glanceneuro/glance-neuro/firmware/include/main.h

#define MAIN_H
#include <stdint.h>
#include "xparameters.h"
#include "xiltimer.h"
#include "lwip/udp.h"
#include "netif/xadapter.h"
#define UDP_PORT 0x6800   // 26624 -- unified data stream (broadband + LFP)
#define TCP_PORT 0x6900   // 26880 -- control channel
#define DEFAULT_UDP_DEST_IP_A   192
#define DEFAULT_UDP_DEST_IP_B   168
#define DEFAULT_UDP_DEST_IP_C   18
#define DEFAULT_UDP_DEST_IP_D   100
#define DEFAULT_UDP_DEST_PORT   0x6800   // 26624 (== UDP_PORT)
#define BEACON_PORT     0x6880   // 26752 -- discovery beacon (subnet broadcast)
#define BEACON_MAGIC    0x4B4C4231u   // distinctive discovery magic ("KLB1")
#define BEACON_VERSION  1
typedef struct {
    uint32_t magic;       // BEACON_MAGIC
    uint32_t version;     // BEACON_VERSION
    uint32_t ip;          // board IPv4, network byte order (== datagram source)
    uint16_t tcp_port;    // control port (TCP_PORT, 0x6900)
    uint16_t udp_port;    // unified data port (UDP_PORT, 0x6800)
    uint32_t fw_version;  // FIRMWARE_VERSION_WORD (maj<<24|min<<16|patch<<8|build)
    uint8_t  mac[6];      // board MAC = unique device id
    uint16_t reserved;    // pad to 28 bytes / 4-byte multiple
} device_beacon_t;
void beacon_init(void);   // create the beacon PCB + compute the broadcast addr
void beacon_send(void);   // broadcast one beacon (call ~1 Hz while link is up)
#define ARM1_BASEADDR 0xFFFFFFF0
#define ARM1_STARTADR 0x20000000
#define sev() __asm__("sev")
#define BRAM_BASE_ADDR          0x80000000
#define BYTES_PER_WORD          4           // 32-bit words
#define BRAM_SIZE_WORDS         16384       // 16384 x 32-bit words (64KB)
#define BRAM_SIZE_BYTES         (BRAM_SIZE_WORDS * BYTES_PER_WORD)   // 64KB
#define UNIFIED_MAGIC           0xCAFEBABE
#define UNIFIED_VERSION         1
#define UNIFIED_HEADER_WORDS    8
#define STREAM_TYPE_BROADBAND   1
#define STREAM_TYPE_LFP         2
#define BB_SUBBLOCK_WORDS       6
#define PACKET_HEADER_WORDS     (UNIFIED_HEADER_WORDS + BB_SUBBLOCK_WORDS) // 14
#define MAX_PACKET_DATA_WORDS   140         // Maximum data words (all 8 streams = both ports)
#define MIN_PACKET_DATA_WORDS   18          // Minimum data words (1 stream enabled)
#define MAX_WORDS_PER_PACKET    (PACKET_HEADER_WORDS + MAX_PACKET_DATA_WORDS) // 154 words
#define MIN_WORDS_PER_PACKET    (PACKET_HEADER_WORDS + MIN_PACKET_DATA_WORDS) // 32 words
#define BRAM_READ_DMA     0
#define BRAM_READ_SINGLE  1
#define BRAM_READ_METHOD  BRAM_READ_DMA
#define PL_CTRL_BASE_ADDR 0x40000000
#define PL_N_CTRL_REGS      28
#define CTRL_REG_0_OFFSET   (0 * 4)   // Enable transmission, reset timestamp, debug mode
#define CTRL_REG_1_OFFSET   (1 * 4)   // Loop count
#define CTRL_REG_2_OFFSET   (2 * 4)   // Phase select, channel enable
#define CTRL_REG_3_OFFSET   (3 * 4)   // Analytic chirp NCO config (see data_generator_core.sv)
#define CTRL_REG_MOSI_START_OFFSET  (CTRL_REG_0_OFFSET + (4 * 4)) // Offset for MOSI control words
#define CTRL_CHIRP_MODE          (1u << 0)
#define CTRL_CHIRP_STRIDE_SHIFT  2
#define CTRL_CHIRP_STRIDE_MASK   (0x3Fu << 2)
#define CTRL_CHIRP_FSPAN_SHIFT   8
#define CTRL_CHIRP_FSPAN_MASK    (0xFFFu << 8)
#define CTRL_CHIRP_RATE_SHIFT    20
#define CTRL_CHIRP_RATE_MASK     (0xFFFu << 20)
#define CTRL_REG_AUX_CTRL_OFFSET    (22 * 4)  // prog bank select + fast settle/digout/dsp config
#define CTRL_REG_AUX_WRITE_OFFSET   (23 * 4)  // write port payload (RT reg / program)
#define CTRL_REG_AUX_STROBE_OFFSET  (24 * 4)  // write/inject toggles + inject command
#define CTRL_REG_LFP_CFG_OFFSET     (25 * 4)  // [0]en [15:8]lane_mask [23:16]decim_R [31:24]num_taps
#define CTRL_REG_LFP_COEF_OFFSET    (26 * 4)  // [17:0] signed Q1.17 coefficient data
#define CTRL_REG_LFP_STROBE_OFFSET  (27 * 4)  // [0] coef toggle, [1] ptr clear, [2] stage select
#define LFP_STROBE_COEF_TOGGLE      (1u << 0)
#define LFP_STROBE_PTR_CLR          (1u << 1)
#define LFP_STROBE_STAGE_SEL        (1u << 2)  // 0 = stage 1 halfband, 1 = stage 2 decimator
#define LFP_DECIM_STAGE1            2       // halfband:  30 kHz -> 15 kHz
#define LFP_DECIM_STAGE2            5       // decimator: 15 kHz ->  3 kHz
#define LFP_DECIM_TOTAL             (LFP_DECIM_STAGE1 * LFP_DECIM_STAGE2)  // 10
#define LFP_HB_TAPS                 11      // stage-1 length (fixed)
#define LFP_MAX_POLY_TAPS           120     // stage-2 maximum length
#define LFP_STAGE_HALFBAND          0
#define LFP_STAGE_DECIMATOR         1
#define LFP_BRAM_BASE_ADDR          0x84000000
#define LFP_BRAM_SIZE_WORDS         16384      // 64 KB ring of 32-bit words (2x16-bit samples)
#define AUX_CTRL_BANK_BIT(slot)     (1u << (slot))   // slot == 0 -> reg22 bit 0
#define AUX_CTRL_BANK_SEL_MASK      (0x1u << 0)       // [0] only
#define AUX_CTRL_FS_SW              (1u << 4)  // software amp fast settle level
#define AUX_CTRL_FS_GPIO_EN         (1u << 5)
#define AUX_CTRL_FS_GPIO_SEL_SHIFT  6          // [8:6] digital_in pin select
#define AUX_CTRL_FS_GPIO_SEL_MASK   (0x7u << 6)
#define AUX_CTRL_DSP_SW             (1u << 9)  // software DSP-reset (CONVERT bit H) level
#define AUX_CTRL_DSP_GPIO_EN        (1u << 10)
#define AUX_CTRL_DSP_GPIO_SEL_SHIFT 11         // [13:11]
#define AUX_CTRL_DSP_GPIO_SEL_MASK  (0x7u << 11)
#define AUX_CTRL_DIGOUT_SW          (1u << 14) // software digout level
#define AUX_CTRL_DIGOUT_GPIO_EN     (1u << 15)
#define AUX_CTRL_DIGOUT_GPIO_SEL_SHIFT 16      // [18:16]
#define AUX_CTRL_DIGOUT_GPIO_SEL_MASK  (0x7u << 16)
#define AUX_CTRL_REG3_STATIC_SHIFT  24         // [31:24] RHD Reg-3 bits D7..D1 (D0 = live digout)
#define AUX_CTRL_REG3_STATIC_MASK   (0xFFu << 24)
#define AUX_WRITE_PACK(target, bank, is_len, addr, data) \
    ( ((uint32_t)(data) & 0xFFFFu)            | \
      (((uint32_t)(addr) & 0x3Fu)   << 16)    | \
      (((uint32_t)(target) & 0x3u)  << 22)    | \
      (((uint32_t)(bank) & 0x1u)    << 24)    | \
      (((uint32_t)(is_len) & 0x1u)  << 25) )
#define AUX_LENGTH_DATA(loop_idx, end_idx) \
    ( ((uint32_t)(loop_idx) & 0x3Fu) | (((uint32_t)(end_idx) & 0x3Fu) << 8) )
#define AUX_STROBE_WRITE_TOGGLE     (1u << 0)
#define AUX_STROBE_INJECT_TOGGLE    (1u << 1)
#define AUX_STROBE_INJECT_CMD_SHIFT 16         // [31:16] injected command (slot-2 one-shot)
#define AUX_BANK_ENTRIES            64
#define STATUS_REG_BASE      (PL_N_CTRL_REGS * 4)
#define STATUS_REG_0_OFFSET  (STATUS_REG_BASE + 0 * 4)   // Dynamic status + counters
#define STATUS_REG_1_OFFSET  (STATUS_REG_BASE + 1 * 4)   // Reflected control parameters
#define STATUS_REG_2_OFFSET  (STATUS_REG_BASE + 2 * 4)   // Packets sent
#define STATUS_REG_3_OFFSET  (STATUS_REG_BASE + 3 * 4)   // Timestamp low [31:0]
#define STATUS_REG_4_OFFSET  (STATUS_REG_BASE + 4 * 4)   // Timestamp high [63:32]
#define STATUS_REG_5_OFFSET  (STATUS_REG_BASE + 5 * 4)   // Loop count (registered)
#define STATUS_REG_6_OFFSET  (STATUS_REG_BASE + 6 * 4)   // Mirror of CTRL_REG_0 (enable, reset, etc.)
#define STATUS_REG_7_OFFSET  (STATUS_REG_BASE + 7 * 4)   // Mirror of CTRL_REG_1 (loop count)
#define STATUS_REG_8_OFFSET  (STATUS_REG_BASE + 8 * 4)   // Mirror of CTRL_REG_2 (phase select, debug mode)
#define STATUS_REG_9_OFFSET  (STATUS_REG_BASE + 9 * 4)   // Mirror of CTRL_REG_3 (reserved)
#define STATUS_REG_10_OFFSET (STATUS_REG_BASE + 10 * 4)  // BRAM write address + FIFO count (added by wrapper)
#define STATUS_REG_11_OFFSET (STATUS_REG_BASE + 11 * 4)  // Aux sequencer status
#define STATUS_REG_12_OFFSET (STATUS_REG_BASE + 12 * 4)  // Aux injected-command read result
#define STATUS_REG_13_OFFSET (STATUS_REG_BASE + 13 * 4)  // LFP: [15:0] BRAM wr byte-addr, [16] overrun
#define AUX_STATUS_BANK_ACTIVE_MASK  0x7u      // [2:0] active bank per slot (bit0=slot0 program)
#define AUX_STATUS_ENGINE_ON         (1u << 3) // always 1 (aux engine always on)
#define AUX_STATUS_FS_ACTIVE         (1u << 4)
#define AUX_STATUS_DIGOUT            (1u << 5)
#define AUX_STATUS_DSP_ACTIVE        (1u << 6)
#define AUX_STATUS_INJECT_ACK        (1u << 7) // toggles when an injection result lands
#define AUX_STATUS_IDX0_SHIFT        8         // [13:8]  slot-0 program index
#define AUX_STATUS_IDX1_SHIFT        16        // [21:16] slot-1 index (always 0: fs register)
#define AUX_STATUS_IDX2_SHIFT        24        // [29:24] slot-2 index (always 0: inject register)
#define AUX_STATUS_IDX_MASK          0x3Fu
#define RHD_CMD_CONVERT(ch)     ((uint16_t)(((ch) & 0x3F) << 8))
#define RHD_CMD_WRITE(reg, val) ((uint16_t)(0x8000 | (((reg) & 0x3F) << 8) | ((val) & 0xFF)))
#define RHD_CMD_READ(reg)       ((uint16_t)(0xC000 | (((reg) & 0x3F) << 8)))
#define CTRL_ENABLE_TRANSMISSION (1 << 0)
#define CTRL_RESET_TIMESTAMP     (1 << 1)
#define CTRL_DEBUG_MODE          (1 << 3)   // Debug mode (send dummy data) [3]
#define CTRL_PHASE0_MASK         (0xF << 0)   // phase_a0 [3:0]   (cable A, line 0)
#define CTRL_PHASE1_MASK         (0xF << 4)   // phase_a1 [7:4]   (cable A, line 1)
#define CTRL_PHASE2_MASK         (0xF << 8)   // phase_b0 [11:8]  (cable B, line 0)
#define CTRL_PHASE3_MASK         (0xF << 12)  // phase_b1 [15:12] (cable B, line 1)
#define CTRL_CHANNEL_ENABLE_MASK (0xFF << 16) // channel_enable [23:16]
#define CTRL_CHANNEL_ENABLE_SHIFT 16
#define STATUS_TRANSMISSION_ACTIVE   (1 << 0)
#define STATUS_LOOP_LIMIT_REACHED    (1 << 1)
#define STATUS_STATE_COUNTER_MASK    (0x7F << 3)  // [9:3] - 7 bits
#define STATUS_STATE_COUNTER_SHIFT   3
#define STATUS_CYCLE_COUNTER_MASK    (0x3F << 11) // [16:11] - 6 bits
#define STATUS_CYCLE_COUNTER_SHIFT   11
#define STATUS_ENABLE_TRANSMISSION_REG  (1 << 0)
#define STATUS_RESET_TIMESTAMP_REG      (1 << 1)
#define STATUS_DEBUG_MODE_REG           (1 << 3)
#define STATUS_PHASE0_REG_MASK          (0xF << 12) // [15:12] - 4 bits
#define STATUS_PHASE0_REG_SHIFT         12
#define STATUS_PHASE1_REG_MASK          (0xF << 16) // [19:16] - 4 bits
#define STATUS_PHASE1_REG_SHIFT         16
#define STATUS_CHANNEL_ENABLE_REG_MASK  (0xF << 20) // [23:20] - port-0 channel enable
#define STATUS_CHANNEL_ENABLE_REG_SHIFT 20
#define STATUS_CHANNEL_ENABLE_HI_REG_MASK  (0xF << 24) // [27:24] - port-1 channel enable
#define STATUS_CHANNEL_ENABLE_HI_REG_SHIFT 24
#define DEVICE_TYPE_INTAN_INTERFACE    0x1000
#define UDP_PACKET_FORMAT_V1           0x0001
#define PROTOCOL_VERSION               1
#define FIRMWARE_VERSION_MAJOR         3
#define FIRMWARE_VERSION_MINOR         0   // 3.0.0.0: the board is no longer one fixed fabric. It carries
#define FIRMWARE_VERSION_PATCH         0   // reset by the 3.0.0.0 MAJOR bump. (2.2.0.1 was
#define FIRMWARE_VERSION_BUILD         0
#define FIRMWARE_VERSION_WORD          ((FIRMWARE_VERSION_MAJOR << 24) | \
                                       (FIRMWARE_VERSION_MINOR << 16) | \
                                       (FIRMWARE_VERSION_PATCH << 8) | \
                                       FIRMWARE_VERSION_BUILD)
#define ACK_SUCCESS         0x06
#define ACK_ERROR           0x15
typedef struct __attribute__((packed)) {
    uint16_t version;
    uint16_t device_type;
    uint32_t firmware_version;
    uint64_t timestamp;
    uint32_t packets_sent;
    uint32_t bram_write_addr;
    uint16_t fifo_count;
    uint8_t  state_counter;
    uint8_t  cycle_counter;
    uint8_t  flags_pl;
    uint8_t  reserved1;
    uint32_t packets_received;
    uint32_t error_count;
    uint32_t udp_packets_sent;
    uint32_t udp_send_errors;
    uint32_t ps_read_addr;
    uint32_t packet_size;
    uint8_t  flags_ps;
    uint8_t  reserved2[3];
    uint32_t loop_count;
    uint8_t  phase0;
    uint8_t  phase1;
    uint8_t  channel_enable;
    uint8_t  debug_mode;
    uint32_t reserved3[2];
    uint32_t udp_dest_ip;
    uint16_t udp_dest_port;
    uint16_t udp_packet_format;
    uint32_t udp_bytes_sent;
    uint32_t aux_read_result;   // last injected command's response {cipo1, cipo0}
    uint8_t  aux_bank_active;   // [2:0] active bank per slot
    uint8_t  aux_flags;         // bit0 seq_en, bit1 fs_active, bit2 digout, bit3 dsp, bit4 inject_ack
    uint8_t  aux_idx[3];        // per-slot sequence index
    uint8_t  reserved5[3];
    uint32_t dma_errors;        // CDMA read failures since boot
    uint32_t dma_ticks_last;    // last CDMA transfer (ticks)
    uint32_t dma_ticks_max;     // worst CDMA transfer (ticks)
    uint32_t loop_ticks_last;   // last receive->transmit (ticks)
    uint32_t loop_ticks_max;    // worst receive->transmit (ticks; vs 33us budget)
    uint32_t timer_hz;          // tick frequency, for host ticks->us conversion
    uint32_t aux_ctrl;
    uint8_t  rhd_reg[22];
    uint8_t  lfp_enable;        // engine enabled
    uint8_t  lfp_lane_mask;     // which of 8 streams are LFP-filtered
    uint8_t  lfp_decim_R;       // decimation factor (packets per output)
    uint8_t  lfp_num_taps;      // active FIR length
    uint32_t lfp_packets_sent;  // LFP UDP packets emitted
    uint8_t  lfp_overrun;       // sticky compute-overrun flag
    uint8_t  lfp_reserved[3];
    uint8_t  chirp_mode;        // 1 = chirp debug signal enabled
    uint8_t  chirp_stride;      // per-channel phase stride (6-bit)
    uint16_t chirp_fspan;       // f_max field (12-bit)
    uint16_t chirp_rate;        // sweep_rate field (12-bit)
    uint8_t  chirp_reserved[2];
    uint32_t send_ticks_last;   // last udp_sendto() call (ticks)
    uint32_t send_ticks_max;    // worst udp_sendto() call (ticks)
    uint32_t over_budget_count; // packets whose loop_ticks exceeded the 33.3 us budget
    uint32_t worst_pkt_index;   // packets_received_count at the worst-loop packet
    uint32_t worst_cdma_ticks;  // that packet's CDMA time (ticks)
    uint32_t worst_send_ticks;  // that packet's udp_sendto time (ticks)
    uint32_t worst_other_ticks; // that packet's loop - cdma - send (ticks)
    uint32_t loop_hist[6];      // counts per bucket
    uint32_t bb_pbuf_alloc_fail;  // broadband: pbuf_alloc returned NULL
    uint32_t bb_send_err;         // broadband: udp_sendto() != ERR_OK
    int32_t  bb_last_send_err;    // broadband: last err_t (ERR_MEM = -1, ...)
    uint32_t lfp_pbuf_alloc_fail; // LFP: pbuf_alloc returned NULL
    uint32_t lfp_send_err;        // LFP: udp_sendto() != ERR_OK
    int32_t  lfp_last_send_err;   // LFP: last err_t
    uint32_t first_drop_pkt;      // packets_received_count at the first broadband drop
    uint32_t last_drop_pkt;       // ... at the most recent broadband drop
    uint32_t memp_num_pbuf;       // = MEMP_NUM_PBUF (shared zero-copy pool size)
    uint32_t drop_ring[8];        // last 8 broadband drop packet indices (clustering)
} status_response_t;
#define PERF_HIST_BUCKETS   6
#define STATUS_PL_TRANSMISSION_ACTIVE  (1 << 0)
#define STATUS_PL_LOOP_LIMIT_REACHED   (1 << 1)
#define STATUS_PS_STREAM_ENABLED       (1 << 0)
extern XTimer timer;
extern struct netif server_netif;
extern struct udp_pcb *udp;
extern volatile int stream_enabled;
extern uint32_t packets_received_count;
extern volatile int pl_is_acq;
extern volatile int pl_has_iic_a;
extern volatile int pl_has_iic_b;
extern volatile int pl_has_iic;
int pl_config_apply(uint32_t sel, uint32_t *out_bytes, uint8_t *out_is_acq);
int pl_current_config(void);   // -1 blank, else pl_configs index (for CMD_PL_STATUS)
extern volatile int enable_streaming_flag;
extern volatile int disable_streaming_flag;
extern volatile int reset_timestamp_flag;
extern volatile int cable_test_flag;
extern uint32_t ps_read_address;              // Current PS read position (word address)
extern uint32_t current_packet_size;          // Current expected packet size in 32-bit words
extern uint32_t current_channel_enable;       // Current channel enable setting
extern uint64_t expected_timestamp;
extern uint32_t error_count;
extern uint32_t timestamp_gaps;
extern uint32_t dma_errors;
extern uint32_t dma_ticks_last, dma_ticks_max;
extern uint32_t loop_ticks_last, loop_ticks_max;
extern uint32_t perf_timer_hz;
extern uint32_t send_ticks_last, send_ticks_max;
extern uint32_t over_budget_count;
extern uint32_t worst_pkt_index, worst_cdma_ticks, worst_send_ticks, worst_other_ticks;
extern uint32_t loop_hist[PERF_HIST_BUCKETS];
extern uint32_t bb_pbuf_alloc_fail, bb_send_err;
extern uint32_t bb_send_retries, bb_pbuf_retries, bb_send_recovered;
extern uint32_t staging_slot;   // rotating zero-copy staging-ring slot
extern int32_t  bb_last_send_err;
extern uint32_t lfp_pbuf_alloc_fail, lfp_send_err;
extern int32_t  lfp_last_send_err;
extern uint32_t first_drop_pkt, last_drop_pkt;
extern uint32_t drop_ring[8];
extern uint32_t drop_ring_idx;
void perf_reset(void);   // clear sticky maxes + histogram + counts (CMD_PERF_RESET)
extern uint32_t udp_packets_sent;
extern uint32_t udp_send_errors;
extern uint32_t udp_dest_ip;      // Network byte order
extern uint16_t udp_dest_port;
void handle_enable_streaming(void);
void handle_disable_streaming(void);
void handle_reset_timestamp(void);
void process_command_flags(void);
uint32_t calculate_packet_size(int channel_enable);
uint32_t calculate_data_words(int channel_enable);
void update_current_packet_size(void);
void network_maintenance_loop(void);
void pl_set_transmission(int enable);
void pl_reset_timestamp(void);
void pl_set_loop_count(uint32_t loop_count);
void pl_set_phase_select(int phase0, int phase1);
void pl_set_phase_select_b(int phase2, int phase3);  // port B (second cable)
void pl_set_debug_mode(int enable);
void pl_set_channel_enable(int channel_enable);
void pl_set_chirp(uint8_t mode, uint8_t stride, uint16_t fspan, uint16_t rate);  // CTRL_REG_3
uint32_t pl_get_chirp_cfg(void);  // raw CTRL_REG_3 read-back
extern uint8_t  chirp_cfg_mode, chirp_cfg_stride;
extern uint16_t chirp_cfg_fspan, chirp_cfg_rate;
uint64_t pl_get_timestamp(void);
int pl_is_transmission_active(void);
uint32_t pl_get_packets_sent(void);
int pl_is_loop_limit_reached(void);
uint32_t pl_get_bram_write_address(void);
uint32_t pl_get_state_counter(void);
uint32_t pl_get_cycle_counter(void);
uint32_t pl_get_current_loop_count(void);
int pl_get_current_phase_select(int *phase0, int *phase1);
int pl_get_current_debug_mode(void);
int pl_get_current_channel_enable(void);
uint32_t pl_get_current_control_flags(void);
void pl_print_status(void);
void pl_dump_bram_data(uint32_t start_addr, uint32_t word_count);
void pl_set_copi_commands(const uint16_t copi_array[32]);
int pl_set_copi_commands_safe(const uint16_t copi_array[32], const char* sequence_name);
void pl_set_convert_sequence(void);
void pl_set_initialization_sequence(void);
void pl_rhd_shadow_init(void);          // seed the RHD register shadow from the init sequence
extern uint8_t rhd_reg_shadow[22];      // mirror of RHD regs 0..21 (commanded state)
void pl_set_cable_length_sequence(void);
void pl_aux_write_word(int slot, int bank, int addr, uint16_t data);
void pl_aux_write_length(int slot, int bank, int loop_idx, int end_idx);
int  pl_aux_upload_bank(int slot, int bank, const uint16_t *cmds, int n, int loop_idx);
void pl_aux_select_bank(int slot, int bank);
int  pl_aux_confirm_bank(int slot, int bank, int timeout_ms);
void pl_aux_set_fast_settle(uint32_t cfg);   // AUX_CTRL fs/dsp bit fields [13:4]
void pl_aux_set_digout(uint32_t cfg);        // AUX_CTRL digout fields [18:14] + reg3_static [31:24]
int  pl_aux_inject(uint16_t cmd, uint32_t *result, int timeout_ms);
int  pl_read_rhd_register(int reg, uint32_t *result);
int  pl_write_rhd_register(int reg, uint8_t value, uint32_t *result);
void pl_run_full_cable_test(void);
extern const uint16_t convert_cmd_sequence[32];
extern const uint16_t initialization_cmd_sequence[32];
extern const uint16_t cable_length_cmd_sequence[32];
uint32_t sys_now(void);
void start_tcp_server(void);
void broadband_stream_init(void);   // creates the broadband UDP pcb (stream_type=1)
int udp_reconfigure_destination(uint32_t new_ip, uint16_t new_port);
int is_valid_udp_dest(uint32_t ip, uint16_t port);
void collect_status_data(status_response_t* status);
void abort_tcp_connections(void);
void stop_tcp_server(void);
void stop_udp_stream(void);
void pl_lfp_set_config(uint8_t enable, uint8_t num_taps);  // decimation is structural (/10)
void pl_lfp_coef_begin(int stage);                        // select a filter, clear its write pointer
void pl_lfp_coef_push(int32_t coef);                      // write one 18-bit Q1.17 tap
void pl_lfp_upload_coeffs(int stage, const int32_t *coeffs, int n);  // begin + push array
uint32_t pl_lfp_read_status(void);                        // STATUS_REG_13
void broadband_stream_service(void);   // broadband: drain every ready packet
void lfp_stream_init(void);
void lfp_stream_service(void);   // call from the core-0 main loop, after broadband
void lfp_stream_resync(void);    // re-align the PS read pointer after a lane-mask change
extern uint8_t  lfp_cfg_enable, lfp_cfg_decim_R, lfp_cfg_num_taps;
extern uint32_t lfp_udp_packets_sent;
