glanceneuro/glance-neuro/firmware/src-core0/main.c

// SPDX-License-Identifier: MIT
// SPDX-FileCopyrightText: 2025-2026 Caleb Kemere, Reet Sinha, Allen Mikhailov, Rice University

#include "main.h"
#include "platform.h"
#include "pl_stim.h"
#include "sleep.h"
#include <string.h>
#include <stdio.h>
#include "xil_io.h"
#include "xil_cache.h"
#include "lwip/init.h"
#include "lwip/timeouts.h"
#include "lwip/etharp.h"   // etharp_gratuitous() -- proactively refresh host ARP
//#include "xuartps.h"
#include "shared_print.h"
#include "pl_dma.h"
#include "pl_loader.h"  // deferred fabric load from SD via PCAP (docs/boot.md)
#include "pl_imu_stream.h"  // continuous BNO055 readout (stream_type=3)
#include "xiltimer.h"  // XTime_GetTime / COUNTS_PER_SECOND for perf instrumentation

// How long to wait for PHY link before continuing boot. Bounded so a board with
// no cable still reaches the point where core 1 wakes and the serial console
// starts -- see the wait loop for why that matters.
#define LINK_WAIT_TIMEOUT_S 20

// Forward declare eth_link_detect from xemacpsif adapter
// This function is provided by the LWIP library's Xilinx EMAC adapter
extern void eth_link_detect(struct netif *netif);


// Global variables
XTimer timer;
struct netif server_netif;
struct udp_pcb *udp;
volatile int stream_enabled = 0;
uint32_t packets_received_count = 0;


// Link state tracking for hotplug support
volatile int link_is_up = 0;

// Command flags for main loop processing
volatile int enable_streaming_flag = 0;
volatile int disable_streaming_flag = 0;
volatile int reset_timestamp_flag = 0;
volatile int cable_test_flag = 0;

// BRAM state tracking
uint32_t ps_read_address = 0;              // Current PS read position (word address)
uint32_t staging_slot = 0;                 // rotating DDR staging-ring slot (zero-copy TX aliasing fix)
uint32_t current_packet_size = 84;         // 14-word header + 70 data words (0x0F default); recomputed on start
uint32_t current_channel_enable = 0x0F;    // Current channel enable setting (default all channels)

// Packet validation tracking
uint32_t error_count = 0;
uint32_t dma_errors = 0;   // CDMA read failures (BRAM_READ_DMA path)

// Performance instrumentation, observable via get_status. We store raw global-
// timer TICKS at full resolution and let the host convert to microseconds using
// perf_timer_hz (sent in the status) -- store the measurement, derive the
// display. The 30 kHz sample rate gives a 33.3 us budget per packet; loop_ticks
// is the receive->transmit time and dma_ticks is the CDMA transfer within it.
uint32_t dma_ticks_last = 0, dma_ticks_max = 0;     // CDMA transfer (ticks)
uint32_t loop_ticks_last = 0, loop_ticks_max = 0;   // receive->transmit (ticks)
uint32_t perf_timer_hz = 0;                         // tick freq (set in main())
// recv->transmit spike instrumentation. Split the recv->transmit window into the
// CDMA, udp_sendto, and "other" components so the host can attribute the
// occasional ~40 us spike; capture the worst packet's breakdown and a histogram
// + over-budget count for the tail's shape/frequency. Cleared by perf_reset().
uint32_t send_ticks_last = 0, send_ticks_max = 0;   // udp_sendto() call (ticks)
uint32_t over_budget_count = 0;                     // packets over the 33.3 us budget
uint32_t worst_pkt_index = 0;                       // packet idx of the worst loop
uint32_t worst_cdma_ticks = 0, worst_send_ticks = 0, worst_other_ticks = 0;
uint32_t loop_hist[PERF_HIST_BUCKETS] = {0};        // recv->transmit time distribution

// TX drop diagnostics: split udp_send_errors by stream + failure mode and
// record WHEN drops happen. Each zero-copy PBUF_REF send holds one MEMP_PBUF
// entry (MEMP_NUM_PBUF, shared by broadband + LFP) until the GEM TX-done reaps
// it; pbuf_alloc()==NULL => that pool is momentarily empty. Declared before
// perf_reset() so it can clear them. Cleared by CMD_PERF_RESET.
uint32_t bb_pbuf_alloc_fail = 0, bb_send_err = 0;
int32_t  bb_last_send_err = 0;
// NO-LOSS retry stats: bb_send_err counts only drops that survived every retry.
uint32_t bb_send_retries = 0, bb_pbuf_retries = 0, bb_send_recovered = 0;
uint32_t lfp_pbuf_alloc_fail = 0, lfp_send_err = 0;
int32_t  lfp_last_send_err = 0;
uint32_t first_drop_pkt = 0, last_drop_pkt = 0;
uint32_t drop_ring[8] = {0};
uint32_t drop_ring_idx = 0;
// If this fails, the wire layout changed -- update net.py get_status (the length
// check and the struct.unpack offsets) to match.
_Static_assert(sizeof(status_response_t) == 288, "status_response_t size must match net.py get_status");

// Clear the sticky maxes + worst-case snapshot + histogram + counts so the user
// controls the measurement window (CMD_PERF_RESET). Leaves the last-sample fields
// and dma_errors alone -- those self-refresh / are lifetime counters.
void perf_reset(void) {
  dma_ticks_max = 0;
  loop_ticks_max = 0;
  send_ticks_max = 0;
  over_budget_count = 0;
  worst_pkt_index = 0;
  worst_cdma_ticks = worst_send_ticks = worst_other_ticks = 0;
  for (int i = 0; i < PERF_HIST_BUCKETS; i++) loop_hist[i] = 0;
  // TX drop diagnostics
  bb_pbuf_alloc_fail = bb_send_err = 0; bb_last_send_err = 0;
  lfp_pbuf_alloc_fail = lfp_send_err = 0; lfp_last_send_err = 0;
  first_drop_pkt = last_drop_pkt = 0; drop_ring_idx = 0;
  for (int i = 0; i < 8; i++) drop_ring[i] = 0;
}


// UDP transmission
uint32_t udp_packets_sent = 0;
uint32_t udp_send_errors = 0;
// UDP configuration (can be changed via TCP command)
uint32_t udp_dest_ip = 0;      // Will be initialized in main()
uint16_t udp_dest_port = DEFAULT_UDP_DEST_PORT;


// The two stream services live in stream.c; the capture-BRAM read method they
// use is selected in main.h.

// ============================================================================
// PACKET SIZE CALCULATION FUNCTIONS
// ============================================================================

uint32_t calculate_data_words(int channel_enable) {
    int num_channels = 0;
    
    // Count enabled 16-bit streams across both ports (8-bit mask)
    for (int b = 0; b < 8; b++)
        if (channel_enable & (1 << b)) num_channels++;

    if (num_channels == 0) {
        send_message("WARNING: No channels enabled, defaulting to port-0 all channels\r\n");
        return 70; // Default to 4 streams (port 0) x 35 cycles / 2
    }
    
    // Calculate 32-bit words needed for the data
    // Each cycle produces num_channels × 16-bit words
    // Total 16-bit words = 35 × num_channels
    // Convert to 32-bit words with proper rounding up
    uint32_t total_16bit_words = 35 * num_channels;
    uint32_t data_32bit_words = (total_16bit_words + 1) / 2;  // Round up division
    
    return data_32bit_words;
}

uint32_t calculate_packet_size(int channel_enable) {
    return PACKET_HEADER_WORDS + calculate_data_words(channel_enable);
}

void update_current_packet_size(void) {
    uint32_t new_channel_enable = pl_get_current_channel_enable();
    
    if (new_channel_enable != current_channel_enable) {
        current_channel_enable = new_channel_enable;
        current_packet_size = calculate_packet_size(current_channel_enable);
        
        send_message("Updated packet size: channel_enable=0x%X, packet_size=%u words (%u bytes)\r\n",
                     current_channel_enable, current_packet_size, current_packet_size * 4);
    }
}

// ============================================================================
// BRAM ACCESS FUNCTIONS
// ============================================================================


// Check how many complete packets are available to read


// ============================================================================
// STREAMING CONTROL
// ============================================================================

// ============================================================================
// PL CONFIGURATION SWAP (docs/boot.md)
// ============================================================================
// The shared 2nd-CIPO lane is LVDS (128-ch) or single-ended (I2C IMU / 64-ch)
// per port; IOSTANDARD is fixed per bitstream, so changing a port's mode means
// PCAP-loading a different full bitstream. We only swap when NOT streaming (so
// nothing is in flight on the PL AXI) and reset the master timestamp on each
// swap so the host sees a fresh epoch.

// 1 while an acquisition fabric is live -- gates every PL-touching service so a
// scan (non-acq) fabric, or a mid-swap teardown, can't hang the core on AXI to
// registers that aren't there.
volatile int pl_is_acq = 0;

// Per-port: 1 while the loaded fabric exposes that cable's AXI IIC (port A at
// 0x43D0, port B at 0x43D1) for a BNO055. CMD_DETECT_IMU probes a port ONLY if
// its flag is set: a mixed fabric (acq_imu_port_a/_b) carries one IIC and leaves
// the other port 128-ch LVDS with NO I2C, and touching that absent AXI slave
// hangs the core forever. pl_has_iic is the OR (any IIC present) that gates the
// command itself so plain acq -- which has neither -- refuses it outright.
volatile int pl_has_iic_a = 0;
volatile int pl_has_iic_b = 0;
volatile int pl_has_iic   = 0;

// selector -> SD file (no .bin), is it an acquisition fabric, does it carry the
// AXI IICs? Selectors are append-only so the host mapping (net.py CONFIGS) stays
// stable. Later variants add acq_imu_port_a / _b (one IIC + one 128-ch LVDS port).
// The `file` field MUST be an 8.3 short name (<=8-char base): the loader's xilffs
// is built with FF_USE_LFN=0, so f_open on a longer name fails PL_ERR_OPEN even
// when the file is present. Hence acq_imu_both's blob is "aimuboth.bin", not
// "acq_imu_both.bin" (12-char base). The host-facing `name` is unconstrained.
typedef struct { const char *name; const char *file; int is_acq; int iic_a; int iic_b; } pl_config_t;
static const pl_config_t pl_configs[] = {
  { "acquisition",    "acq",      1, 0, 0 },   // 128-ch LVDS acquisition, no IMU
  { "acq_imu_both",   "aimuboth", 1, 1, 1 },   // both cables 64-ch + a BNO055 each
  { "acq_imu_port_a", "aimu_a",   1, 1, 0 },   // port A 64-ch + IMU (iic_a), port B 128-ch LVDS
  { "acq_imu_port_b", "aimu_b",   1, 0, 1 },   // port A 128-ch LVDS, port B 64-ch + IMU (iic_b)
};
#define PL_NUM_CONFIGS ((uint32_t)(sizeof(pl_configs) / sizeof(pl_configs[0])))
// Which fabric BOOT.bin bakes in (scripts/boot_acq_loader.bif stages the matching
// .bit). Keep the two in step: this only names what the FSBL already loaded, so a
// mismatch would have the firmware describe the PL wrongly, not misconfigure it.
#define PL_CONFIG_BAKED 0   /* "acquisition" -- 128-ch, works with any headstage */
static int current_config = -1;

// Which fabric the loader last programmed (-1 = none/blank, else a pl_configs
// index). Read-only accessor for CMD_PL_STATUS: it reads this firmware state, not
// PL registers, so a reconnecting host can learn the config in ANY fabric state.
int pl_current_config(void) { return current_config; }

// Acquisition PL init, split so boot can keep the known-good 2c-i ordering:
//  - early: CDMA + LFP config. At boot this runs BEFORE the network (load-first,
//    for link stability); its few send_messages match what 2c-i buffered.
//  - late: the send_message-HEAVY register setup. At boot this must run AFTER
//    core1 is awake and draining the print ring -- running it before core1
//    flooded the ring and raced core0/core1 on the shared UART, hanging the boot.
// A runtime swap (core1 long since up) just calls the full acq_pl_bringup().
static void acq_pl_init_early(void) {
#if BRAM_READ_METHOD == BRAM_READ_DMA
  pl_dma_init();  // AXI CDMA + non-cacheable DDR staging buffer for the read path
#endif
  pl_lfp_set_config(/*enable=*/0, /*num_taps=*/LFP_MAX_POLY_TAPS);
}
static void acq_pl_init_late(void) {
  pl_set_transmission(0);
  pl_set_loop_count(0);
  update_current_packet_size();
  pl_set_copi_commands(initialization_cmd_sequence);
  pl_stim_boot_init();  // DAC to its safe state (docs/stim.md)
}
static void acq_pl_bringup(void) { acq_pl_init_early(); acq_pl_init_late(); }

// Load the config with the given selector via PCAP. Caller MUST guarantee we are
// not streaming. Resets the master timestamp on a successful acquisition load.
// Returns 0 ok, positive pl_status_t on load failure, -1 on a bad selector.
int pl_config_apply(uint32_t sel, uint32_t *out_bytes, uint8_t *out_is_acq) {
  if (sel >= PL_NUM_CONFIGS) return -1;
  const pl_config_t *c = &pl_configs[sel];
  if (out_is_acq) *out_is_acq = (uint8_t)c->is_acq;
  // Shut the serial console's INPUT for the duration. Clearing the PL floats
  // the EMIO UART RX ball, and core 1 would otherwise parse the resulting noise
  // as a debug command -- "dump" with a garbage count, or "start" -- either of
  // which leaves the board unresponsive. Output is unaffected (it is merely
  // lost on the wire while the pins are gone).
  command_flags->serial_input_ok = 0;
  pl_imu_stream_stop_all();              // the IICs it polls are about to vanish
  pl_is_acq = 0;                         // tearing the PL down -> stop touching it
  pl_has_iic_a = pl_has_iic_b = pl_has_iic = 0;  // its IICs are gone until reloaded
  uint32_t bytes = 0;
  pl_status_t st = pl_loader_load(c->file, &bytes);
  if (out_bytes) *out_bytes = bytes;
  if (st != PL_OK) {
    current_config = -1;
    command_flags->serial_input_ok = 1;   // failed load: pins are as they were
    return (int)st;
  }
  current_config = (int)sel;
  pl_has_iic_a = c->iic_a;               // per-port IIC presence (0x43D0 / 0x43D1)
  pl_has_iic_b = c->iic_b;
  pl_has_iic   = c->iic_a || c->iic_b;   // any IIC -> CMD_DETECT_IMU is allowed
  // The fabric is back, so the console pins are real again. Core 1 flushes
  // whatever noise arrived while the gate was shut before honouring input.
  command_flags->serial_input_ok = 1;
  if (c->is_acq) {
    acq_pl_bringup();
    pl_reset_timestamp();                // new fabric -> fresh timeline for the host
    pl_is_acq = 1;
  }
  send_message("Config '%s' loaded (%lu bytes)%s\r\n", c->name,
               (unsigned long)bytes,
               c->is_acq ? ", acquisition ready" : " (non-acquisition fabric)");
  return 0;
}

void handle_enable_streaming(void) {
  if (stream_enabled) {
    send_message("Streaming already enabled\r\n");
    return;
  }
  if (!pl_is_acq) {
    send_message("Cannot start: no acquisition fabric loaded (set_config first)\r\n");
    return;
  }

    // Update packet size before starting streaming
    update_current_packet_size();
  
  // Reset state
  packets_received_count = 0;
  error_count = 0;
  udp_packets_sent = 0;
  udp_send_errors = 0;
  
  // Reset PL
  pl_set_transmission(0);
  usleep(100);
  pl_reset_timestamp();
  usleep(1000);

  // Enable streaming
  stream_enabled = 1;
  pl_set_transmission(1);

  // Re-sync ps_read to a REAL packet boundary by scanning for the header.
  // A stop can interrupt the datapath mid-packet; since write_address, the
  // packet boundary, and the (intentionally unreset) FIFO are only cleared by
  // the hardware reset -- not by stop/restart -- the fresh header on restart can
  // land a few words off packet_boundary_address. Setting ps_read to the
  // pointer then mis-aligns and the header check loops forever. So: let the PL
  // write several packets, then walk back from the write pointer to the nearest
  // unified header (word0=MAGIC, word1=broadband TYPE_VER) and align to it
  // (single Xil_In32 reads are clean).
  usleep(3000);  // ~90 packets @30ksps -- guarantees fresh complete packets
  uint32_t wp = pl_get_bram_write_address();
  uint32_t expected_typever =
      (uint32_t)STREAM_TYPE_BROADBAND | ((uint32_t)UNIFIED_VERSION << 8);
  int synced = 0;
  for (uint32_t back = 0; back < 2 * current_packet_size + 16; back++) {
    uint32_t a = (wp + BRAM_SIZE_WORDS - back) % BRAM_SIZE_WORDS;
    uint32_t b = (a + 1) % BRAM_SIZE_WORDS;
    if (Xil_In32(BRAM_BASE_ADDR + a * 4) == UNIFIED_MAGIC &&                       // word0 MAGIC  // DMA-EXEMPT: 2-word resync header peek (clean 1-beat reads while re-aligning ps_read)
        (Xil_In32(BRAM_BASE_ADDR + b * 4) & 0xFFFFu) == (expected_typever & 0xFFFFu)) { // word1 TYPE_VER // DMA-EXEMPT: 2-word resync header peek (clean 1-beat reads while re-aligning ps_read)
      ps_read_address = a;
      synced = 1;
      break;
    }
  }
  if (!synced) {
    ps_read_address = wp;   // fallback; the magic-fail recovery will retry
    send_message("Restart: no magic found near wp=%u, using write ptr\r\n", wp);
  } else {
    send_message("Restart: ps_read re-synced to magic at %u (wp=%u)\r\n",
                 ps_read_address, wp);
  }

  send_message("BRAM streaming STARTED (packet size: %u words)\r\n", current_packet_size);
}

void handle_disable_streaming(void) {
  if (!stream_enabled) {
    send_message("Streaming already disabled\r\n");
    return;
  }
  
  stream_enabled = 0;
  pl_set_transmission(0);
  
  send_message("BRAM streaming STOPPED\r\n");
  send_message("Summary: %u packets processed, %u errors\r\n",
       packets_received_count, error_count);
  send_message("UDP: %u packets sent, %u errors\r\n", udp_packets_sent, udp_send_errors);
}

void handle_reset_timestamp(void) {
  packets_received_count = 0;
  error_count = 0;
  udp_packets_sent = 0;
  udp_send_errors = 0;
  pl_reset_timestamp();
  send_message("Timestamp and counters RESET\r\n");
}

void process_command_flags(void) {
  if (command_flags->enable_streaming_flag) {
    command_flags->enable_streaming_flag = 0;
    handle_enable_streaming();
    command_flags->lock = 0;
  }
  
  if (command_flags->disable_streaming_flag) {
    command_flags->disable_streaming_flag = 0;
    handle_disable_streaming();
    command_flags->lock = 0;
  }
  
  if (command_flags->reset_timestamp_flag) {
    command_flags->reset_timestamp_flag = 0;
    handle_reset_timestamp();
    command_flags->lock = 0;
  }

  if (command_flags->pl_print_flag) {
    command_flags->pl_print_flag = 0;
    pl_print_status();
    command_flags->lock = 0;
  }

  if (command_flags->dump_bram_flag) {
    command_flags->dump_bram_flag = 0;
    pl_dump_bram_data(command_flags->start_bram_addr, command_flags->word_count);
    command_flags->lock = 0;
  }

  if (command_flags->cable_test_flag) {
    command_flags->cable_test_flag = 0;
    pl_run_full_cable_test();
    handle_enable_streaming();
    command_flags->lock = 0;
  }
}

// Network maintenance loop
// Publish a binary status snapshot to shared memory for core 1 to format/print.
// Cheap, bounded, non-blocking: ~15 PL register reads + plain stores, no string
// formatting and no print ring. seqlock (odd while writing) lets core 1 read a
// consistent snapshot. Core 0 does no console I/O of its own on this path.
static void publish_status_snapshot(void) {
  uint32_t s0 = psmon->seq;
  psmon->seq = s0 | 1u;          // mark odd: update in progress
  dsb();

  uint64_t ts = pl_get_timestamp();
  psmon->timestamp_lo   = (uint32_t)ts;
  psmon->timestamp_hi   = (uint32_t)(ts >> 32);
  psmon->packets_sent   = pl_get_packets_sent();
  psmon->bram_write_addr= pl_get_bram_write_address();
  psmon->fifo_count     = (Xil_In32(PL_CTRL_BASE_ADDR + STATUS_REG_10_OFFSET) >> 14) & 0x1FF;
  psmon->state_counter  = pl_get_state_counter();
  psmon->cycle_counter  = pl_get_cycle_counter();
  psmon->channel_enable = pl_get_current_channel_enable();
  int p0, p1;
  pl_get_current_phase_select(&p0, &p1);
  // port-B phase2/phase3 read from the CTRL_REG_2 mirror (status reg 8): reg 8
  // mirrors CTRL_REG_2 verbatim, so phase_b0 is at [11:8], phase_b1 at [15:12].
  uint32_t cr2 = Xil_In32(PL_CTRL_BASE_ADDR + STATUS_REG_8_OFFSET);
  psmon->phase          = (p0 & 0xF) | ((p1 & 0xF) << 4)
                        | (((cr2 >> 8) & 0xF) << 8) | (((cr2 >> 12) & 0xF) << 12);
  psmon->flags_pl       = (pl_is_transmission_active() ? PSMON_FLAG_TX_ACTIVE : 0)
                        | (pl_is_loop_limit_reached()  ? PSMON_FLAG_LOOP_LIMIT : 0)
                        | (pl_get_current_debug_mode() ? PSMON_FLAG_DEBUG_MODE : 0);

  psmon->packets_received = packets_received_count;
  psmon->error_count      = error_count;
  psmon->udp_packets_sent = udp_packets_sent;
  psmon->udp_send_errors  = udp_send_errors;
  psmon->ps_read_addr     = ps_read_address;
  psmon->packet_size      = current_packet_size;
  psmon->stream_enabled   = stream_enabled;

  dsb();
  psmon->seq = (s0 | 1u) + 1u;   // even again: snapshot complete
}

// Pump the lwIP RX path once. Called continuously from the moment RX goes live
// (right after xemac_add) through ALL of init so an early client's SYN/ARP can't
// pile up in an un-serviced window and wedge the GEM RX. Belt-and-suspenders with
// the beacon-gated connect (the client shouldn't connect until it hears us) --
// but if a client DOES poke us during boot, draining here keeps the RX healthy.

// ---- GEM RX-hang self-heal (Zynq-7000 SI#692601) ---------------------------
// The GEM RX can latch up ("used-bit hang"): RXSR sets BUFFNA (b0) and/or RXOVR
// (b2), the RX DMA stops, and the MAC receives nothing (even though TX keeps
// working) until reset. It presents as "connect during boot -> board unreachable
// until power-cycle". Recover by toggling RXEN (vendor SI#692601 workaround) and
// clearing the sticky RX status bits, GATED on the actual hang bits: toggling
// RXEN on a merely-idle RX disturbs a healthy boot, so a healthy/idle RX must
// never be touched. Cheap: one register read per call when there's no hang.
#define GEM_BASE          XPAR_XEMACPS_0_BASEADDR
#define GEM_NWCTRL_OFF    0x000u
#define GEM_RXSR_OFF      0x020u
#define GEM_NWCTRL_RXEN   0x00000004u
#define GEM_RXSR_BUFFNA   0x00000001u
#define GEM_RXSR_RXOVR    0x00000004u
#define GEM_RXSR_HRESPNOK 0x00000008u

volatile uint32_t rx_hang_recoveries = 0;

static void rx_hang_recover(void) {
  uint32_t rxsr = Xil_In32(GEM_BASE + GEM_RXSR_OFF);
  if (rxsr & (GEM_RXSR_BUFFNA | GEM_RXSR_RXOVR | GEM_RXSR_HRESPNOK)) {
    uint32_t nwctrl = Xil_In32(GEM_BASE + GEM_NWCTRL_OFF);
    Xil_Out32(GEM_BASE + GEM_NWCTRL_OFF, nwctrl & ~GEM_NWCTRL_RXEN);  // RXEN off (TXEN preserved)
    Xil_Out32(GEM_BASE + GEM_NWCTRL_OFF, nwctrl);                     // RXEN on
    Xil_Out32(GEM_BASE + GEM_RXSR_OFF, rxsr);                         // W1C sticky bits
    rx_hang_recoveries++;
    send_message("GEM RX hang RXSR=0x%02x -> RXEN toggled to recover [#%u]\r\n",
                 (unsigned)(rxsr & 0xffu), (unsigned)rx_hang_recoveries);
  }
}

static inline void service_network(void) {
  xemacif_input(&server_netif);
  sys_check_timeouts();
  rx_hang_recover();   // self-heal a GEM RX hang during the boot/init window too
}

void network_maintenance_loop(void) {
  static uint32_t counter = 0;
  static uint32_t last_link_check_time = 0;
  static uint32_t last_psmon_time = 0;
  counter++;

  xemacif_input(&server_netif);
  sys_check_timeouts();
  rx_hang_recover();   // steady-state GEM RX-hang self-heal (gated on the hang bits)
  process_command_flags();

  // Refresh the shared status snapshot at ~200 Hz (every 5 ms). Cheap and
  // non-blocking; core 1 reads it on demand or for its ~1 Hz monitor.
  uint32_t now_ms = sys_now();
  if (pl_is_acq && now_ms - last_psmon_time >= 5) {   // snapshot reads PL regs
    last_psmon_time = now_ms;
    publish_status_snapshot();
  }

  // Discovery beacon: broadcast our identity ~1 Hz while the link is up so a
  // client can auto-discover us and gate its connect on hearing us. TX-only and
  // tiny; harmless during streaming.
  static uint32_t last_beacon_time = 0;
  if (link_is_up && (now_ms - last_beacon_time >= 1000)) {
    last_beacon_time = now_ms;
    beacon_send();
  }

  // Poll network link state every 500ms for hotplug detection
  uint32_t current_time = sys_now();
  if (current_time - last_link_check_time >= 500) {
    last_link_check_time = current_time;

    // Update PHY link status
    eth_link_detect(&server_netif);
    int current_link_state = netif_is_link_up(&server_netif) ? 1 : 0;

    // Detect link state transitions
    if (link_is_up && !current_link_state) {
      // Link went DOWN
      link_is_up = 0;
      send_message("Network link DOWN - cable disconnected\r\n");

      // Abort TCP connections immediately
      abort_tcp_connections();
      stop_tcp_server();

      // Stop UDP stream
      stop_udp_stream();

      // Disable streaming if active
      if (stream_enabled) {
        handle_disable_streaming();
        send_message("Streaming automatically stopped due to link down\r\n");
      }
    } else if (!link_is_up && current_link_state) {
      // Link came UP
      link_is_up = 1;
      send_message("Network link UP - cable reconnected\r\n");

      // Restart TCP server
      start_tcp_server();

      // Restart UDP stream
      broadband_stream_init();

      // Announce ourselves so a reconnecting host re-learns our MAC immediately
      // (same stale-ARP antidote as at boot, for the hotplug path).
      etharp_gratuitous(&server_netif);

      send_message("Network ready. Send START command to resume streaming.\r\n");
    }
  }
}

// ============================================================================
// MAIN APPLICATION
// ============================================================================

int main() {
  ip_addr_t ipaddr, netmask, gw;
  unsigned char mac_ethernet_address[] = { 0x00, 0x0a, 0x35, 0x00, 0x01, 0x02 };

  init_platform();
  XilTickTimer_Init(&timer);
  perf_timer_hz = COUNTS_PER_SECOND;   // global-timer freq; host converts ticks->us

  // ========================================================================
  // NOTE: This applies to 1M of memory (see TRM - UG585)
  Xil_SetTlbAttributes(SHARED_MEM_BASE, NORM_NONCACHE_SHARED); // Critical for coherency!
  // The capture BRAM (0x80000000) is written by the PL behind the data cache.
  // Reading it cached lets the A9 prefetcher pull lines while the PL is mid-write,
  // and there is no invalidate in the streaming read path -> stale/garbage words
  // surface in the UDP stream (seen as out-of-range values near the tail cycles
  // of each packet, worse at the higher dual-port data rate). Map it
  // non-cacheable so every read goes to the PL's committed data.
  Xil_SetTlbAttributes(BRAM_BASE_ADDR, NORM_NONCACHE_SHARED); // PL writes behind the cache
  // Xil_SetTlbAttributes(PL_CTRL_BASE_ADDR, NORM_NONCACHE_SHARED);
  // Prepare for second core by initializing shared structures
  init_print_buffer();
  memset((void *)command_flags, 0, sizeof(command_flags_t));
  psmon_init();   // zero the status snapshot before core 1 reads it
  pl_rhd_shadow_init();   // seed the RHD register mirror from the init defaults
  // pl_dma_init() and pl_lfp_set_config() touch the PL, so they run in
  // acq_pl_init_early() just before lwip_init, not here -- see the ordering note
  // there for why that placement is load-bearing.
  // ========================================================================

  // ========================================================================
  // Clean cache to make sure memory is visible to CPU1
  // Write the memory space base address in the Zynq's DDR (PS7 DDR) for ARM Core 1 to 
  //  0xFFFFFFF0 (which is 0x10080000 in this project).
  Xil_Out32(ARM1_BASEADDR, ARM1_STARTADR);
  // Flush the cache line containing the register write
  Xil_DCacheFlushRange(ARM1_BASEADDR, 4);
  // Full memory barriers to ensure ordering
  dmb();  // Data Memory Barrier
  dsb();  // Data Synchronization Barrier
  isb();  // Instruction Synchronization Barrier
  // ========================================================================

  xil_printf("GLANCE v%d.%d.%d.%d by the Kemere Lab\n\r\n\r\n\r",
            FIRMWARE_VERSION_MAJOR,
            FIRMWARE_VERSION_MINOR,
            FIRMWARE_VERSION_PATCH,
            FIRMWARE_VERSION_BUILD);

  // Initialize network
  IP4_ADDR(&ipaddr, 192, 168, 18, 10);
  IP4_ADDR(&netmask, 255, 255, 255, 0);
  IP4_ADDR(&gw, 192, 168, 18, 1);
  
  // NOTE: Something is suspect about our shared memory setup, in the sense
  //       that LWIP does something that breaks if we let the other core start
  //       before we call lwip_init. Is it LWIP's fault? Ours???

  // TODO: Figure out how to make this work with hotplug
  // TODO: Ideally, we'd allow for a DHCP option with some sort of discovery protocol

  // ---- The PL is already configured by the time we get here -----------------
  // BOOT.bin bakes the default acquisition bitstream, so the FSBL configured the
  // PL before this code ran (docs/boot.md). That buys the serial console
  // and the DONE LED, because the debug UART leaves the chip through PL balls --
  // a blank PL is silent.
  //
  // pl_loader_init() is XDcfg + SD mount ONLY: no PROG_B, no reconfiguration.
  // The only reconfiguration path is pl_apply_config(), which is reachable just
  // from a TCP command and therefore always runs over an established link.
  int loader_ok = (pl_loader_init() == 0);
  if (!loader_ok)
    xil_printf("WARNING: pl_loader_init failed -- set_config loads unavailable\r\n");

  // BOOT.bin bakes the default acquisition bitstream, so the FSBL has already
  // configured the PL. Do the EARLY half of the acquisition bring-up here --
  // before the network, which is the ordering this file has always required.
  //
  // The requirement is EMPIRICAL: moving this after lwip_init cost the link on
  // hardware. The mechanism is NOT established, and one plausible-sounding
  // explanation is already ruled out -- that pl_dma_init()'s
  // Xil_SetTlbAttributes, being 1 MB granular, reaches into lwIP's descriptor
  // ring. It does not: pl_dma_lfp_staging is at 0x00400000 and pl_dma_staging at
  // 0x00500000, while emac_bd_space is at 0x00800000, so they are in different
  // 1 MB sections and no TLB entry is shared. Don't re-derive that story; if you
  // need the real cause, it is still unfound.
  //
  // The send_message-HEAVY half runs later, once core 1 is draining the print
  // ring. Splitting them is why acq_pl_init_early and acq_pl_init_late exist --
  // calling the combined acq_pl_bringup() here would break one ordering or the
  // other.
  // Gate on the init result: a failed XDcfg_CfgInitialize leaves DcfgInst's
  // base address at 0, so pl_loader_pl_configured() would read offset 0x0C of
  // DDR rather than devcfg and could report a configured PL that is not there --
  // sending acq_pl_init_early() at an unconfigured fabric, which is the
  // never-returning AXI read this firmware keeps paying for.
  int pl_live_at_boot = loader_ok && pl_loader_pl_configured();
  if (pl_live_at_boot)
    acq_pl_init_early();

  // ---- Why there are two ways to print, and which one applies here ----------
  // xil_printf drives the UART directly and BLOCKS until every character has
  // been shifted out. A line of text is milliseconds at any console baud, and
  // core 0 runs the 30 kHz sample pump whose entire budget is 33 us per sample.
  // Core 0 therefore cannot afford to touch the UART once acquisition is live.
  //
  // That is what the debug server on core 1 is for. send_message() formats into
  // a 64-entry shared-memory ring in constant time and returns; core 1 does the
  // blocking UART work. Core 0 queues, core 1 prints. That is the steady-state
  // rule for the whole rest of this firmware.
  //
  // None of it works yet. Core 1 stays parked until the SEV further down, so
  // nothing drains the ring: a send_message() in this window would sit unseen
  // for as long as the link wait takes, and once 64 entries pile up the ring
  // DROPS rather than blocks, silently losing boot diagnostics. So from here to
  // the SEV, core 0 prints with xil_printf. It is safe -- nothing here is
  // time-critical and core 0 is the only writer -- and it is also the only way
  // to keep the log in causal order, because lwip_init() and the xemacpsif/PHY
  // code below xil_printf from core 0 themselves ("Start PHY autonegotiation",
  // "link speed for phy address 0: 1000"). Queued lines would surface after
  // driver output that actually happened later.
  lwip_init();

  netif_add(&server_netif, &ipaddr, &netmask, &gw, NULL, NULL, NULL);
  netif_set_default(&server_netif);
  xemac_add(&server_netif, &ipaddr, &netmask, &gw,
       mac_ethernet_address, XPAR_XEMACPS_0_BASEADDR);
  netif_set_up(&server_netif);
  service_network();   // RX is live now -- start draining it through the rest of init

  eth_link_detect(&server_netif);
  if (netif_is_link_up(&server_netif)) {
    link_is_up = 1;
    xil_printf("Network link UP at boot\r\n");
  } else {
    link_is_up = 0;
    xil_printf("Network link DOWN at boot - waiting for cable connection...\r\n");
  }

  // Bounded, because core 1 is still parked and the console does not exist
  // until it wakes (below). An unbounded wait here means a board with no
  // Ethernet -- the exact case the baked bitstream exists to keep diagnosable --
  // sits mute forever with no serial console and no network. Give the PHY a
  // generous window, then carry on: link_is_up is re-evaluated by the
  // maintenance loop, so a cable plugged in later still comes up.
  {
    XTime wait_start; XTime_GetTime(&wait_start);
    const XTime wait_limit = (XTime)COUNTS_PER_SECOND * LINK_WAIT_TIMEOUT_S;
    uint32_t last_probe = sys_now();   // the detect just above counts as probe 0
    while (!link_is_up) {
      service_network();   // keep draining RX while waiting for PHY link-up

      // Probe the PHY on the SAME 500 ms cadence the maintenance loop uses.
      // eth_link_detect() drives MDIO and re-enters the driver's link/autoneg
      // path, which prints as it goes. Calling it as fast as this loop spins
      // floods the console and keeps restarting negotiation on a link that only
      // needed a moment to settle -- so an unpaced wait can be the reason the
      // link never comes up. service_network() still runs every pass; it is the
      // PHY poll that has to be rate-limited, not the RX drain.
      uint32_t now_ms_probe = sys_now();
      if ((uint32_t)(now_ms_probe - last_probe) >= 500) {
        last_probe = now_ms_probe;
        eth_link_detect(&server_netif);
      }

      if (netif_is_link_up(&server_netif)) {
        link_is_up = 1;
        xil_printf("Network link UP\r\n");
        break;
      }
      XTime now_wait; XTime_GetTime(&now_wait);
      if ((now_wait - wait_start) > wait_limit) {
        xil_printf("Network link DOWN after %ds -- continuing so the serial "
                   "console comes up; plug the cable in and it will link\r\n",
                   LINK_WAIT_TIMEOUT_S);
        break;
      }
    }
  }

  // Start second core -- AFTER the PHY/link work above, deliberately.
  //
  // There is exactly one UART and two potential writers. Core 1 owns it once it
  // starts (it drains the print ring with xil_printf). Core 0 does not print
  // directly after this point... but lwIP's xemacpsif/PHY code does: "Start PHY
  // autonegotiation", "link speed for phy address 0: 1000" and friends are
  // xil_printf straight from the driver, on core 0, and eth_link_detect() calls
  // into it. Waking core 1 before that finished put both cores on the UART at
  // once and shredded the output into interleaved characters. It also has to
  // stay after lwip_init (see the note above about lwIP breaking if core 1
  // starts first), so this window -- after link-up, before the servers -- is the
  // one spot that satisfies both.

  // Queued deliberately, and deliberately LAST: this is the only send_message()
  // in the boot path, and core 1 is still parked, so it can only reach the
  // console by way of the ring being drained after the SEV on the next line.
  // That makes it a self-test of the debug server rather than a status line --
  // "Debug server up and running." landing right behind core 1's own "Core 1
  // awake!!" is end-to-end proof that the ring works. If it never appears, the
  // ring is broken, not the network. Keep it immediately above the SEV: move it
  // earlier and it stops proving anything, because the wait it survives is what
  // gives it meaning.
  send_message("Debug server up and running.\r\n");

  xil_printf("ARM0: sending the SEV to wake up ARM1\n\r");
  sev(); // Send event to wake up ARM1
  // From here on the ring has a reader, so boot_print() switches to queueing
  // and core 0 must stop touching the UART directly.
  core1_print_active = 1;
  usleep(5000);

  start_tcp_server();
  service_network();   // answer anything already waiting on the listener

  // Initialize UDP (always enabled)
  broadband_stream_init();
  lfp_stream_init();   // LFP band shares the unified UDP port (UDP_PORT), stream_type=2
  pl_imu_stream_init();  // IMU side channel, same port, stream_type=3

  send_message("Network initialized. IP: %s\r\n", ip4addr_ntoa(&ipaddr));

  // Adopt whatever the PL actually is, rather than assuming. BOOT.bin bakes the
  // default acquisition bitstream, so the FSBL has already configured the PL by
  // the time we get here -- and that is what makes the serial console exist at
  // all, since the debug UART leaves the chip through PL balls (M14/M15 via
  // JX2). PCFG_DONE is a PS register read, so asking is free and cannot hang
  // the way touching an unconfigured PL slave would.
  //
  // Deliberately AFTER the network is up: the PL-init path is send_message
  // heavy, and core 1 must already be draining the print ring (running it
  // earlier once flooded the ring and raced the two cores on the shared UART).
  // No PCAP runs here either way -- the FSBL did the configuring -- so none of
  // this goes near the GEM/PHY bring-up window that runtime loads must avoid.
  pl_has_iic = pl_has_iic_a = pl_has_iic_b = 0;   // the baked fabric is 128-ch, no I2C
  if (pl_live_at_boot) {
    current_config = PL_CONFIG_BAKED;
    acq_pl_init_late();     // early half already ran, before the network
    pl_reset_timestamp();
    pl_is_acq = 1;
    // The PL is up, so the console's RX ball is real: honour typed commands.
    command_flags->serial_input_ok = 1;
    send_message("System ready: PL configured at boot (%s). "
                 "set_config / rescan to swap fabrics.\r\n",
                 pl_configs[PL_CONFIG_BAKED].name);
  } else {
    // No bitstream in the boot image (or configuration failed). Everything
    // still works -- the host loads a fabric with set_config -- but the console
    // this message is printed to does not exist yet, so say it for the log
    // that replays once a fabric is up.
    pl_is_acq = 0;
    current_config = -1;   // blank -- CMD_PL_STATUS reports "blank"
    send_message("System ready (PL BLANK -- no baked bitstream). "
                 "Load a fabric: set_config <acquisition|acq_imu_both|acq_imu_port_a|acq_imu_port_b>\r\n");
  }
  send_message("debug> ");

  // Board is fully up now. Proactively announce our IP->MAC with a gratuitous
  // ARP so the host's ARP cache and the switch CAM learn us immediately -- the
  // direct antidote to the stale/failed-ARP "[Errno 64] Host is down" the host
  // reports when it connects before it has heard from us. Then emit ONE
  // unambiguous readiness line, distinct from the earlier "link UP"/"server up"
  // notices that fire >20 s before the board can actually service a connection.
  etharp_gratuitous(&server_netif);
  send_message("READY: safe to connect now (TCP command port %d up)\r\n", TCP_PORT);

  // Start the discovery beacon: from here we broadcast our identity ~1 Hz (in
  // network_maintenance_loop) so a client can auto-discover our IP and know we're
  // up, without sending us anything during boot. See beacon_send().
  beacon_init();

  // Main event loop
  while (1) {
    network_maintenance_loop();

    // The stream services touch the PL, so run them only on an acquisition
    // fabric. (stream_enabled/lfp are already 0 without an acq fabric and START is
    // gated on pl_is_acq, but this makes a mid-swap teardown provably safe.)
    if (!pl_is_acq)
      continue;

    // Broadband first, and unconditionally: it is the 30 kHz path with the
    // 33 us budget, and nothing may come between it and the PL.
    broadband_stream_service();

    // LFP after it, deliberately. The decimated stream is 3 kHz and its 16K-word
    // ring tolerates bursty servicing, so it yields to broadband every time.
    // Kept on its own line rather than inside the network loop so that ordering
    // is a visible scheduling decision instead of an implementation detail.
    lfp_stream_service();

    // IMU last: 100 Hz, and a pass costs at most a couple of IIC status reads
    // while a transfer is in flight (the I2C itself runs in the core's FIFOs).
    //
    // MEASURED, not assumed: servicing this I2C peripheral from the same loop
    // as the 30 kHz pump does NOT increase latency. Comparing a streaming run
    // with the IMU off against one with it on, the recv->transmit histogram
    // (loop_hist) and over_budget_count are unchanged -- so the cost stays
    // inside the noise of the 33.3 us budget. Keeping it here therefore needs
    // no further optimization; if that ever stops being true, perf_reset then
    // get_status with the stream off vs on is the measurement that shows it.
    pl_imu_stream_service();
  }
  
  cleanup_platform();
  return 0;
}
