glanceneuro/glance-neuro/remote/net.py

# SPDX-License-Identifier: MIT
# SPDX-FileCopyrightText: 2025-2026 Caleb Kemere, Reet Sinha, Allen Mikhailov, Rice University

import socket
import errno
import sys
import threading
import struct
import time
import random
import queue
import math
import zlib
import ipaddress
from typing import Dict, List, Tuple, Optional
from dataclasses import dataclass

ZYNQ_IP = "192.168.18.10"  # IP of the Zynq board
TCP_PORT = 0x6900  # 26880 -- must match your board's TCP_PORT
UDP_PORT = 0x6800  # 26624 -- must match your board's UDP_PORT (ALL streams; demux by stream_type)

# ---------------------------------------------------------------------------
# Device discovery beacon (layout: firmware main.h device_beacon_t, built in
# network.c). The board broadcasts a 28-byte beacon to <subnet>.255:BEACON_PORT
# ~1 Hz once it's up. We listen for it to (a) auto-discover the board's IP (no
# hardcoding), (b) confirm it's ready before we send it anything, and (c) stay
# fully passive during its fragile boot window. Falls back to the configured
# ZYNQ_IP if no beacon is heard (older firmware without the beacon). The beacon
# is a subnet BROADCAST, so an unbound host port does NOT provoke an ICMP
# port-unreachable (hosts don't ICMP-error broadcasts) -- safe to close after.
# ---------------------------------------------------------------------------
BEACON_PORT = 0x6880  # 26752 -- must match your board's BEACON_PORT
BEACON_MAGIC = 0x4B4C4231
_BEACON_FMT = '<II4sHHI6sH'   # magic,version,ip,tcp,udp,fw,mac,reserved = 28 bytes
BEACON_DISCOVERY_TIMEOUT = 45.0   # must exceed board boot (>20 s) PLUS any
                                  # interface bring-up (a USB-C Ethernet adapter
                                  # re-enumerating on a power-cycle adds seconds).
                                  # Set to 0 to skip discovery (old fw / blocked port).


def _parse_beacon(data):
    if len(data) < 28:
        return None
    magic, version, ip_bytes, tcp_port, udp_port, fw, mac, _ = \
        struct.unpack(_BEACON_FMT, data[:28])
    if magic != BEACON_MAGIC:
        return None
    return {
        'payload_ip': socket.inet_ntoa(ip_bytes),
        'tcp_port': tcp_port,
        'udp_port': udp_port,
        'fw': f"{(fw >> 24) & 0xff}.{(fw >> 16) & 0xff}.{(fw >> 8) & 0xff}.{fw & 0xff}",
        'mac': ':'.join(f'{b:02x}' for b in mac),
        'version': version,
    }


def _open_beacon_socket(quiet=False):
    """Create + bind a fresh UDP listener on BEACON_PORT (INADDR_ANY). Returns the
    socket or None."""
    sock = socket.socket(socket.AF_INET, socket.SOCK_DGRAM)
    sock.setsockopt(socket.SOL_SOCKET, socket.SO_REUSEADDR, 1)
    for opt in ('SO_REUSEPORT', 'SO_BROADCAST'):
        try:
            sock.setsockopt(socket.SOL_SOCKET, getattr(socket, opt), 1)
        except (AttributeError, OSError):
            pass
    try:
        sock.bind(('', BEACON_PORT))
    except OSError as e:
        if not quiet:
            print(f"[DISCOVERY] Could not bind UDP {BEACON_PORT}: {e}")
        sock.close()
        return None
    return sock


# macOS gates LOCAL NETWORK traffic (broadcast/multicast discovery, and inbound
# UDP from the subnet) per application, separately from the firewall. There is
# no API to request or grant it: the prompt is raised implicitly by the OS the
# first time a process touches the local network, and once it has been answered
# -- or silently denied -- only the user can change it in System Settings.
#
# What we CAN do is stop it being a mystery. Binding the beacon port is itself
# the access attempt that triggers the prompt, so if it has never been asked it
# gets asked. If it was denied, the beacon simply never arrives, and the symptom
# (a 45 s wait, then nothing) looks like a dead board. So say so, and hand over
# the one command that opens the exact settings pane.
_LOCAL_NETWORK_PANE = ("x-apple.systempreferences:"
                       "com.apple.preference.security?Privacy_LocalNetwork")

def local_network_permission_hint(what="the discovery beacon"):
    """Explain a macOS local-network block, if that is plausibly what happened."""
    if sys.platform != "darwin":
        return
    print(f"[DISCOVERY] On macOS, {what} is subject to the Local Network privacy")
    print(f"            setting, which is SEPARATE from the firewall -- a unicast")
    print(f"            data stream can work while broadcast discovery is blocked.")
    print(f"            Check that this interpreter is enabled:")
    print(f"              {sys.executable}")
    print(f"            Open the pane directly with:")
    print(f"              open \"{_LOCAL_NETWORK_PANE}\"")


def discover_board(timeout=BEACON_DISCOVERY_TIMEOUT, quiet=False, rebind_interval=5.0,
                   data_port=None):
    """Listen for the device discovery beacon on UDP BEACON_PORT and return the first
    valid board (dict incl. 'ip' from the datagram source), or None if none arrives
    within `timeout`. Fully passive -- sends nothing to the board.

    If `data_port` is given, ALSO listen there for a live broadband DATA packet: when
    the board is already up and streaming (e.g. to OpenEphys) we adopt its source IP
    the instant a packet arrives, instead of waiting out the full beacon timeout for a
    ~1 Hz broadcast that directed-broadcast filtering or the host stack may be dropping.

    Re-creates the listening socket every `rebind_interval` s. This matters when the
    board-facing interface appears or flaps DURING discovery -- e.g. a USB-C Ethernet
    adapter re-enumerating on a board power-cycle takes the interface down then up. A
    socket bound while that interface was down won't reliably receive its broadcasts
    once it returns; a fresh bind after it's up does."""
    import select
    deadline = time.time() + timeout
    while time.time() < deadline:
        # Diagnostic: which local IP would reach the board right now? If it's not
        # on the board's subnet, the board-facing interface isn't up yet (this is
        # a pure route lookup -- no packet is sent to the board).
        if not quiet:
            print(f"[DISCOVERY] listening on UDP {BEACON_PORT}"
                  + (f" + data {data_port}" if data_port else "")
                  + f" (local route toward {ZYNQ_IP}: {get_local_ip()})")
        bsock = _open_beacon_socket(quiet)
        if bsock is None:
            time.sleep(1.0)
            continue
        # Optional passive listener on the data port -- if the board is already
        # streaming, its source address reveals it without any beacon.
        dsock = None
        if data_port is not None:
            try:
                dsock = socket.socket(socket.AF_INET, socket.SOCK_DGRAM)
                dsock.setsockopt(socket.SOL_SOCKET, socket.SO_REUSEADDR, 1)
                if hasattr(socket, 'SO_REUSEPORT'):
                    try:
                        dsock.setsockopt(socket.SOL_SOCKET, socket.SO_REUSEPORT, 1)
                    except OSError:
                        pass
                dsock.bind(('', data_port))
            except OSError:
                if dsock is not None:
                    dsock.close()
                dsock = None
        socks = [s for s in (bsock, dsock) if s is not None]
        try:
            sub_deadline = min(deadline, time.time() + rebind_interval)
            while time.time() < sub_deadline:
                remaining = max(0.0, sub_deadline - time.time())
                ready, _, _ = select.select(socks, [], [], min(remaining, 3.0))
                for s in ready:
                    try:
                        data, addr = s.recvfrom(2048)
                    except socket.timeout:
                        continue
                    if s is bsock:
                        dev = _parse_beacon(data)
                        if dev is None:
                            # Something IS arriving on the beacon port but does
                            # not look like our beacon. Say so: silently ignoring
                            # it makes a wrong-magic or truncated beacon
                            # indistinguishable from a board that never sent one.
                            if not quiet:
                                print(f"[DISCOVERY] ignored {len(data)}B from {addr[0]}"
                                      f" on UDP {BEACON_PORT} (not a valid beacon)")
                            continue
                        dev['src_ip'] = addr[0]
                        dev['ip'] = addr[0]  # datagram source is authoritative
                        dev['via'] = 'beacon'
                        return dev
                    else:
                        # data port: a live broadband stream (UNIFIED_MAGIC) reveals
                        # the board's IP as its source address.
                        if len(data) >= 4 and struct.unpack('<I', data[:4])[0] == UNIFIED_MAGIC:
                            if not quiet:
                                print(f"[DISCOVERY] board already streaming from {addr[0]} "
                                      f"-- adopting (no beacon needed)")
                            return {'ip': addr[0], 'src_ip': addr[0], 'via': 'data',
                                    'tcp_port': 0, 'udp_port': 0, 'fw': 0, 'mac': ''}
        finally:
            for s in socks:
                s.close()
        left = deadline - time.time()
        if not quiet and left > 0:
            print(f"[DISCOVERY]   ...still listening ({left:.0f}s left, re-binding)")
    return None

# Updated data generator constants
MAGIC_NUMBER_LOW = 0xDEADBEEF
MAGIC_NUMBER_HIGH = 0xCAFEBABE

# ---------------------------------------------------------------------------
# Unified packet format (docs/unified-packet-format.md). Every PL stream emits
# the SAME 8 x 32-bit little-endian common header on UDP_PORT; the host demuxes
# by stream_type and verifies the per-stream SEQ continuity (the loss check).
#   w0 MAGIC=0xCAFEBABE | w1 TYPE_VER=type[7:0]|version[15:8]|flags[31:16]
#   w2/w3 64-bit timestamp | w4 SEQ | w5 AUX0 | w6 AUX1 | w7 RSVD
# ---------------------------------------------------------------------------
UNIFIED_MAGIC = 0xCAFEBABE
UNIFIED_VERSION = 1
UNIFIED_HEADER_WORDS = 8
STREAM_TYPE_BROADBAND = 1
STREAM_TYPE_LFP = 2
STREAM_TYPE_IMU = 3           # BNO055 side channel, one 52-byte datagram per fused sample
# Types are handed out in the order streams ship, with no gaps. The next one is 4.

# Binary command protocol constants
CMD_MAGIC = 0xDEADBEEF
CMD_PACKET_SIZE = 20
ACK_PACKET_SIZE = 3

# Command IDs
CMD_START = 0x01
CMD_STOP = 0x02
CMD_RESET_TIMESTAMP = 0x03
CMD_SET_LOOP_COUNT = 0x10
CMD_SET_PHASE = 0x11
CMD_SET_DEBUG_MODE = 0x12
CMD_SET_CHANNEL_ENABLE = 0x13
CMD_SET_PHASE_B = 0x14   # port B (second cable) CIPO phase
CMD_LOAD_CONVERT = 0x20
CMD_LOAD_INIT = 0x21
CMD_LOAD_CABLE_TEST = 0x22
CMD_FULL_CABLE_TEST = 0x30
CMD_GET_STATUS = 0x40
CMD_DUMP_BRAM = 0x41
CMD_SET_UDP_DEST = 0x50
CMD_PING = 0x60
# Aux command sequencer / override layer (mirror firmware/src-core0/network.c)
CMD_AUX_WRITE_WORD = 0x70   # param1 = slot | bank<<8 | is_len<<16; param2 = addr<<16 | data
CMD_AUX_BANK_SELECT = 0x71  # param1 = slot; param2 = bank
# 0x72 is unassigned: the aux command engine is always on, so there is no enable command
CMD_READ_REGISTER = 0x73    # param1 = reg -> 4-byte {cipo1, cipo0} response
CMD_WRITE_REGISTER = 0x74   # param1 = reg; param2 = value -> 4-byte echo response
CMD_SET_FAST_SETTLE = 0x75  # param1 = amp: sw|gpio_en<<1|pin<<4; param2 = dsp: same layout
CMD_SET_DIGOUT = 0x76       # param1 = sw|gpio_en<<1|pin<<4; param2 = reg3_static byte
CMD_SET_CHIRP = 0x77        # param1 = mode | stride<<8; param2 = fspan | rate<<16 (CTRL_REG_3)

# Analytic chirp NCO scaling (must match data_generator_core.sv CTRL_REG_3)
CHIRP_PHW          = 32
CHIRP_FSPAN_SHIFT  = 16     # f_max = fspan << 16 (phase-accumulator units)
CHIRP_RATE_SHIFT   = 9      # freq_acc step/packet = rate << 9
PACKET_RATE_HZ     = 30000  # one phase update per broadband packet
# LFP/DSP engine (Tier-1) -- configure while disabled, then enable
CMD_LFP_ENABLE = 0x80       # param1 = 0/1
CMD_LFP_SET_PARAMS = 0x81   # param1 ignored (decimation is structural /10), param2 = num_taps
CMD_LFP_SET_CHANNELS = 0x82 # sets nothing: the LFP lane mask mirrors broadband channel_enable (firmware accepts-and-ignores)
CMD_LFP_WRITE_COEF = 0x83   # param1 = [0] clear-ptr-first | [1] stage; param2 = 18-bit signed coef
LFP_STAGE_HALFBAND = 0      # stage 1: 11-tap halfband, 30 -> 15 kHz
LFP_STAGE_DECIMATOR = 1     # stage 2: <=120-tap decimator, 15 -> 3 kHz
CMD_PERF_RESET = 0x91       # clear recv->transmit sticky maxes + histogram + counts

# DAC70502 stimulus playback (docs/stim.md; PL stim_top)
CMD_STIM_SET_WINDOW   = 0xA0  # param1 = start_index; param2 = end_index
CMD_STIM_SET_LOOP     = 0xA1  # param1 = loop_index;  param2 = frame_count (finite total; 0 with continuous)
CMD_STIM_SET_RATE     = 0xA2  # param1 = divider k (frame rate = 240 kf/s / k)
CMD_STIM_SET_TRIGGER  = 0xA3  # param1 = line|pol<<3|mode<<4|retrig<<6|arm<<7; param2 = min_pulse_us
CMD_STIM_START        = 0xA4  # param1 = 0 finite / 1 continuous
CMD_STIM_STOP         = 0xA5
CMD_STIM_TRIGGER      = 0xA6  # software single-shot (finite start)
CMD_STIM_ZERO         = 0xA7  # force configured idle state now (disarms hw trigger)
CMD_STIM_UPLOAD_BEGIN = 0xA8  # param1 = start_index; param2 = total word count
CMD_STIM_WRITE        = 0xA9  # param1/param2 = two frame words (auto-increment)
CMD_STIM_VERIFY       = 0xAA  # param1 = offset; param2 = count -> 4-byte CRC32 reply
CMD_STIM_GET_STATUS   = 0xAB  # -> stim_status struct
CMD_STIM_SET_IDLE     = 0xAC  # param1 = 1 drive codes / 0 power-down; param2 = codeB<<16|codeA
CMD_STIM_POWERDOWN    = 0xAD  # outputs -> 1k to AGND (disarms hw trigger)

STIM_RAM_DEPTH = 16384
STIM_MASTER_RATE_HZ = 240000.0   # 84 MHz / 350, fixed in the PL

# BNO055 IMU presence detection (the separate "detect" bitstream; imu_detect_top).
# Reply is 12 bytes: result_a(u32), result_b(u32), version(u32) -- keep in sync
# with firmware imu_detect_response_t and imu_detect_top.sv bitfields.
CMD_DETECT_IMU = 0xB0
IMUDET_VERSION = 0x494D5532   # "IMU2" (axi_iic revision)

def _decode_imu_result(word):
    return {
        'present': bool(word & 0x1),   # ACKed AND chip_id == 0xA0
        'ack':     bool(word & 0x2),   # a device ACKed its address at 0x28
        'absent':  bool(word & 0x4),   # this port has no AXI IIC on the loaded fabric (not probed)
        'chip_id': (word >> 8) & 0xFF,
        'iic_sr':  (word >> 24) & 0xFF,  # AXI IIC status reg post-init (diag)
    }

def detect_imu(sock):
    """Probe both headstage ports for a BNO055 over the shared-lane I2C (via the
    detect bitstream's two AXI IIC controllers) and print a per-port verdict."""
    ok, data = send_binary_command(sock, CMD_DETECT_IMU, timeout=2.0)
    if not ok or data is None or len(data) < 12:
        print("[DETECT] refused -- the loaded fabric has no IMU I2C. Load one that does "
              "with set_config: acq_imu_both / acq_imu_port_a / acq_imu_port_b / scan. "
              "(Plain 'acquisition' and a blank PL carry no I2C; check with pl_status.)")
        return None
    ra, rb, ver = struct.unpack('<III', data[:12])
    if ver != IMUDET_VERSION:
        print(f"[DETECT] unexpected peripheral version 0x{ver:08X} "
              f"(expected 0x{IMUDET_VERSION:08X}); wrong bitstream?")
    res = {'A': _decode_imu_result(ra), 'B': _decode_imu_result(rb)}
    for port in ('A', 'B'):
        r = res[port]
        if r['absent']:
            print(f"Port {port}: no I2C on this fabric (this cable is 128-ch LVDS) -- not probed")
            continue
        # AXI IIC status register post-init: a live core reads ~0xC0 (both FIFOs
        # empty). 0x00/0xFF means the controller isn't answering at its base.
        sr = r['iic_sr']
        ctrl = "controller alive" if sr not in (0x00, 0xFF) else "CONTROLLER NOT RESPONDING"
        diag = f"[iic_sr=0x{sr:02X}, {ctrl}]"
        if r['present']:
            print(f"Port {port}: IMU present (BNO055, chip_id=0x{r['chip_id']:02X}) {diag}")
        elif r['ack']:
            print(f"Port {port}: device answered at 0x28 but chip_id=0x{r['chip_id']:02X} "
                  f"!= 0xA0 (not a BNO055) {diag}")
        else:
            print(f"Port {port}: no IMU (nothing answered at 0x28) {diag}")
    return res

# One-shot BNO055 fused sample (CMD_IMU_READ). Reply is 32 bytes -- keep in sync
# with firmware imu_sample_response_t. Validated on hardware 2026-07-30 (chip_id
# 0xA0, port A); the continuous-ingestion design is docs/imu-ingestion.md.
CMD_IMU_READ = 0xB6
IMUREAD_VERSION = 0x494D5552  # "IMUR"

def imu_read(sock, port='a'):
    """Read one NDOF sample (quaternion/accel/gyro + calibration status) from
    the BNO055 on port 'a' or 'b'. Needs a fabric with that port's I2C and
    streaming stopped; the first read after power-up takes ~50 ms extra while
    the chip enters NDOF."""
    p = 0 if str(port).lower() in ('0', 'a') else 1
    ok, data = send_binary_command(sock, CMD_IMU_READ, param1=p, timeout=2.0)
    if not ok or data is None or len(data) < 32:
        print(f"[IMU] read refused/failed on port {'B' if p else 'A'} -- "
              f"fabric without that port's I2C, or streaming active?")
        return None
    (status, qw, qx, qy, qz, ax, ay, az, gx, gy, gz,
     calib, temp, _pad, ver) = struct.unpack('<I10hBbHI', data[:32])
    if ver != IMUREAD_VERSION:
        print(f"[IMU] unexpected version 0x{ver:08X} (expected 0x{IMUREAD_VERSION:08X})")
    if not (status & 0x1):
        why = ("chip present but would not enter NDOF" if status & 0x8
               else "nothing answered at 0x28")
        print(f"[IMU] port {'B' if p else 'A'}: no sample -- {why} "
              f"[mode=0x{(status >> 8) & 0xFF:02X}, iic_sr=0x{(status >> 24) & 0xFF:02X}]")
        return None
    quat = tuple(v / 16384.0 for v in (qw, qx, qy, qz))
    accel = tuple(v / 100.0 for v in (ax, ay, az))     # m/s^2
    gyro = tuple(v / 16.0 for v in (gx, gy, gz))       # deg/s
    cal = {'sys': (calib >> 6) & 3, 'gyr': (calib >> 4) & 3,
           'acc': (calib >> 2) & 3, 'mag': calib & 3}
    print(f"[IMU] port {'B' if p else 'A'}: "
          f"quat w={quat[0]:+.4f} x={quat[1]:+.4f} y={quat[2]:+.4f} z={quat[3]:+.4f}")
    print(f"      accel ({accel[0]:+7.2f},{accel[1]:+7.2f},{accel[2]:+7.2f}) m/s^2  "
          f"gyro ({gyro[0]:+8.2f},{gyro[1]:+8.2f},{gyro[2]:+8.2f}) deg/s")
    print(f"      calib sys={cal['sys']}/3 gyr={cal['gyr']}/3 acc={cal['acc']}/3 "
          f"mag={cal['mag']}/3, die {temp} C")
    return {'quat': quat, 'accel': accel, 'gyro': gyro, 'calib': cal,
            'temp_c': temp, 'status': status}

# --- Continuous IMU stream (CMD_IMU_STREAM, stream_type=3) --------------------
# One 52-byte datagram per fused sample on the unified UDP port: the 8-word
# common header + 10 LE int16s (quat wxyz / acc xyz / gyr xyz). Keep in sync
# with firmware pl_imu_stream.h.
#   w1 TYPE_VER: stream_type=3 | version<<8 | port<<16
#   w5 AUX0:     period_ms[15:0] | iic_errors[23:16] | send_drops[31:24]
#   w6 AUX1:     calib_stat[7:0] | opr_mode[15:8] | temp_c[23:16]
CMD_IMU_STREAM = 0xB8
IMUSTREAM_VERSION = 0x494D5553  # "IMUS"
IMU_PKT_BYTES = 52

def parse_imu_packet(data):
    """Decode one stream_type=3 datagram into engineering units, or None."""
    if len(data) < IMU_PKT_BYTES:
        return None
    magic, type_ver, ts_lo, ts_hi, seq, aux0, aux1, _ = \
        struct.unpack_from('<IIIIIIII', data, 0)
    if magic != UNIFIED_MAGIC or (type_ver & 0xFF) != STREAM_TYPE_IMU:
        return None
    v = struct.unpack_from('<10h', data, 32)
    temp = (aux1 >> 16) & 0xFF
    return {
        'port': 'B' if (type_ver >> 16) & 1 else 'A',
        'seq': seq,
        'timestamp': ts_lo | (ts_hi << 32),     # PL master clock: aligns with neural data
        'period_ms': aux0 & 0xFFFF,
        'iic_errors': (aux0 >> 16) & 0xFF,
        'send_drops': (aux0 >> 24) & 0xFF,
        'calib': aux1 & 0xFF,                   # [7:6]sys [5:4]gyr [3:2]acc [1:0]mag
        'opr_mode': (aux1 >> 8) & 0xFF,
        'temp_c': temp - 256 if temp > 127 else temp,
        'quat': tuple(x / 16384.0 for x in v[0:4]),
        'accel': tuple(x / 100.0 for x in v[4:7]),      # m/s^2
        'gyro': tuple(x / 16.0 for x in v[7:10]),       # deg/s
    }

def imu_stream(sock, spec='both', period_ms=0):
    """Start/stop continuous IMU streaming. spec: a | b | both | off. The port
    set is absolute. Start the IMU BEFORE 'start' (arming a port does a ~50 ms
    blocking NDOF entry, refused mid-stream); stopping is always allowed."""
    masks = {'a': 1, 'b': 2, 'both': 3, 'off': 0, '0': 0}
    m = masks.get(str(spec).lower())
    if m is None:
        print(f"[IMU] unknown port spec '{spec}' (a | b | both | off)")
        return None
    ok, data = send_binary_command(sock, CMD_IMU_STREAM, param1=m,
                                   param2=int(period_ms), timeout=3.0)
    if not ok or data is None or len(data) < 12:
        print("[IMU] imu_stream refused -- needs an acq_imu_* fabric, and "
              "starting a port is refused while neural streaming is active")
        return None
    active, period, ver = struct.unpack('<III', data[:12])
    if ver != IMUSTREAM_VERSION:
        print(f"[IMU] unexpected version 0x{ver:08X} (expected 0x{IMUSTREAM_VERSION:08X})")
    # The firmware sets p->seq = 0 every time a port is ARMED, so a restart is
    # a backward jump the sink would otherwise score as a gap -- and under hard
    # rule 3 a nonzero gap count reads as data loss on a clean run. Re-baseline
    # the ports this command (re)started.
    if UNIFIED_SINK is not None:
        for _p in (0, 1):
            if active & (1 << _p):
                UNIFIED_SINK._imu_last_seq[_p] = None
    names = {0: 'none', 1: 'A', 2: 'B', 3: 'A+B'}
    if m and active != m:
        print(f"[IMU] note: asked for {names[m]} but got {names[active]} -- "
              f"ports without an IIC on this fabric (or with no responding "
              f"BNO055) are dropped; see the board console")
    print(f"[IMU] streaming: {names[active]} at {1000 // max(period, 1)} Hz "
          f"(period {period} ms, stream_type=3 on UDP {UDP_PORT})")
    return {'active': active, 'period_ms': period}

IMU_STREAM_QUERY = 0x80000000   # param1 bit 31: report state, change nothing

def imu_stream_query(sock):
    """Read the board's IMU streaming state without disturbing it. Returns
    {'active','period_ms'} or None (older firmware, or a fabric that refuses
    the command)."""
    ok, data = send_binary_command(sock, CMD_IMU_STREAM,
                                   param1=IMU_STREAM_QUERY, timeout=2.0)
    if not ok or data is None or len(data) < 12:
        return None
    active, period, ver = struct.unpack('<III', data[:12])
    if ver != IMUSTREAM_VERSION:
        return None
    return {'active': active, 'period_ms': period}

def imu_recv(n=20, timeout=5.0):
    """Print n live IMU samples from the unified sink (imu_stream first)."""
    if UNIFIED_SINK is None:
        print("[IMU] unified sink not running")
        return 0
    q = UNIFIED_SINK.subscribe_imu()
    got = 0
    try:
        while got < n:
            try:
                pkt = parse_imu_packet(q.get(timeout=timeout))
            except queue.Empty:
                print("[IMU] timeout -- is imu_stream on and an acq fabric loaded?")
                break
            if pkt is None:
                continue
            got += 1
            qt, ac, gy = pkt['quat'], pkt['accel'], pkt['gyro']
            c = pkt['calib']
            print(f"[IMU {pkt['port']}] seq={pkt['seq']} ts={pkt['timestamp']} "
                  f"quat=({qt[0]:+.3f},{qt[1]:+.3f},{qt[2]:+.3f},{qt[3]:+.3f}) "
                  f"acc=({ac[0]:+6.2f},{ac[1]:+6.2f},{ac[2]:+6.2f}) "
                  f"gyr=({gy[0]:+7.1f},{gy[1]:+7.1f},{gy[2]:+7.1f}) "
                  f"cal={c >> 6 & 3}{c >> 4 & 3}{c >> 2 & 3}{c & 3}")
    finally:
        UNIFIED_SINK.unsubscribe_imu(q)
    return got

_IMU_CSV = {'thread': None, 'stop': None, 'path': None, 'rows': 0}

def imu_csv_start(path):
    """Record every IMU sample to a CSV until imu_csv_stop(). Background thread
    off the sink's subscriber queue -- the recv hot path is untouched."""
    if _IMU_CSV['thread'] is not None:
        print(f"[IMU] already recording to {_IMU_CSV['path']} (imu_csv stop first)")
        return
    if UNIFIED_SINK is None:
        print("[IMU] unified sink not running")
        return
    # Open here, not in the worker: a bad path must fail in front of the user
    # rather than killing a background thread that leaves the recorder looking
    # busy forever.
    try:
        # buffering=1 (line buffered). The worker is a DAEMON thread, so the
        # interpreter exits without unwinding it: anything sitting in a 8 KB
        # block buffer is simply lost, which silently truncated -- or entirely
        # emptied -- short recordings.
        f = open(path, 'w', buffering=1)
    except OSError as e:
        print(f"[IMU] cannot record to {path}: {e}")
        return
    stop = threading.Event()
    q = UNIFIED_SINK.subscribe_imu()

    def worker():
        n = 0
        try:
            f.write("host_time,port,seq,timestamp,qw,qx,qy,qz,"
                    "ax,ay,az,gx,gy,gz,calib,temp_c,iic_errors,send_drops\n")
            while not stop.is_set():
                try:
                    pkt = parse_imu_packet(q.get(timeout=0.5))
                except queue.Empty:
                    continue
                if pkt is None:
                    continue
                f.write(f"{time.time():.6f},{pkt['port']},{pkt['seq']},"
                        f"{pkt['timestamp']},"
                        + ",".join(f"{x:.6f}" for x in pkt['quat'])
                        + "," + ",".join(f"{x:.4f}" for x in pkt['accel'])
                        + "," + ",".join(f"{x:.4f}" for x in pkt['gyro'])
                        + f",{pkt['calib']},{pkt['temp_c']},"
                        f"{pkt['iic_errors']},{pkt['send_drops']}\n")
                n += 1
                _IMU_CSV['rows'] = n
        except Exception as e:                      # disk full, etc.
            print(f"\n[IMU] recording stopped after {n} rows: {e}")
        finally:
            # Always drop the subscription and close, or the sink keeps feeding
            # a queue nobody drains and the file is left open.
            UNIFIED_SINK.unsubscribe_imu(q)
            f.close()
            # Only disown the slot if it is still OURS. A worker that outlived
            # its stop timeout would otherwise deregister the NEXT recording,
            # leaving that one unstoppable and its subscriber queue attached to
            # the recv path for the life of the process.
            if _IMU_CSV['thread'] is threading.current_thread():
                _IMU_CSV['thread'] = None

    t = threading.Thread(target=worker, name="imu-csv", daemon=True)
    _IMU_CSV.update(thread=t, stop=stop, path=path, rows=0)
    t.start()
    print(f"[IMU] recording to {path} (imu_csv stop to finish)")

def imu_csv_stop():
    t = _IMU_CSV['thread']
    if t is None:
        print("[IMU] not recording")
        return
    _IMU_CSV['stop'].set()
    t.join(timeout=2.0)
    print(f"[IMU] recorded {_IMU_CSV['rows']} samples to {_IMU_CSV['path']}")
    _IMU_CSV.update(thread=None, stop=None, path=None)

# --- I2C bus scan + EEPROM read (CMD_I2C_SCAN / CMD_EEPROM_READ) --------------
# Generic probes of a headstage port's freed-CIPO I2C bus. Keep the reply
# layouts in sync with firmware pl_i2c_probe.h.
I2C_ADDR_FIRST, I2C_ADDR_LAST = 0x08, 0x77   # firmware refuses outside this (network.c)
CMD_I2C_SCAN = 0xB7
CMD_EEPROM_READ = 0xB9
I2CSCAN_VERSION = 0x49324353    # "I2CS"
EEPROMRD_VERSION = 0x45455244   # "EERD"

def i2c_scan(sock, port='a'):
    """Scan one port's I2C bus (0x08-0x77) and print an i2cdetect-style map.
    Needs a fabric with that port's IIC; refused while streaming/imu_stream."""
    p = 0 if str(port).lower() in ('0', 'a') else 1
    ok, data = send_binary_command(sock, CMD_I2C_SCAN, param1=p, timeout=3.0)
    if not ok or data is None or len(data) < 24:
        print(f"[I2C] scan refused/failed on port {'B' if p else 'A'} -- fabric "
              f"without that port's I2C, or streaming/imu_stream active?")
        return None
    status = struct.unpack_from('<I', data, 0)[0]
    bitmap = data[4:20]
    ver = struct.unpack_from('<I', data, 20)[0]
    if ver != I2CSCAN_VERSION:
        print(f"[I2C] unexpected version 0x{ver:08X}")
    if status & 1:
        print(f"[I2C] port {'B' if p else 'A'}: BUS WEDGED at address "
              f"0x{(status >> 8) & 0xFF:02X} -- scan aborted (is this cable "
              f"actually a 128-ch LVDS headstage?)")
        return None
    found = [a for a in range(0x08, 0x78) if bitmap[a >> 3] & (1 << (a & 7))]
    print(f"[I2C] port {'B' if p else 'A'} bus map (0x08-0x77):")
    print("      " + " ".join(f"{c:2x}" for c in range(16)))
    for row in range(0, 0x80, 16):
        cells = []
        for a in range(row, row + 16):
            if a < 0x08 or a > 0x77:
                cells.append("  ")
            elif bitmap[a >> 3] & (1 << (a & 7)):
                cells.append(f"{a:02x}")
            else:
                cells.append("--")
        print(f"  {row:02x}: " + " ".join(cells))
    notes = []
    if 0x28 in found:
        notes.append("0x28 = BNO055")
    eep = [a for a in found if 0x50 <= a <= 0x57]
    if len(eep) == 8:
        notes.append("0x50-0x57 all ACK: likely ONE <=16Kbit 24xx EEPROM "
                     "(block addressing), not 8 devices")
    elif eep:
        notes.append(f"24xx EEPROM candidate at {', '.join(hex(a) for a in eep)}")
    if notes:
        print("      " + "; ".join(notes))
    return found

def eeprom_read(sock, port='a', i2c_addr=0x50, offset=0, length=32, width=1):
    """Read bytes from a device on the port's I2C bus (24xx EEPROM, or any
    register file). width: 1 = one offset byte (<=16Kbit 24xx), 2 = two
    (>=32Kbit). Non-destructive."""
    p = 0 if str(port).lower() in ('0', 'a') else 1
    # Do NOT mask. 0xA0 is the 8-bit write address printed on essentially every
    # 24xx datasheet, so it is what a user reaches for -- and masking it to 7
    # bits yields 0x20, a perfectly plausible OTHER device, whose bytes would
    # then be hex-dumped under the 0xA0 heading. Refuse instead.
    addr = int(i2c_addr, 0) if isinstance(i2c_addr, str) else int(i2c_addr)
    if not (I2C_ADDR_FIRST <= addr <= I2C_ADDR_LAST):
        print(f"[EEPROM] device address 0x{addr:02X} is outside the "
              f"7-bit range 0x{I2C_ADDR_FIRST:02X}-0x{I2C_ADDR_LAST:02X}. "
              f"Datasheets often quote the 8-bit form (0xA0); use the 7-bit "
              f"address (0x50).")
        return None
    if int(length) > 32:
        # One command is one bounded I2C transaction; say so rather than
        # silently returning a third of what was asked for.
        print(f"[EEPROM] {length} bytes requested; reading 32 (the per-command "
              f"maximum). Repeat with offset {offset + 32} for the next chunk.")
    length = min(int(length), 32)
    p1 = (p << 16) | ((int(width) & 0xFF) << 8) | (int(i2c_addr) & 0x7F)   # in range, checked above
    p2 = ((int(offset) & 0xFFFF) << 8) | length
    ok, data = send_binary_command(sock, CMD_EEPROM_READ, param1=p1, param2=p2,
                                   timeout=3.0)
    if not ok or data is None or len(data) < 44:
        print("[EEPROM] read refused/failed -- fabric without that port's I2C, "
              "or streaming/imu_stream active?")
        return None
    status, nbytes = struct.unpack_from('<II', data, 0)
    payload = data[8:8 + min(nbytes, 32)]
    ver = struct.unpack_from('<I', data, 40)[0]
    if ver != EEPROMRD_VERSION:
        print(f"[EEPROM] unexpected version 0x{ver:08X}")
    if status == 1 and nbytes == 0:
        print(f"[EEPROM] no ACK from 0x{i2c_addr:02X} on port {'B' if p else 'A'}")
        return None
    if status == 1:
        # The firmware also reports 1 for a NACK/arbitration loss part-way
        # through the read, after some bytes have landed. Those bytes are real
        # -- discarding them would read as "the device is absent" when it is
        # actually present and the transfer was cut short.
        print(f"[EEPROM] transfer cut short after {nbytes} of {length} bytes "
              f"(NACK or lost arbitration mid-read); showing what arrived")
    if (status & 0xFF) in (2, 3):
        print(f"[EEPROM] timed out (got {nbytes}/{length} bytes) -- wedged bus "
              f"or wrong addr width?")
        if not nbytes:
            return None
    print(f"[EEPROM] port {'B' if p else 'A'} dev 0x{i2c_addr:02X} "
          f"offset {offset} ({width}-byte addressing): {nbytes} bytes")
    for i in range(0, len(payload), 16):
        chunk = payload[i:i + 16]
        hexs = " ".join(f"{b:02x}" for b in chunk)
        text = "".join(chr(b) if 32 <= b < 127 else "." for b in chunk)
        print(f"    {offset + i:04x}: {hexs:<47} {text}")
    return bytes(payload)

# --- Config swap on the acquisition firmware (CMD_SET_CONFIG) -----------------
# PCAP-swap the whole PL fabric to a named config. Only accepted when NOT
# streaming (stop first); the board resets the master timestamp on a successful
# acquisition load, so treat everything after as a fresh epoch. Phase 1a exposes
# Append-only selectors (firmware pl_configs order): acquisition=128-ch/no-IMU,
# scan=I2C-probe fabric, acq_imu_both=64-ch/port + BNO055 on both cables,
# acq_imu_port_a/_b = one cable 64-ch+IMU and the other 128-ch LVDS.
# PCAP loader status codes, shared by every command that programs the PL.
_PL_STATUS = {
    0: "ok", 1: "SD mount failed", 2: "bitstream not found on SD",
    3: "SD read failed", 4: "empty bitstream file", 5: "bitstream too large",
    6: "devcfg init failed", 7: "fabric init timeout", 8: "PCAP transfer rejected",
    9: "PCAP DMA never done", 10: "FPGA done never asserted", 11: "PCAP error flags set",
    0xFFFFFFFF: "unknown image selector",
}

CMD_SET_CONFIG = 0xB4
# Selector order mirrors the firmware's pl_configs[] exactly -- it is an index
# into that table, so the two move together.
CONFIGS = {"acquisition": 0, "acq_imu_both": 1,
           "acq_imu_port_a": 2, "acq_imu_port_b": 3}
CENSUS_FABRIC = "acq_imu_both"   # the only fabric with I2C on BOTH ports

def set_config(sock, name):
    if name not in CONFIGS:
        print(f"[CONFIG] unknown '{name}'; known: {', '.join(CONFIGS)}")
        return None
    ok, data = send_binary_command(sock, CMD_SET_CONFIG, param1=CONFIGS[name], timeout=15.0)
    if not ok:
        print("[CONFIG] refused/failed -- streaming active? (stop first), or wrong firmware")
        return None
    if data is None or len(data) < 12:
        print("[CONFIG] short/no response")
        return None
    rc, nbytes, flags = struct.unpack('<iII', data[:12])
    is_acq, link_up = bool(flags & 1), bool(flags & 2)
    if rc == 0:
        kind = "acquisition ready" if is_acq else "non-acquisition fabric (no streaming)"
        print(f"Config '{name}': {nbytes} bytes loaded, {kind}, "
              f"link {'UP' if link_up else 'DOWN(!)'}, master timestamp reset.")
    elif rc < 0:
        print(f"Config '{name}' FAILED: unknown selector (rc={rc})")
    else:
        print(f"Config '{name}' FAILED: {_PL_STATUS.get(rc, f'error {rc}')} (rc={rc})")
    return {"rc": rc, "bytes": nbytes, "is_acq": is_acq, "link_up": link_up}

CMD_PL_STATUS = 0xB5
_CONFIG_NAMES = {v: k for k, v in CONFIGS.items()}   # 0->acquisition ... 4->acq_imu_port_b
_CONFIG_NAMES[-1] = "blank (no fabric)"

def pl_status(sock, verbose=True):
    """Query which PL fabric is loaded. Works in ANY fabric state (blank / scan /
    acquisition) because the firmware answers from its loader record, not from a PL
    register -- so a host reconnecting after a drop can learn the board's config and
    recover (e.g. it was left in the detect fabric mid-rescan). Returns a dict or
    None. docs/boot.md."""
    ok, data = send_binary_command(sock, CMD_PL_STATUS, timeout=2.0)
    if not ok or data is None or len(data) < 8:
        if verbose:
            print("[PL] no PL_STATUS response -- firmware without the config-swap loader?")
        return None
    config, flags = struct.unpack('<iI', data[:8])
    is_acq, link_up = bool(flags & 1), bool(flags & 2)
    name = _CONFIG_NAMES.get(config, f"config {config}")
    if verbose:
        print(f"PL fabric: {name} (config={config}), "
              f"{'acquisition' if is_acq else 'non-acq'}, link {'UP' if link_up else 'DOWN'}")
    return {"config": config, "name": name, "is_acq": is_acq, "link_up": link_up}

# --- rescan: one-shot inventory + fabric selection ----------------------------
# Composes existing pieces; no new firmware.
#
# Why it is shaped this way -- survey of the detection machinery it builds on:
#   * auto_cable_detect (CableDetection.detect) is the ONLY per-cable "is an RHD
#     headstage present?" probe: ce=0xFF packs all four CIPO lanes (A0/A1/B0/B1)
#     into every packet and a 16-phase sweep scores each lane independently.
#   * CMD_READ_REGISTER 0x73 / aux_selftest ('INTAN' ROM regs 40-44) CANNOT
#     serve: the slot-2 inject result register is PORT A ONLY (register-map.md,
#     status reg 12) and the inject path requires active streaming.
#   * detect_imu (CMD_DETECT_IMU) probes a port's BNO055 only on a fabric whose
#     port has an AXI IIC; acq_imu_both (CENSUS_FABRIC) has one on each.
# No single fabric can run both probes on one port (the IMU I2C occupies the
# freed CIPO1 balls), so rescan is a two-fabric dance:
#     acq_imu_both -> IMU census -> pick fabric -> load it -> phase-sweep detect.
#
# ASSUMPTIONS:
#   1. IMU presence alone selects the fabric (both->acq_imu_both, A->_port_a,
#      B->_port_b, neither->acquisition). Chip detection runs AFTER, only to set
#      phases + channel mask on the chosen fabric -- it cannot influence the
#      choice because it needs an acquisition fabric to run at all.
#   2. Probing I2C on a cable that carries a plain 128-ch headstage (the census
#      fabric drives SCL/SDA into what that headstage drives as LVDS CIPO1) is
#      believed electrically harmless for the ~ms probe and reads as "no IMU".
#      SO FAR WE HAVE NOT SEEN ISSUES on the cables in the lab. That is bench
#      experience, not a datasheet argument about contention between an
#      open-drain driver and an LVDS output, so treat it as "no evidence of
#      harm" rather than "proven safe" -- if a cable ever misbehaves after a
#      rescan, this is the first thing to suspect.
#   3. On acq_imu_* fabrics the freed CIPO1 lane(s) are expected to score below
#      DETECTION_THRESHOLD in the sweep (tied-off input, no test sine) -- and
#      rescan ENFORCES it: any freed-lane bit that sneaks into the detected
#      mask is corrected out (_RESCAN_FREED_MASK) and re-applied before use.
#   4. The ce=0xFF detection packet keeps its 154-word four-lane layout on the
#      64-ch variants (the packetizer RTL is unchanged; only the LVDS buffer
#      drops a lane), so the validator/scorer need no resize.
#   5. set_config resets the master timestamp -- a rescan starts a fresh epoch,
#      so never run it mid-recording.
#
# DECIDED (2026-07-31, Caleb):
#   * Empty cable counts as "plain LVDS", so two empty ports load 'acquisition'.
#     That is the wanted behavior: the board lands on a usable acquisition
#     fabric whether or not anything is plugged in, rather than parking on a
#     census fabric that cannot stream.
#   * rescan leaves streaming STOPPED, deliberately. Detection's apply stops the
#     stream to latch the channel mask, and restarting it here would hide that a
#     rescan resets the master timestamp (assumption 5) -- the host should
#     re-'start' knowingly, on a fresh epoch.
#   * "IMU present but no chip on that cable's CIPO0" is a probable seating
#     fault, but net.py deliberately does NOT special-case it: the per-port
#     census and per-lane scores are already printed, and a human reading them
#     can see it. It is surfaced as a notification in the Open Ephys plugin
#     instead (IntanSocket::rescanDevice), which is where an operator is
#     actually looking during a recording setup.

# (imu_a_present, imu_b_present) -> fabric name in CONFIGS
_RESCAN_FABRIC = {
    (True, True): "acq_imu_both",
    (True, False): "acq_imu_port_a",
    (False, True): "acq_imu_port_b",
    (False, False): "acquisition",
}
# Channel-enable bits with no LVDS pair behind them on each IMU fabric (the
# freed CIPO1 lanes: A.CIPO1 = bits 2|3, B.CIPO1 = bits 6|7). Detection scoring
# should never pass threshold on a tied-off input, but if it ever does, rescan
# CORRECTS the applied mask (a phantom lane would stream garbage words forever)
# and says so.
_RESCAN_FREED_MASK = {
    "acq_imu_both": 0xCC, "acq_imu_port_a": 0x0C, "acq_imu_port_b": 0xC0,
    "acquisition": 0x00,
}

def rescan(sock, with_chip_detect=True):
    """Work out what is plugged into each headstage port and load the matching
    fabric: scan-fabric IMU census -> set_config the right acq variant -> full
    phase-sweep chip detection (phases + channel mask) on the result. Returns
    {'imu_a','imu_b','fabric','detection'} or None on abort; the board is left
    on whatever fabric was loaded last (check pl_status)."""
    pl = pl_status(sock, verbose=False)
    if pl is None:
        print("[RESCAN] aborted -- no PL_STATUS reply (firmware without the "
              "config-swap loader?)")
        return None
    print(f"[RESCAN] starting from fabric '{pl['name']}'")

    # set_config refuses while streaming, so stop first -- but ONLY on an
    # acquisition fabric. A blank or scan PL refuses every command outside the
    # fabric-swap allow-list, so an unconditional stop prints a bare "Command
    # failed (status: 0x15)" before rescan has done anything, which reads like
    # a fault when it is just a command that does not apply yet.
    if pl['is_acq']:
        send_binary_command(sock, CMD_STOP)
        time.sleep(0.05)

    # Census on acq_imu_both: it is the only fabric with I2C on BOTH ports, so
    # it is the only one that can see a headstage on either. It is also an
    # ACQUISITION fabric with the UART routed, so unlike the retired scan fabric
    # the console stays alive here -- and when the answer turns out to be "both
    # ports", we are already on the right fabric and skip a second PCAP load.
    print(f"[RESCAN] 1/3 IMU census on '{CENSUS_FABRIC}' ...")
    r = set_config(sock, CENSUS_FABRIC)
    if not r or r["rc"] != 0:
        print(f"[RESCAN] aborted -- could not load '{CENSUS_FABRIC}'")
        return None
    imu = detect_imu(sock)
    if imu is None:
        print(f"[RESCAN] aborted -- detect_imu refused on '{CENSUS_FABRIC}' (bug?)")
        return None
    imu_a, imu_b = imu['A']['present'], imu['B']['present']

    target = _RESCAN_FABRIC[(imu_a, imu_b)]
    census = f"A={'yes' if imu_a else 'no'} B={'yes' if imu_b else 'no'}"
    if target == CENSUS_FABRIC:
        # Already here -- the census fabric IS the answer, so skip a PCAP load.
        print(f"[RESCAN] 2/3 IMU: {census} -> '{target}' already loaded")
        r = {"rc": 0}
    else:
        print(f"[RESCAN] 2/3 IMU: {census} -> loading '{target}' ...")
        r = set_config(sock, target)
    if not r or r["rc"] != 0:
        print(f"[RESCAN] aborted -- could not load '{target}'; the board is "
              f"still on '{CENSUS_FABRIC}' (pl_status to confirm)")
        return None

    detection = None
    if with_chip_detect:
        print("[RESCAN] 3/3 chip detection (phase sweep) ...")
        detection = run_detection(sock, verbose=False)
        freed = _RESCAN_FREED_MASK[target]
        # What the BOARD is actually left holding, which is not the same as what
        # detection returned. The sweep unconditionally programs
        # DETECTION_CHANNEL_ENABLE (0xFF) to score all four lanes, and only
        # applies a narrowed mask when it SUCCEEDS. So a failed sweep -- chips
        # unseated, say -- leaves 0xFF on an IMU fabric, i.e. every freed CIPO1
        # lane enabled with no LVDS pair behind it. That is exactly the phantom
        # lane this correction exists to prevent, so it must run whether or not
        # detection succeeded.
        on_board = (detection.optimal_channel_mask if detection.success
                    else DETECTION_CHANNEL_ENABLE)
        if on_board & freed:
            fixed = on_board & ~freed
            why = "detected" if detection.success else "left by the sweep"
            print(f"[RESCAN] correcting mask 0x{on_board:02X} -> 0x{fixed:02X} "
                  f"({why}): bits 0x{on_board & freed:02X} have no LVDS pair on "
                  f"'{target}' (freed for the IMU I2C)")
            # Latches only while stopped; apply_config already stopped us, and on
            # the failure path the sweep never started streaming.
            send_binary_command(sock, CMD_SET_CHANNEL_ENABLE, fixed)
            validator.set_channel_enable(fixed)
            if fixed == 0:
                print("[RESCAN] no real lanes remain -- reseat the headstage, "
                      "then rescan (phases left as-is)")
            detection.optimal_channel_mask = fixed
    else:
        print("[RESCAN] 3/3 chip detection skipped (with_chip_detect=False)")

    print(f"[RESCAN] done: fabric '{target}', IMU A={'Y' if imu_a else 'n'} "
          f"B={'Y' if imu_b else 'n'}"
          + (f", {detection.get_channel_summary()}" if detection else ""))
    if imu_a or imu_b:
        spec = 'both' if (imu_a and imu_b) else ('a' if imu_a else 'b')
        print(f"[RESCAN] IMU ready: `imu_stream {spec}` (before `start`), "
              f"then `imu_recv` / `imu_csv`")
    return {"imu_a": imu_a, "imu_b": imu_b, "fabric": target,
            "detection": detection}

def print_command_help():
    """The single command menu -- printed at connect AND by the `help` command,
    so the two can't drift. (The `help` command used to be a separate stale copy
    missing stim / IMU / PL / set_config.)"""
    print("\n[TCP] Available commands:")
    print("  Basic: start, stop, reset_timestamp, loop <count>")
    print("  COPI: convert, init, cable_test, full_cable_test, manual_cable_test")
    print("  Config: set_phase <p0> <p1> [p2 p3], set_debug <0|1>, set_channels <0x00-0xFF>")
    print("  Network: set_udp <ip> <port>, get_status, perf_reset, ping")
    print("  Debug: dump_bram [start] [count], stats, hex")
    print("  LFP: lfp_config [linear|minimum] [taps], lfp_on, lfp_off, lfp_recv [n], lfp_sink  (UDP_PORT, stream_type=2)")
    print("         verify_sine [ce=FF] [n=300] - check debug sinewaves vs RTL ref")
    print("  Chirp: chirp [f_max=1400] [period=2.0] [stride=4], chirp_off  (analytic swept sine)")
    print("  IMU: detect_imu  (probe both ports for a BNO055 -- on the scan or acq_imu_both fabric)")
    print("       imu_read [a|b]  (one NDOF sample: quat/accel/gyro/calib -- not while streaming)")
    print("       imu_stream [a|b|both|off] [period_ms]  (continuous 100 Hz stream_type=3; start BEFORE 'start')")
    print("       imu_recv [n]  (print live samples)   imu_csv [file|stop]  (record to CSV)")
    print("  I2C: i2c_scan [a|b]  (bus ACK map 0x08-0x77)   eeprom_read [a|b] [dev=0x50] [off=0] [len=32] [width=1]")
    print(f"  Rescan: rescan  (IMU census on '{CENSUS_FABRIC}' -> load the matching fabric -> chip detect; rescan noapply skips chip detect)")
    print(f"       set_config <{'|'.join(CONFIGS)}>  (PCAP-swap the whole fabric; only when NOT streaming; the board boots on 'acquisition')")
    print("       pl_status  (which fabric is loaded -- works in any state; auto-shown on connect)")
    print("  Stim: stim_status, stim_gaussian [amp_v] [sigma_ms] [k] [A|B|both], stim_sine [hz] [amp_v] [k] [A|B|both]")
    print("        stim_dc <volts_a> [volts_b] (hold constant level), stim_dc_off")
    print("        stim_start [cont], stim_stop, stim_trigger, stim_zero, stim_powerdown")
    print("        stim_rate <k>, stim_arm <line> <edge|gate> [pol] [minpulse_us] [retrig], stim_disarm")
    print("          (stim_arm = fire playback from a digital-in line: edge=once per trigger edge, gate=play while asserted; pol 0=rising/high, 1=falling/low)")
    print("  LFP sweep: lfp_sweep [f_max=1490] [period=2.0] [n_periods=2]  (measure anti-alias |H(f)|)")
    print("  auto_cable_detect - Automated cable detection!")
    print("  Aux: aux_demo, aux_bank <slot> <bank>, aux")
    print("       read_reg <r>, write_reg <r> <v>, aux_selftest")
    print("       fast_settle <0|1> [dsp] | gpio <pin> | off")
    print("       digout <0|1> | gpio <pin> | hiz")
    print("  Utility: help, quit")

# Unified port: the LFP band now arrives on UDP_PORT mixed with broadband,
# demuxed by stream_type=2. The persistent UnifiedSink (created in __main__)
# drains 5000 promiscuously and fans the LFP frames out to subscribers, so the
# host never replies ICMP port-unreachable to the board while LFP streams.
UNIFIED_SINK = None
LFP_COEF_FRAC = 17          # Q1.17 coefficient fixed-point

AUX_BANK_ENTRIES = 64       # entries per bank (PL aux_command_sequencer ADDR_W=6)

# RHD2000 SPI command encodings (datasheet-confirmed; see docs/)
def rhd_convert(ch, h=0):
    """CONVERT(ch); h=1 sets bit H (DSP high-pass reset when DSP enabled)"""
    return ((ch & 0x3F) << 8) | (h & 1)

def rhd_write(reg, val):
    """WRITE(reg, val)"""
    return 0x8000 | ((reg & 0x3F) << 8) | (val & 0xFF)

def rhd_read(reg):
    """READ(reg)"""
    return 0xC000 | ((reg & 0x3F) << 8)

def rhd_decode(cmd):
    """Human-readable form of an echoed RHD command word"""
    top = (cmd >> 14) & 0x3
    arg = (cmd >> 8) & 0x3F
    if top == 0:
        names = {32: 'aux1/accelX', 33: 'aux2/accelY', 34: 'aux3/accelZ',
                 48: 'supply', 49: 'temp'}
        tag = f" ({names[arg]})" if arg in names else ""
        h = " +H" if (cmd & 1) else ""
        return f"CONVERT({arg}){tag}{h}"
    if top == 2:
        return f"WRITE({arg}, 0x{cmd & 0xFF:02X})"
    if top == 3:
        return f"READ({arg})"
    if cmd == 0x5500:
        return "CALIBRATE"
    return f"0x{cmd:04X}"

# Default aux commands. Only slot 0 cycles (the accelerometer sweep); slots 1 and
# 2 are single command registers.
AUX_SLOT0_DEFAULT = [rhd_convert(32), rhd_convert(33), rhd_convert(34)]  # slot 0 accel sweep @10 kHz
AUX_SLOT1_DEFAULT = [rhd_read(40)]     # slot 1 fs register: INTAN ROM 'I' (register 40)
AUX_SLOT2_DEFAULT = [rhd_convert(49)]  # slot 2 inject register: temperature aux-ADC channel
# Deeper housekeeping (supply, chip-ID, #amps, full 'INTAN' ROM) is read on demand
# via read_register (chip ID reg 63, #amps 62, 'INTAN' ROM 40-44) or an injected
# CONVERT(48) for supply voltage.
HOUSEKEEPING_REGS = {"chip_id": 63, "num_amps": 62, "intan_rom": [40, 41, 42, 43, 44]}

# ACK status codes
ACK_SUCCESS = 0x06
ACK_ERROR = 0x15

# Cable test constants - ALWAYS use all channels for cable test
CABLE_TEST_CHANNEL_ENABLE = 0x0F  # All channels always
CABLE_TEST_PACKET_SIZE_WORDS = 84  # 14-word unified header + 70 data words
CABLE_TEST_PACKET_SIZE_BYTES = CABLE_TEST_PACKET_SIZE_WORDS * 4

# Cable test globals
cable_test_mode = False
cable_test_packets_captured = 0
manual_cable_test_mode = False

# ============================================================================
# AUTOMATED CABLE DETECTION CLASSES
# ============================================================================

# Automated cable detection mirrors the OpenEphys plugin's runAutoDetection /
# testPhaseParallel / scoreChannel (Source/IntanInterface.cpp). Both SPI ports
# are detected in PARALLEL: channel_enable = 0xFF puts port A's CIPO0/CIPO1 AND
# port B's CIPO0/CIPO1 into every packet as four tightly-packed lanes, so one
# 16-value phase sweep scores all four lanes and picks a best phase PER PORT.

# --- Detection tuning (mirror IntanInterface.cpp anonymous-namespace constants)
DETECTION_THRESHOLD = 60.0        # a lane counts as detected only above this
NUM_PHASES_TO_TEST = 16
DETECTION_LOOP_COUNT = 0          # 0 = infinite; finite counts emit zero UDP
                                  # (firmware holds a one-packet guard band)
DETECTION_CHANNEL_ENABLE = 0xFF   # both ports, all 8 streams -> A and B parallel

# The unified broadband header is 14 words; scoreChannel slices the data block
# from here. Slicing at 8 (the length of the COMMON header alone) would read the
# 6 broadband-specific header words as data and mis-locate every lane.
CABLE_TEST_DATA_OFFSET_WORDS = 14  # == BB_HEADER_WORDS (defined later in module)

# Detection packet with ce=0xFF: 14-word unified header + 140 data = 154 words.
# (== calculate_packet_size(0xFF); hardcoded here because that helper is defined
# later in the module.) The validator gates detection packets on this size.
DETECTION_PACKET_SIZE_WORDS = 154
DETECTION_PACKET_SIZE_BYTES = DETECTION_PACKET_SIZE_WORDS * 4

# Expected patterns and chip IDs (mirror IntanInterface.cpp)
INTAN_PATTERN = [0x0049, 0x004E, 0x0054, 0x0041, 0x004E]  # 'I', 'N', 'T', 'A', 'N'
CHIP_ID_RHD2164 = 4    # 64-channel, with DDR
CHIP_ID_RHD2132 = 1    # 32-channel, no DDR
CHIP_ID_RHD2216 = 2    # 16-channel, no DDR (scored as RHD2132)
MISO_REG_DDR = 0x35    # MISO register regular word when DDR available
MISO_DDR_DDR = 0x3A    # MISO register DDR word when DDR available
MISO_NO_DDR = 0x00     # MISO register when no DDR

# Chip type labels (mirror ChipType / chipTypeToString)
CHIP_TYPE_NONE = "None"
CHIP_TYPE_RHD2132 = "RHD2132"
CHIP_TYPE_RHD2164 = "RHD2164"


@dataclass
class _LaneBest:
    """Per-CIPO-lane best across the sweep (mirror IntanInterface::LaneBest).
    stride/offset pick this lane out of the tightly-packed data block: with
    ce=0xFF every SPI cycle emits 4 words (A.CIPO0, A.CIPO1, B.CIPO0, B.CIPO1),
    so stride=4 and offset 0..3."""
    label: str
    stride: int
    offset: int
    best_score: float = 0.0
    best_type: str = CHIP_TYPE_NONE
    best_has_ddr: bool = False
    best_phase: int = 0
    detected: bool = False


@dataclass
class PhaseResult:
    """Raw per-phase scores for all four lanes (order: A.CIPO0, A.CIPO1,
    B.CIPO0, B.CIPO1)."""
    phase: int
    scores: List[float]
    chip_types: List[str]
    has_ddr: List[bool]


@dataclass
class DetectionResult:
    """Dual-port detection result (mirror AutoDetectionResult)."""
    success: bool
    chips_detected: bool
    best_phase0: int              # port A phase (CMD_SET_PHASE)
    best_phase1: int              # port B phase (CMD_SET_PHASE_B)
    optimal_channel_mask: int
    # Port A
    cipo0_detected: bool
    cipo0_chip_type: str
    cipo0_has_ddr: bool
    cipo0_score: float
    cipo1_detected: bool
    cipo1_chip_type: str
    cipo1_has_ddr: bool
    cipo1_score: float
    # Port B
    portb_cipo0_detected: bool
    portb_cipo0_chip_type: str
    portb_cipo0_has_ddr: bool
    portb_cipo1_detected: bool
    portb_cipo1_chip_type: str
    portb_cipo1_has_ddr: bool
    all_phases: List[PhaseResult]

    def summary(self) -> str:
        if not self.success:
            return "Detection failed. Check connections and try manual configuration."
        if not self.chips_detected:
            return ("No Intan chips detected. Verify:\n"
                    "  - SPI cable connections\n"
                    "  - Chip power supply\n"
                    "  - Cable integrity")
        lines = ["Chips detected!",
                 f"  Port A phase: {self.best_phase0}",
                 f"  Port B phase: {self.best_phase1}",
                 f"  Channel Mask: 0x{self.optimal_channel_mask:X}"]
        if self.cipo0_detected:
            lines.append(f"  A.CIPO0: {self.cipo0_chip_type}")
        if self.cipo1_detected:
            lines.append(f"  A.CIPO1: {self.cipo1_chip_type}")
        if self.portb_cipo0_detected:
            lines.append(f"  B.CIPO0: {self.portb_cipo0_chip_type}")
        if self.portb_cipo1_detected:
            lines.append(f"  B.CIPO1: {self.portb_cipo1_chip_type}")
        best_score = self.cipo0_score + self.cipo1_score
        lines.append(f"  Detection Confidence: {'High' if best_score > 100 else 'Medium'}")
        return "\n".join(lines)

    def get_channel_summary(self) -> str:
        if not self.chips_detected:
            return "No chips detected"
        channels = []
        if self.cipo0_detected:
            channels.append(f"A.CIPO0 ({self.cipo0_chip_type})")
        if self.cipo1_detected:
            channels.append(f"A.CIPO1 ({self.cipo1_chip_type})")
        if self.portb_cipo0_detected:
            channels.append(f"B.CIPO0 ({self.portb_cipo0_chip_type})")
        if self.portb_cipo1_detected:
            channels.append(f"B.CIPO1 ({self.portb_cipo1_chip_type})")
        if not channels:
            return "No active channels"
        return "Active channels: " + ", ".join(channels)


def _empty_detection_result() -> DetectionResult:
    return DetectionResult(
        success=False, chips_detected=False,
        best_phase0=0, best_phase1=0, optimal_channel_mask=0,
        cipo0_detected=False, cipo0_chip_type=CHIP_TYPE_NONE,
        cipo0_has_ddr=False, cipo0_score=0.0,
        cipo1_detected=False, cipo1_chip_type=CHIP_TYPE_NONE,
        cipo1_has_ddr=False, cipo1_score=0.0,
        portb_cipo0_detected=False, portb_cipo0_chip_type=CHIP_TYPE_NONE,
        portb_cipo0_has_ddr=False,
        portb_cipo1_detected=False, portb_cipo1_chip_type=CHIP_TYPE_NONE,
        portb_cipo1_has_ddr=False,
        all_phases=[])


class CableDetection:
    def __init__(self, send_tcp_command_func, validator=None):
        """
        send_tcp_command_func(cmd_id, param1, param2) -> (success: bool, data)
        validator (optional): the DataValidator, so detection can resize the
        expected packet to the dual-port (0xFF) format, mirroring the plugin's
        updateChannelEnable(). Without it, the validator would reject the
        616-byte detection packets as wrong-size and never feed the detector.
        """
        self.send_cmd = send_tcp_command_func
        self.validator = validator
        self.packet_queue = queue.Queue()
        self.capturing = False

    def capture_packet(self, words: List[int]):
        """Callback for the UDP validator to provide packets during detection."""
        if self.capturing:
            try:
                self.packet_queue.put_nowait(list(words))
            except queue.Full:
                pass

    def _drain_queue(self):
        while not self.packet_queue.empty():
            try:
                self.packet_queue.get_nowait()
            except queue.Empty:
                break

    def detect(self, verbose=False) -> DetectionResult:
        """Run dual-port detection: sweep 16 phases, score all four CIPO lanes
        per phase, and pick the best phase per port (mirror runAutoDetection)."""
        result = _empty_detection_result()

        try:
            if verbose:
                print("[Detection] Starting automated chip detection "
                      "(port A + port B, parallel)...")

            if not self._initialize_chips(verbose):
                return result

            # Per-lane bookkeeping (order matches the packed data-word order).
            lanes = [
                _LaneBest("A.CIPO0", 4, 0),
                _LaneBest("A.CIPO1", 4, 1),
                _LaneBest("B.CIPO0", 4, 2),
                _LaneBest("B.CIPO1", 4, 3),
            ]

            for phase in range(NUM_PHASES_TO_TEST):
                scores, types = self._test_phase(phase, lanes, verbose)
                if scores is None:
                    continue  # no packet received this phase

                # Track the best phase per lane independently (different cable
                # lengths can prefer different phases).
                for i in range(4):
                    if scores[i] > DETECTION_THRESHOLD and scores[i] > lanes[i].best_score:
                        lanes[i].best_score = scores[i]
                        lanes[i].best_type = types[i]
                        lanes[i].best_has_ddr = (types[i] == CHIP_TYPE_RHD2164)
                        lanes[i].best_phase = phase
                        lanes[i].detected = True

                if verbose and sum(scores) > 0:
                    print(f"  Phase {phase}: A.CIPO0={scores[0]:.0f} "
                          f"A.CIPO1={scores[1]:.0f} B.CIPO0={scores[2]:.0f} "
                          f"B.CIPO1={scores[3]:.0f}")

                result.all_phases.append(PhaseResult(
                    phase=phase,
                    scores=list(scores),
                    chip_types=list(types),
                    has_ddr=[t == CHIP_TYPE_RHD2164 for t in types]))

            # Port A: lanes[0]/lanes[1]; Port B: lanes[2]/lanes[3].
            result.cipo0_detected = lanes[0].detected
            result.cipo0_chip_type = lanes[0].best_type
            result.cipo0_has_ddr = lanes[0].best_has_ddr
            result.cipo0_score = lanes[0].best_score
            result.cipo1_detected = lanes[1].detected
            result.cipo1_chip_type = lanes[1].best_type
            result.cipo1_has_ddr = lanes[1].best_has_ddr
            result.cipo1_score = lanes[1].best_score

            result.portb_cipo0_detected = lanes[2].detected
            result.portb_cipo0_chip_type = lanes[2].best_type
            result.portb_cipo0_has_ddr = lanes[2].best_has_ddr
            result.portb_cipo1_detected = lanes[3].detected
            result.portb_cipo1_chip_type = lanes[3].best_type
            result.portb_cipo1_has_ddr = lanes[3].best_has_ddr

            result.best_phase0 = self._pick_phase(lanes[0], lanes[1])
            result.best_phase1 = self._pick_phase(lanes[2], lanes[3])

            result.chips_detected = any(lane.detected for lane in lanes)
            result.success = result.chips_detected

            # Combined 8-bit mask: port A in [3:0], port B in [7:4]; the odd bit
            # in each pair adds the lane's DDR stream.
            mask = 0
            if lanes[0].detected:
                mask |= 0x01
                if lanes[0].best_has_ddr:
                    mask |= 0x02
            if lanes[1].detected:
                mask |= 0x04
                if lanes[1].best_has_ddr:
                    mask |= 0x08
            if lanes[2].detected:
                mask |= 0x10
                if lanes[2].best_has_ddr:
                    mask |= 0x20
            if lanes[3].detected:
                mask |= 0x40
                if lanes[3].best_has_ddr:
                    mask |= 0x80
            result.optimal_channel_mask = mask

            if verbose:
                if result.success:
                    print(f"[Detection] Complete. Port A phase={result.best_phase0} "
                          f"port B phase={result.best_phase1} "
                          f"mask=0x{result.optimal_channel_mask:X}")
                    print(f"[Detection] {result.get_channel_summary()}")
                else:
                    print("[Detection] No chips detected on either port")

        except Exception as e:
            if verbose:
                print(f"[Detection] Error: {e}")

        return result

    @staticmethod
    def _pick_phase(a: _LaneBest, b: _LaneBest) -> int:
        """Pick one phase for a port: the better-scoring of its two CIPO lanes
        (mirror the pickPhase lambda in runAutoDetection)."""
        if a.detected and b.detected:
            return a.best_phase if a.best_score >= b.best_score else b.best_phase
        if a.detected:
            return a.best_phase
        if b.detected:
            return b.best_phase
        return 0

    def apply_config(self, result: DetectionResult) -> bool:
        """Apply detected port-A and port-B phases + channel mask, then load the
        normal convert sequence (mirror applyDetectionConfig)."""
        if not result.success:
            return False

        # Stop before applying the mask: control registers latch only while
        # transmission is inactive, so setting channel_enable mid-stream keeps the
        # old (0xFF, 616-byte) detection size flowing until a stop/start. Stopping
        # here lets the applied mask take effect and the pipe drain to the new size.
        self.send_cmd(CMD_STOP)
        time.sleep(0.02)

        ok = (self.send_cmd(CMD_SET_PHASE, result.best_phase0, result.best_phase0)[0] and
              self.send_cmd(CMD_SET_PHASE_B, result.best_phase1, result.best_phase1)[0] and
              self.send_cmd(CMD_SET_CHANNEL_ENABLE, result.optimal_channel_mask)[0] and
              self.send_cmd(CMD_LOAD_CONVERT)[0])

        if ok and self.validator is not None:
            # Match the plugin's setChannelEnable -> updateChannelEnable so the
            # validator sizes subsequent streaming packets to the applied mask.
            self.validator.set_channel_enable(result.optimal_channel_mask)
        return ok

    def _initialize_chips(self, verbose) -> bool:
        """Prepare for detection: real (non-debug) data, infinite loop count,
        ce=0xFF (both ports), run the init sequence once, then load the cable
        test sequence (mirror initializeForDetection)."""
        if verbose:
            print("[Detection] Initializing chips (dual-port, channel_enable=0xFF)...")

        # Disable debug mode so we read real chip data.
        if not self.send_cmd(CMD_STOP)[0]:
            return False
        time.sleep(0.01)
        if not self.send_cmd(CMD_SET_DEBUG_MODE, 0)[0]:
            return False
        time.sleep(0.01)

        # loop_count = 0 (infinite): a finite count stops before the firmware's
        # read-pointer resync and emits zero UDP.
        if not self.send_cmd(CMD_SET_LOOP_COUNT, DETECTION_LOOP_COUNT)[0]:
            return False
        time.sleep(0.01)

        # channel_enable = 0xFF: both ports' CIPO0/CIPO1 land in one packet.
        if not self.send_cmd(CMD_SET_CHANNEL_ENABLE, DETECTION_CHANNEL_ENABLE)[0]:
            return False
        if self.validator is not None:
            # Size the validator to the dual-port packet or it rejects every
            # detection packet as wrong-size before feeding the detector.
            self.validator.set_channel_enable(DETECTION_CHANNEL_ENABLE)
        time.sleep(0.01)

        # Run the initialization sequence (acquire briefly, then stop).
        if not self.send_cmd(CMD_LOAD_INIT)[0]:
            return False
        time.sleep(0.01)
        if not self.send_cmd(CMD_START)[0]:
            return False
        time.sleep(0.1)
        if not self.send_cmd(CMD_STOP)[0]:
            return False
        time.sleep(0.01)

        # Load the cable test sequence used by the phase sweep.
        if not self.send_cmd(CMD_LOAD_CABLE_TEST)[0]:
            return False
        time.sleep(0.01)
        return True

    def _test_phase(self, phase: int, lanes, verbose: bool):
        """Set both port phases to `phase`, capture one packet, and score all
        four CIPO lanes (mirror testPhaseParallel). Returns (scores, types) as
        4-element lists, or (None, None) if no packet arrived."""
        # Stop, set both ports' phases, then capture one packet.
        self.send_cmd(CMD_STOP)
        time.sleep(0.002)

        if not (self.send_cmd(CMD_SET_PHASE, phase, phase)[0] and
                self.send_cmd(CMD_SET_PHASE_B, phase, phase)[0]):
            return None, None
        time.sleep(0.005)

        # Arm capture (clear stale packets first, like startDetectionCapture).
        self._drain_queue()
        self.capturing = True

        if not self.send_cmd(CMD_START)[0]:
            self.capturing = False
            return None, None

        try:
            packet = self.packet_queue.get(timeout=1.0)
        except queue.Empty:
            packet = None
        finally:
            self.send_cmd(CMD_STOP)
            self.capturing = False

        if packet is None:
            if verbose:
                print(f"  Phase {phase}: No packet received")
            return None, None

        scores = [0.0, 0.0, 0.0, 0.0]
        types = [CHIP_TYPE_NONE, CHIP_TYPE_NONE, CHIP_TYPE_NONE, CHIP_TYPE_NONE]
        for i in range(4):
            scores[i], types[i] = self._score_channel(
                packet, lanes[i].stride, lanes[i].offset, lanes[i].label, verbose)
        return scores, types

    def _score_channel(self, packet: List[int], stride: int, offset: int,
                       label: str, verbose: bool) -> Tuple[float, str]:
        """Score one CIPO lane out of a cable-test packet (mirror scoreChannel).

        Data words start at CABLE_TEST_DATA_OFFSET_WORDS (14). With ce=0xFF each
        SPI cycle packs 4 words (one per lane); stride=4, offset 0..3 select the
        lane. Each 32-bit word holds the regular stream in bits [15:0] and the
        DDR stream in [31:16]. Cable test reads (with a 2-cycle pipeline delay):
          data idx 2-6: INTAN pattern   idx 7: chip ID   idx 8: MISO register
        """
        if len(packet) < CABLE_TEST_DATA_OFFSET_WORDS + 9 * stride:
            return 0.0, CHIP_TYPE_NONE

        data_words = packet[CABLE_TEST_DATA_OFFSET_WORDS:]
        if len(data_words) < 35:
            return 0.0, CHIP_TYPE_NONE

        channel_words = [data_words[i] for i in range(offset, len(data_words), stride)]
        if len(channel_words) < 9:
            return 0.0, CHIP_TYPE_NONE

        regular = [w & 0xFFFF for w in channel_words]
        ddr = [(w >> 16) & 0xFFFF for w in channel_words]

        score = 0.0
        chip_type = CHIP_TYPE_NONE

        # INTAN pattern (regular indices 2-6 due to the 2-cycle pipeline delay).
        intan_found = []
        for i, expected in enumerate(INTAN_PATTERN):
            idx = i + 2
            if idx < len(regular):
                intan_found.append(regular[idx])
                if regular[idx] == expected:
                    score += 10.0

        # Chip ID at index 7 (regular and DDR should agree for an RHD2164).
        if len(regular) > 7 and len(ddr) > 7:
            chip_id_reg = regular[7]
            chip_id_ddr = ddr[7]
            if chip_id_reg == CHIP_ID_RHD2164 and chip_id_ddr == CHIP_ID_RHD2164:
                chip_type = CHIP_TYPE_RHD2164
                score += 10.0
            elif chip_id_reg == CHIP_ID_RHD2132:
                chip_type = CHIP_TYPE_RHD2132
                score += 10.0
            elif chip_id_reg == CHIP_ID_RHD2216:
                chip_type = CHIP_TYPE_RHD2132  # treat as RHD2132 (no DDR)
                score += 10.0

        # MISO register at index 8.
        if len(regular) > 8 and len(ddr) > 8:
            miso_reg = regular[8]
            miso_ddr = ddr[8]
            if chip_type == CHIP_TYPE_RHD2164:
                if miso_reg == MISO_REG_DDR and miso_ddr == MISO_DDR_DDR:
                    score += 10.0
            elif chip_type == CHIP_TYPE_RHD2132:
                if miso_reg == MISO_NO_DDR:
                    score += 10.0

        if verbose and score > DETECTION_THRESHOLD:
            pattern_str = ''.join(chr(v) if 0x20 <= v <= 0x7E else '?' for v in intan_found)
            print(f"    {label}: '{pattern_str}' ({chip_type})")

        return score, chip_type

def calculate_data_words(channel_enable):
    """Number of 32-bit data words for the 8-bit channel_enable mask.
    [3:0] = port 0 streams, [7:4] = port 1 (dual cable)."""
    num_channels = bin(channel_enable & 0xFF).count('1')
    if num_channels == 0:
        return 70
    total_16bit_words = 35 * num_channels
    return (total_16bit_words + 1) // 2

# Broadband framing (unified format): 8-word common header + 6-word broadband
# sub-block = 14 header words ahead of the data (docs/unified-packet-format.md).
BB_HEADER_WORDS = 14

def calculate_packet_size(channel_enable):
    """Total broadband packet size in words (header + data). Up to 14 + 140 = 154."""
    return BB_HEADER_WORDS + calculate_data_words(channel_enable)

# ---------------------------------------------------------------------------
# Debug-mode sine reference model.
#
# In debug mode the PL fills every CIPO line with a synthetic sine, so we can
# verify the data path end-to-end with NO chip attached. This mirrors
# data_generator_core.sv exactly (proven bit-identical by
# programmable_logic/sim/dualport_dropout_tb.sv):
#
#   sine_lut[i] = rtoi(32767.0/16 * sin(2*pi*i/512) + 32767.0)     i in 0..511
#   per acquisition cycle c (0..34):  coff = max(c-2, 0)
#       base_phase   bp  = (dummy_data_index + coff) & 0x1FF
#       base_phase_p1 b1 = (bp + 128) & 0x1FF
#   8 segments, in channel_enable bit order:
#       bit0 A_CIPO0_REG=lut[bp]      bit1 A_CIPO0_DDR=lut[bp<<1]
#       bit2 A_CIPO1_REG=lut[bp<<2]   bit3 A_CIPO1_DDR=lut[bp<<3]
#       bit4 B_CIPO0_REG=lut[b1]      bit5 B_CIPO0_DDR=lut[b1<<1]
#       bit6 B_CIPO1_REG=lut[b1<<2]   bit7 B_CIPO1_DDR=lut[b1<<3]
# dummy_data_index increments by 1 per packet, in lockstep with the timestamp,
# so after locking it on one packet we predict it for any other from the
# timestamp delta -- which lets us tell genuine corruption (wrong values) apart
# from packet loss (correct values, missing timestamps).
# ---------------------------------------------------------------------------

# Human-readable name for each enable bit (== segment-within-cycle order).
SEG_NAMES = ["A_CIPO0_REG", "A_CIPO0_DDR", "A_CIPO1_REG", "A_CIPO1_DDR",
             "B_CIPO0_REG", "B_CIPO0_DDR", "B_CIPO1_REG", "B_CIPO1_DDR"]

def build_sine_lut():
    """512-entry unsigned-16-bit sine LUT, identical to the RTL initial block.
    SV $rtoi truncates toward zero; the argument is always positive here, so
    Python int() matches it exactly."""
    return [int(32767.0 / 16.0 * math.sin(2.0 * math.pi * i / 512.0) + 32767.0) & 0xFFFF
            for i in range(512)]

def _debug_seg_values(bp, lut):
    """The 8 segment values (bit0..bit7) for a given base phase bp."""
    b1 = (bp + 128) & 0x1FF
    return [lut[bp],                  lut[(bp << 1) & 0x1FF],
            lut[(bp << 2) & 0x1FF],   lut[(bp << 3) & 0x1FF],
            lut[b1],                  lut[(b1 << 1) & 0x1FF],
            lut[(b1 << 2) & 0x1FF],   lut[(b1 << 3) & 0x1FF]]

def expected_debug_segments(channel_enable, ddi, lut):
    """Flat list of expected 16-bit segments for one debug packet at index ddi,
    plus matching (cycle, bit) metadata. Order == the PL's tight packing."""
    enabled_bits = [b for b in range(8) if channel_enable & (1 << b)]
    segs, meta = [], []
    for cycle in range(35):
        coff = (cycle - 2) if cycle >= 2 else 0
        vals = _debug_seg_values((ddi + coff) & 0x1FF, lut)
        for b in enabled_bits:
            segs.append(vals[b])
            meta.append((cycle, b))
    return segs, meta

def unpack_data_segments(data_words, n_seg):
    """Unpack n_seg tightly-packed 16-bit segments (low half first) from the
    32-bit data words of a packet."""
    segs = []
    for w in data_words:
        segs.append(w & 0xFFFF)
        segs.append((w >> 16) & 0xFFFF)
    return segs[:n_seg]

def channel_enable_to_string(channel_enable):
    """Convert channel enable bits to human readable string (both ports)"""
    names = ["A_CIPO0_REG", "A_CIPO0_DDR", "A_CIPO1_REG", "A_CIPO1_DDR",
             "B_CIPO0_REG", "B_CIPO0_DDR", "B_CIPO1_REG", "B_CIPO1_DDR"]
    channels = [names[b] for b in range(8) if channel_enable & (1 << b)]
    return ", ".join(channels) if channels else "NONE"

def get_local_ip():
    """Get the local IP address that can reach the Zynq"""
    try:
        # Create a socket to determine which interface would be used
        s = socket.socket(socket.AF_INET, socket.SOCK_DGRAM)
        s.connect((ZYNQ_IP, TCP_PORT))
        local_ip = s.getsockname()[0]
        s.close()
        return local_ip
    except:
        return "127.0.0.1"

class DataValidator:
    def __init__(self):
        self.last_timestamp = None
        self.packet_count = 0
        self.error_count = 0
        self.start_time = None
        self.timestamp_errors = 0
        self.magic_errors = 0
        self.size_errors = 0
        # Per-stream SEQ continuity = the broadband loss check (unified format,
        # header word 4). MUST stay 0 for the archival broadband stream.
        self.last_seq = None
        self.seq_gaps = 0          # broadband gap count (the no-loss assertion)
        self.seq_lost_packets = 0  # total packets implied missing by the gaps
        self.last_stats_time = None
        self.last_packet_count = 0
        self.last_packet_raw = None
        self.last_packet_words = None
        self.current_channel_enable = 0x0F
        self.expected_packet_size_bytes = calculate_packet_size(0x0F) * 4
        self.expected_packet_size_words = calculate_packet_size(0x0F)
        self._manual_queue = queue.Queue()
        self._manual_lock = threading.Lock()

        # Cable detection integration
        self.cable_detector = None

        # Debug-sine verification capture
        self.sine_capture_active = False
        self.sine_capture_target = 0
        self.sine_capture_ce = 0xFF
        self.sine_capture = []   # list of (timestamp, tuple-of-data-words)

    def set_cable_detector(self, detector):
        """Set cable detector for packet capture integration"""
        self.cable_detector = detector

    def set_channel_enable(self, channel_enable):
        """Update channel enable setting and recalculate packet sizes"""
        self.current_channel_enable = channel_enable
        self.expected_packet_size_words = calculate_packet_size(channel_enable)
        self.expected_packet_size_bytes = self.expected_packet_size_words * 4
        print(f"[INFO] Channel enable updated to 0x{channel_enable:X}")
        print(f"[INFO] Enabled channels: {channel_enable_to_string(channel_enable)}")
        print(f"[INFO] Expected packet size: {self.expected_packet_size_words} words ({self.expected_packet_size_bytes} bytes)")

    def start_cable_test_capture(self):
        global cable_test_mode, cable_test_packets_captured
        cable_test_mode = True
        cable_test_packets_captured = 0
        print("Starting cable test packet capture...")

    def start_manual_cable_test(self):
        global manual_cable_test_mode
        manual_cable_test_mode = True
        with self._manual_lock:
            while not self._manual_queue.empty():
                try:
                    self._manual_queue.get_nowait()
                except queue.Empty:
                    break
        print("Manual cable test mode started")

    def wait_for_manual_packet(self, timeout=5.0):
        try:
            return self._manual_queue.get(timeout=timeout)
        except queue.Empty:
            return None

    def get_manual_test_packets(self):
        global manual_cable_test_mode
        packets = []
        with self._manual_lock:
            while not self._manual_queue.empty():
                try:
                    packets.append(self._manual_queue.get_nowait())
                except queue.Empty:
                    break
        manual_cable_test_mode = False
        return packets
        
    def start_sine_capture(self, channel_enable, n_packets):
        """Begin stashing data words for debug-sine verification."""
        self.sine_capture_ce = channel_enable
        self.sine_capture_target = n_packets
        self.sine_capture = []
        self.sine_capture_active = True

    def analyze_sine_capture(self, write_ptr=None):
        """Verify the captured debug packets against the RTL sine reference.
        Reports value correctness (per CIPO line / REG-DDR) and packet loss
        (from timestamp gaps), and tells the two apart. write_ptr (optional) is
        the BRAM word write pointer read at stop, used to print absolute BRAM
        addresses for the most-recent corrupted samples."""
        cap = self.sine_capture
        ce = self.sine_capture_ce
        if len(cap) < 2:
            print("[SINE] Not enough packets captured to verify "
                  f"({len(cap)}). Is the board streaming in debug mode?")
            return

        lut = build_sine_lut()
        ndw = calculate_data_words(ce)
        n_seg = 35 * bin(ce & 0xFF).count('1')
        enabled_bits = [b for b in range(8) if ce & (1 << b)]

        ts0 = cap[0][0]
        # Lock the debug index jointly over the first packets (robust to a
        # corrupted lead packet): pick ddi0 minimizing total mismatch when each
        # packet's index is predicted from its timestamp delta.
        lock_n = min(len(cap), 20)
        exp_cache = {}
        def exp_segs(ddi):
            if ddi not in exp_cache:
                exp_cache[ddi] = expected_debug_segments(ce, ddi, lut)[0]
            return exp_cache[ddi]
        best_ddi0, best_total = 0, None
        for ddi0 in range(512):
            tot = 0
            for ts, dw in cap[:lock_n]:
                ddi = (ddi0 + (ts - ts0)) & 0x1FF
                got = unpack_data_segments(dw, n_seg)
                exp = exp_segs(ddi)
                tot += sum(1 for a, b in zip(got, exp) if a != b)
                if best_total is not None and tot >= best_total:
                    break
            if best_total is None or tot < best_total:
                best_total, best_ddi0 = tot, ddi0

        # Single-segment reference value (for alias checks below).
        def seg_val(ddi, cyc, bit):
            return _debug_seg_values((ddi + (cyc - 2 if cyc >= 2 else 0)) & 0x1FF, lut)[bit]
        lut_lo, lut_hi = min(lut), max(lut)

        # Verify every captured packet at its predicted index.
        _, meta = expected_debug_segments(ce, 0, lut)   # (cycle,bit) layout is index-independent
        seg_bad = {b: 0 for b in enabled_bits}
        cycle_bad = [0] * 35
        total_seg = 0
        total_bad = 0
        exact_pkts = 0
        mism_list = []        # (pkt_idx, word_in_pkt, ddi, cyc, bit, exp, got)
        for pkt_idx, (ts, dw) in enumerate(cap):
            ddi = (best_ddi0 + (ts - ts0)) & 0x1FF
            got = unpack_data_segments(dw, n_seg)
            exp = exp_segs(ddi)
            bad = 0
            for i in range(n_seg):
                total_seg += 1
                if got[i] != exp[i]:
                    bad += 1
                    cyc, bit = meta[i]
                    seg_bad[bit] += 1
                    cycle_bad[cyc] += 1
                    word_in_pkt = 10 + (i // 2)   # 10 header words, then 2 segs/word
                    if len(mism_list) < 20000:
                        mism_list.append((pkt_idx, word_in_pkt, ddi, cyc, bit, exp[i], got[i]))
            total_bad += bad
            if bad == 0:
                exact_pkts += 1

        # Packet loss from timestamp span vs packets received.
        ts_span = cap[-1][0] - ts0 + 1
        received = len(cap)
        dropped = max(0, ts_span - received)
        loss_pct = 100.0 * dropped / ts_span if ts_span > 0 else 0.0

        print("\n" + "=" * 64)
        print("  DEBUG SINE VERIFICATION")
        print("=" * 64)
        print(f"  channel_enable : 0x{ce:02X}  ({channel_enable_to_string(ce)})")
        print(f"  packets verified: {received}   data words/packet: {ndw}")
        print(f"  debug index lock: ddi0={best_ddi0}  (advances 1/packet w/ timestamp)")
        print("-" * 64)
        # Value correctness
        if total_bad == 0:
            print(f"  VALUE CHECK : PASS - all {total_seg} samples bit-exact vs RTL reference")
        else:
            # Classify each mismatch by magnitude and by "alias" (does the wrong
            # value equal a neighbouring cycle/packet's correct value -> stale data).
            d1 = d_small = d_big = oor = 0          # |delta|==1, 2..16, >16, out-of-LUT-range
            a_prevpkt = a_nextpkt = a_prevcyc = a_nextcyc = a_otherbit = 0
            for (pkt_idx, wip, ddi, cyc, bit, e, g) in mism_list:
                ad = abs(g - e)
                if not (lut_lo <= g <= lut_hi):
                    oor += 1
                if ad == 1:
                    d1 += 1
                elif ad <= 16:
                    d_small += 1
                else:
                    d_big += 1
                if ad > 1:   # only chase aliases for non-rounding errors
                    if g == seg_val((ddi - 1) & 0x1FF, cyc, bit):       a_prevpkt += 1
                    elif g == seg_val((ddi + 1) & 0x1FF, cyc, bit):     a_nextpkt += 1
                    elif cyc > 0  and g == seg_val(ddi, cyc - 1, bit):  a_prevcyc += 1
                    elif cyc < 34 and g == seg_val(ddi, cyc + 1, bit):  a_nextcyc += 1
                    elif any(g == seg_val(ddi, cyc, ob) for ob in enabled_bits if ob != bit):
                        a_otherbit += 1
            sampled = len(mism_list)
            real = d_small + d_big   # |delta| > 1 == not LSB rounding

            print(f"  VALUE CHECK : FAIL - {total_bad}/{total_seg} samples wrong "
                  f"({100.0*total_bad/total_seg:.3f}%), {exact_pkts}/{received} packets perfect")
            print(f"  magnitude   : |d|=1: {d1}   |d|=2..16: {d_small}   "
                  f"|d|>16: {d_big}   outside-LUT: {oor}   (of {sampled} sampled)")
            print(f"  real errors (|d|>1): {real}  -> "
                  f"{'NONE - all diffs are 1 LSB' if real == 0 else 'see breakdown'}")
            # Breakdown of the REAL (non-rounding) errors only.
            if real > 0:
                rc = [0] * 35
                rb = {b: 0 for b in enabled_bits}
                word_hist = {}
                for (pkt_idx, wip, ddi, cyc, bit, e, g) in mism_list:
                    if abs(g - e) > 1:
                        rc[cyc] += 1
                        rb[bit] += 1
                        word_hist[wip] = word_hist.get(wip, 0) + 1
                print("  real by channel: " +
                      "  ".join(f"{SEG_NAMES[b]}={rb[b]}" for b in enabled_bits if rb[b]))
                worst = sorted(((rc[c], c) for c in range(35) if rc[c]), reverse=True)[:8]
                print("  real worst cyc : " +
                      ", ".join(f"cyc{c}({n})" for n, c in worst))
                # Packet-WORD-offset histogram: corruption that is fixed at a
                # buffer/transaction offset (not a cycle) shows up here as a tight
                # cluster of word indices, independent of channel_enable.
                wtop = sorted(word_hist.items(), key=lambda kv: -kv[1])[:10]
                print("  real worst word: " +
                      ", ".join(f"w{w}({n})" for w, n in sorted(wtop)))
                if max(a_prevpkt, a_nextpkt, a_prevcyc, a_nextcyc, a_otherbit) > 0:
                    print(f"  alias of real  : prev-pkt={a_prevpkt} next-pkt={a_nextpkt} "
                          f"prev-cyc={a_prevcyc} next-cyc={a_nextcyc} other-chan={a_otherbit}")
                # ---- BRAM navigation: where does the MOST RECENT corruption sit
                #      relative to the end of the capture (= the PL write pointer
                #      when streaming stopped)? words_back = how many BRAM words to
                #      step backward from the final write pointer to reach it. ----
                last_idx = received - 1
                recent = [m for m in mism_list if abs(m[6] - m[5]) > 1]
                recent_pkt = max(m[0] for m in recent)
                rmism = sorted([m for m in recent if m[0] == recent_pkt], key=lambda m: m[1])
                pkts_from_end = last_idx - recent_pkt
                print(f"  --- most-recent corruption: {pkts_from_end} packet(s) before the "
                      f"end of capture ---")
                print(f"      (final captured packet = index {last_idx}; PL write pointer at "
                      f"stop is just past it)")
                psize = self.expected_packet_size_words
                for (pkt_idx, wip, ddi, cyc, bit, e, g) in rmism[:8]:
                    words_back = pkts_from_end * psize + (psize - wip)
                    if write_ptr is not None:
                        abs_word = (write_ptr - words_back) % 16384   # BRAM = 16384 words
                        addr = 0x80000000 + abs_word * 4
                        win = (abs_word - 24) % 16384   # widen: sub-packet capture/stop gap
                        loc = (f"~BRAM word {abs_word} = 0x{addr:08X}  "
                               f"(dump_bram {win} 48  -- search this window)")
                    else:
                        loc = f"~{words_back} words before write ptr (wrptr-{words_back})"
                    print(f"      pkt-{pkts_from_end:>2} word {wip:>3} {SEG_NAMES[bit]:<12} "
                          f"0x{e:04X}->0x{g:04X}   {loc}")
                print("  examples (pkt#-from-end, word, chan, expected -> got, delta):")
                shown = 0
                for (pkt_idx, wip, ddi, cyc, bit, e, g) in mism_list:
                    if abs(g - e) > 1:
                        print(f"      pkt-{last_idx - pkt_idx:>3} word{wip:>3} {SEG_NAMES[bit]:<12} "
                              f"0x{e:04X} -> 0x{g:04X}  ({g - e:+d})")
                        shown += 1
                        if shown >= 12:
                            break
        print("-" * 64)
        # Packet loss
        verb = "PASS" if dropped == 0 else "LOSS"
        print(f"  PACKET LOSS : {verb} - received {received} of {ts_span} "
              f"expected over the capture ({dropped} dropped, {loss_pct:.2f}%)")
        print("-" * 64)
        # Interpretation
        real_errs = locals().get('real', 0)
        if total_bad == 0 and dropped == 0:
            print("  => Clean: the board generates and transmits debug data correctly.")
        elif total_bad == 0 and dropped > 0:
            print("  => Values are CORRECT but packets are being DROPPED. The data path")
            print("     is fine; this is transport loss (host socket buffer / rate).")
            print("     Try a bigger SO_RCVBUF, or compare board udp_packets_sent vs here.")
        elif total_bad > 0 and real_errs == 0:
            print("  => All differences are exactly 1 LSB. This is the synthesis-vs-")
            print("     simulation rounding of the sine ROM ($rtoi/$sin), NOT corruption.")
            print("     The transmitted sinewave is correct to within one count.")
            if dropped > 0:
                print(f"     (But {dropped} packets were also dropped - see PACKET LOSS.)")
        else:
            print("  => Genuine corruption: values differ by more than 1 LSB. See the")
            print("     real-error breakdown/aliases above. If they alias to a neighbour")
            print("     cycle/packet it is stale data (timing/FIFO); if random/out-of-LUT")
            print("     it is a bit error. Capture the BRAM (dump_bram) to localize.")
        print("=" * 64 + "\n")

    def validate_packet(self, data):
        global cable_test_mode, cable_test_packets_captured, manual_cable_test_mode

        self.packet_count += 1

        if cable_test_mode:
            if cable_test_packets_captured < 17:
                if len(data) == CABLE_TEST_PACKET_SIZE_BYTES:
                    words = struct.unpack(f'<{CABLE_TEST_PACKET_SIZE_WORDS}I', data)
                    self.last_packet_words = words
                    if cable_test_packets_captured == 0:
                        print(f"Packet {cable_test_packets_captured + 1} (Init): Word 12: 0x{words[12]:08X}, Word 13: 0x{words[13]:08X}")
                    else:
                        phase1 = cable_test_packets_captured - 1
                        print(f"Packet {cable_test_packets_captured + 1} (Phase1={phase1}): Word 12: 0x{words[12]:08X}, Word 13: 0x{words[13]:08X}")
                cable_test_packets_captured += 1
                if cable_test_packets_captured >= 17:
                    cable_test_mode = False
                    print("Cable test capture complete.")
                return None

        if manual_cable_test_mode:
            if len(data) == CABLE_TEST_PACKET_SIZE_BYTES:
                words = struct.unpack(f'<{CABLE_TEST_PACKET_SIZE_WORDS}I', data)
                try:
                    self._manual_queue.put_nowait(words)
                except queue.Full:
                    pass
                print("Captured manual test packet")
            return None

        if self.start_time is None:
            self.start_time = time.time()
            self.last_stats_time = self.start_time

        if len(data) != self.expected_packet_size_bytes:
            # During cable detection the expected size churns (0xFF -> the detected
            # mask) while packets are still in flight -- don't flag those as errors.
            if self.cable_detector is None:
                self.size_errors += 1
                self.error_count += 1
                print(f"[ERROR] Packet {self.packet_count}: Wrong size {len(data)}, expected {self.expected_packet_size_bytes}")
            return None

        try:
            # Full unpack: the aux command path (echoes in words 6/8, the slot-0 accel
            # reply at data word 34) IS what we're testing, so every data word must be
            # available. A full unpack sustains 30k packets/s and is not the throughput
            # bottleneck. struct.unpack accepts the memoryview from recv_into directly
            # (no copy). words is a plain int tuple, safe to keep.
            words = struct.unpack(f'<{self.expected_packet_size_words}I', data)
            self.last_packet_words = words

            # Feed packets to the cable detector during detection. Detection runs
            # with channel_enable=0xFF (both ports), so its packets are the
            # dual-port DETECTION_PACKET_SIZE_BYTES (616). The detector only queues
            # while capturing.
            if self.cable_detector and len(data) == DETECTION_PACKET_SIZE_BYTES:
                self.cable_detector.capture_packet(words)

            # Unified header: w0 = MAGIC (0xCAFEBABE), w1 = TYPE_VER (low byte =
            # stream_type, must be BROADBAND here; next byte = version).
            stream_type = words[1] & 0xFF
            version = (words[1] >> 8) & 0xFF
            if words[0] != UNIFIED_MAGIC or stream_type != STREAM_TYPE_BROADBAND:
                self.magic_errors += 1
                self.error_count += 1
                print(f"[ERROR] Packet {self.packet_count}: header mismatch "
                      f"(magic=0x{words[0]:08X} type={stream_type} ver={version})")
                return None

            timestamp = (words[3] << 32) | words[2]
            seq = words[4]   # per-stream broadband sequence (the loss check)

            # SEQ continuity check: each broadband packet's SEQ must be exactly
            # +1 (mod 2^32) from the previous. A gap = lost broadband packet(s).
            # During cable detection the stream is stopped/restarted per phase, so
            # the sequence legitimately resets -- those are not losses, so don't
            # count/print them while a detector is attached.
            if self.last_seq is not None and self.cable_detector is None:
                expected_seq = (self.last_seq + 1) & 0xFFFFFFFF
                if seq != expected_seq:
                    self.seq_gaps += 1
                    self.error_count += 1
                    missing = (seq - expected_seq) & 0xFFFFFFFF
                    self.seq_lost_packets += missing
                    print(f"[LOSS] Broadband SEQ gap: expected {expected_seq}, got "
                          f"{seq} (+{missing} missing). gap_count={self.seq_gaps}")
            self.last_seq = seq

            # Debug-sine capture: stash data words for offline verification.
            if self.sine_capture_active and len(self.sine_capture) < self.sine_capture_target:
                self.sine_capture.append((timestamp, words[BB_HEADER_WORDS:]))
                if len(self.sine_capture) >= self.sine_capture_target:
                    self.sine_capture_active = False

            now = time.time()
            if self.packet_count % 30000 == 0 or (now - self.last_stats_time) >= 5.0:
                elapsed = now - self.start_time
                total_rate = self.packet_count / elapsed if elapsed > 0 else 0
                inst_rate = (self.packet_count - self.last_packet_count) / (now - self.last_stats_time) if (now - self.last_stats_time) > 0 else 0
                if len(words) >= BB_HEADER_WORDS + 4:
                    h = BB_HEADER_WORDS
                    data_sample = (f"Data: [0x{words[h]:08X}, 0x{words[h+1]:08X}, "
                                   f"0x{words[h+2]:08X}, 0x{words[h+3]:08X}]")
                else:
                    data_sample = "Data: [packet too short]"
                print(f"[INFO] Packet {self.packet_count}: ts={timestamp} seq={seq}, "
                      f"Rate: {total_rate:.1f} pkt/s (avg), {inst_rate:.1f} pkt/s (inst), "
                      f"Errors: {self.error_count} (seq_gaps={self.seq_gaps})")
                print(f"       {data_sample}")
                self.last_stats_time = now
                self.last_packet_count = self.packet_count

            return timestamp

        except struct.error as e:
            self.error_count += 1
            print(f"[ERROR] Packet {self.packet_count}: Failed to unpack: {e}")
            return None

    def print_last_packet_hex(self, words_per_line=8):
        if self.last_packet_words is None:
            print("[INFO] No packets received yet")
            return
            
        print(f"\n=== LAST PACKET - HEX DUMP ===")
        print(f"Packet size: {len(self.last_packet_words)} words")
        words = self.last_packet_words
        
        for i in range(0, len(words), words_per_line):
            chunk = words[i:i+words_per_line]
            hex_words = ' '.join(f'{w:08X}' for w in chunk)
            print(f"{i:2d}: {hex_words}")

    def print_aux_info(self):
        """Decode the aux command-echo metadata of the last received packet.
        Unified broadband header:
          word6 (AUX1) = {echo_slot0[31:16], flags[15:8], digital_in[7:0]}
          word8 (sub-block) = {echo_slot2_prev[31:16], echo_slot1_prev[15:0]}
        Result locations (SPI 2-command pipeline): slot-0's result is THIS
        packet's data word 34; slot-1/2 echoes label data words 0 and 1."""
        if self.last_packet_words is None or len(self.last_packet_words) < 9:
            print("[AUX] No packet captured yet")
            return
        w_aux1, w_echo = self.last_packet_words[6], self.last_packet_words[8]
        digital_in = w_aux1 & 0xFF
        flags = (w_aux1 >> 8) & 0xFF
        if not (flags & 0x01):
            print(f"[AUX] Sequencer inactive in last packet (digital_in=0x{digital_in:02X})")
            return
        echo0 = (w_aux1 >> 16) & 0xFFFF
        echo1 = w_echo & 0xFFFF
        echo2 = (w_echo >> 16) & 0xFFFF
        print(f"[AUX] digital_in=0x{digital_in:02X}  "
              f"fast_settle={bool(flags & 0x02)} digout={bool(flags & 0x04)} "
              f"dsp={bool(flags & 0x08)} echo_valid={bool(flags & 0x10)} "
              f"inject_result_in_word1={bool(flags & 0x20)}")
        print(f"[AUX] slot0 (result @ data word 34): {rhd_decode(echo0)}")
        print(f"[AUX] slot1 (result @ data word 0):  {rhd_decode(echo1)}")
        print(f"[AUX] slot2 (result @ data word 1):  {rhd_decode(echo2)}")

    def print_statistics(self):
        elapsed = time.time() - self.start_time if self.start_time else 0
        rate = self.packet_count / elapsed if elapsed > 0 else 0
        
        print(f"\n=== STATISTICS ===")
        print(f"Total packets: {self.packet_count}")
        print(f"Total errors: {self.error_count}")
        print(f"Elapsed time: {elapsed:.1f}s")
        print(f"Average rate: {rate:.1f} packets/second")
        if rate > 0:
            print(f"Data rate: {(rate * self.expected_packet_size_bytes * 8 / 1000000):.1f} Mbps")

validator = DataValidator()

def verify_debug_sine(sock, channel_enable=0xFF, n_packets=300):
    """Put the board in debug mode, capture N packets via the running UDP
    listener, and verify the received synthetic sinewaves against the RTL
    reference (data_generator_core.sv). Distinguishes genuine corruption from
    packet loss. Leaves the board stopped."""
    global validator
    print(f"[SINE] Debug-sine check: channel_enable=0x{channel_enable:02X}, "
          f"target {n_packets} packets")

    send_binary_command(sock, CMD_STOP)
    time.sleep(0.05)
    if not send_binary_command(sock, CMD_SET_DEBUG_MODE, 1)[0]:
        print("[SINE] Failed to enable debug mode"); return
    if not send_binary_command(sock, CMD_SET_CHANNEL_ENABLE, channel_enable)[0]:
        print("[SINE] Failed to set channel_enable"); return
    validator.set_channel_enable(channel_enable)

    validator.start_sine_capture(channel_enable, n_packets)
    if not send_binary_command(sock, CMD_START)[0]:
        print("[SINE] Failed to start streaming"); return

    # The udp_listener daemon thread fills validator.sine_capture.
    t_end = time.time() + 10.0
    while validator.sine_capture_active and time.time() < t_end:
        time.sleep(0.05)
    send_binary_command(sock, CMD_STOP)

    if validator.sine_capture_active:
        validator.sine_capture_active = False
        print(f"[SINE] Timed out with {len(validator.sine_capture)}/{n_packets} "
              f"packets. Is UDP reaching this host (run set_udp / check the network)?")

    # Read the BRAM write pointer after stop so the analysis can give absolute
    # BRAM addresses for corrupted samples (for dump_bram correlation). NOTE: the
    # PL usually writes a few packets between the last UDP packet this host got
    # and the stop, so treat the absolute address as the center of a small window.
    wrptr = None
    st = get_status(sock)
    if st is not None:
        wrptr = st.get('bram_write_addr')
        print(f"[SINE] BRAM write pointer at stop: {wrptr} (word) = "
              f"0x{0x80000000 + (wrptr or 0)*4:08X}")
    validator.analyze_sine_capture(write_ptr=wrptr)


# ---------------------------------------------------------------------------
# Unified UDP sink: ONE socket on UDP_PORT carrying ALL streams (broadband +
# LFP), demuxed by stream_type. This is the no-loss design from CLAUDE.md /
# docs/unified-packet-format.md:
#   * a tight recv->ring thread does the MINIMUM work (recvfrom -> queue), so
#     broadband is NEVER blocked while a slow consumer processes a packet;
#   * a demux thread pops from the ring, peeks header word 1 (stream_type), and
#     routes broadband -> DataValidator (which checks per-stream SEQ continuity
#     and prints the broadband gap count, which MUST be 0) and LFP -> the LFP
#     subscriber queues (receive_lfp / lfp_sweep read those).
# Big SO_RCVBUF so nothing is dropped while waiting.
# ---------------------------------------------------------------------------
class UnifiedSink:
    def __init__(self, port=UDP_PORT, rcvbuf=16 * 1024 * 1024, ring_max=200000):
        self.port = port
        self.rcvbuf = rcvbuf
        self._sock = None
        self._recv_thread = None
        self._running = False
        self._ring_drops = 0           # kept for the 'sink' command; always 0 in the
                                       # single-thread design (no host-side ring to overflow)
        # LFP fan-out (pub/sub): LFP frames (stream_type=2) are demuxed inline on the
        # single recv thread, then handed to subscribers -- no ring, no second thread.
        self._lfp_subs = []
        self._lfp_last_seq = None
        self._lfp_gaps = 0
        self.lfp_pkts = 0
        self.lfp_bytes = 0
        # IMU fan-out (stream_type=3): same inline pub/sub shape as LFP, with
        # SEQ continuity tracked PER PORT (each port is its own stream).
        self._imu_subs = []
        self._imu_last_seq = [None, None]
        self._imu_gaps = [0, 0]
        self.imu_pkts = 0
        self.bb_pkts = 0
        self.other_pkts = 0
        self.last_addr = None
        self._lock = threading.Lock()
        # last-timestamp continuity (broadband) handled inside DataValidator now

    def start(self):
        if self._running:
            return True
        sock = socket.socket(socket.AF_INET, socket.SOCK_DGRAM)
        sock.setsockopt(socket.SOL_SOCKET, socket.SO_REUSEADDR, 1)
        try:
            sock.setsockopt(socket.SOL_SOCKET, socket.SO_RCVBUF, self.rcvbuf)
            got = sock.getsockopt(socket.SOL_SOCKET, socket.SO_RCVBUF)
            eff = got // 2 if sys.platform.startswith("linux") else got
            msg = f"[UDP] SO_RCVBUF = {eff // 1024} KB"
            if eff < self.rcvbuf:
                if sys.platform == "darwin":
                    msg += " (clamped; raise it: sudo sysctl -w kern.ipc.maxsockbuf=33554432)"
                elif sys.platform.startswith("linux"):
                    msg += " (clamped; raise it: sudo sysctl -w net.core.rmem_max=33554432)"
                else:
                    msg += " (clamped by the OS socket-buffer cap)"
            print(msg)
        except OSError as e:
            print(f"[UDP] Could not set SO_RCVBUF: {e}")
        try:
            sock.bind(("", self.port))
        except OSError as e:
            print(f"[UDP] could NOT bind UDP {self.port}: {e}")
            return False
        sock.settimeout(1.0)
        self._sock = sock
        self._running = True
        self._recv_thread = threading.Thread(target=self._recv_loop, name="udp-recv", daemon=True)
        self._recv_thread.start()
        print(f"[UDP] Unified listener on port {self.port} (single-thread recv+demux+validate; "
              f"broadband + LFP on one port by stream_type)")
        return True

    def _recv_loop(self):
        # SINGLE-THREAD, ZERO-COPY hot path. recv_into a REUSED bytearray so NO fresh
        # bytes object is allocated per datagram -- recvfrom() allocated a ~600B copy
        # per packet = ~18 MB/s of malloc/free churn at 30k/s, the memory pressure we
        # care about. The parser gets a memoryview (no data copy) and unpacks only the
        # 5-word header; validate_packet unpacks the 145 data words LAZILY, only when a
        # consumer needs them. One thread: recv_into releases the GIL while it blocks,
        # then validate runs on the same thread -- no queue, no handoff (the two-thread
        # queue.Queue design capped ~25k). Same datagram structure; only plumbing changed.
        recv_into = self._sock.recv_into
        buf = bytearray(4096)
        view = memoryview(buf)
        validate = validator.validate_packet
        while self._running:
            try:
                n = recv_into(buf)              # no allocation, no copy -- fills buf
            except socket.timeout:
                continue
            except OSError:
                break
            if not n:
                continue
            # Demux by stream_type (header word 1, low byte). Broadband stays
            # ZERO-COPY -- validate the memoryview in place, one packet per datagram
            # (single-sample latency, no re-chunking). LFP is far lower rate
            # (decimated), so it's copied out of the reused buffer and fanned out.
            mv = view[:n]
            if n < UNIFIED_HEADER_WORDS * 4:
                self.other_pkts += 1
                continue
            if struct.unpack_from('<I', mv, 0)[0] != UNIFIED_MAGIC:
                self.other_pkts += 1
                continue
            type_ver = struct.unpack_from('<I', mv, 4)[0]
            stream_type = type_ver & 0xFF
            if stream_type == STREAM_TYPE_BROADBAND:
                # validate_packet returns the timestamp for a good broadband
                # packet, None otherwise.
                if validate(mv) is not None:
                    self.bb_pkts += 1
                else:
                    self.other_pkts += 1
            elif stream_type == STREAM_TYPE_LFP:
                # This is the SAME thread that has to keep up with the broadband
                # rate, so an LFP frame must cost almost nothing unless someone
                # is actually going to read it. Count and check SEQ in place --
                # no copy, no slice, no lock, no list -- and only pay for a copy
                # once a subscriber exists to receive one.
                self.lfp_pkts += 1
                self.lfp_bytes += n
                seq = struct.unpack_from('<I', mv, 16)[0]      # header word 4
                if self._lfp_last_seq is not None and \
                        seq != (self._lfp_last_seq + 1) & 0xFFFFFFFF:
                    self._lfp_gaps += 1
                self._lfp_last_seq = seq
                if self._lfp_subs:          # empty unless lfp_recv/lfp_sink is running
                    self._fanout_lfp(bytes(mv))
            elif stream_type == STREAM_TYPE_IMU:
                # 100 Hz worst case, but it rides the broadband thread, so the
                # same discipline as LFP: count + per-port SEQ check in place,
                # copy only when a subscriber (imu_recv / imu_csv) exists.
                self.imu_pkts += 1
                p = (type_ver >> 16) & 1
                seq = struct.unpack_from('<I', mv, 16)[0]      # header word 4
                if self._imu_last_seq[p] is not None and \
                        seq != (self._imu_last_seq[p] + 1) & 0xFFFFFFFF:
                    self._imu_gaps[p] += 1
                self._imu_last_seq[p] = seq
                if self._imu_subs:
                    self._fanout_imu(bytes(mv))
            else:
                self.other_pkts += 1

    def _fanout_lfp(self, data):
        """Hand a copied LFP frame to every subscriber. Only reached when at least
        one exists, which keeps the lock and the list copy off the recv path."""
        with self._lock:
            subs = list(self._lfp_subs)
        for q in subs:
            try:
                q.put_nowait(data)
            except queue.Full:
                pass

    def subscribe_lfp(self, maxsize=20000):
        q = queue.Queue(maxsize=maxsize)
        with self._lock:
            self._lfp_subs.append(q)
        return q

    def unsubscribe_lfp(self, q):
        with self._lock:
            if q in self._lfp_subs:
                self._lfp_subs.remove(q)

    def _fanout_imu(self, data):
        with self._lock:
            subs = list(self._imu_subs)
        for q in subs:
            try:
                q.put_nowait(data)
            except queue.Full:
                pass

    def subscribe_imu(self, maxsize=20000):
        q = queue.Queue(maxsize=maxsize)
        with self._lock:
            self._imu_subs.append(q)
        return q

    def unsubscribe_imu(self, q):
        with self._lock:
            if q in self._imu_subs:
                self._imu_subs.remove(q)

    def stop(self):
        self._running = False


def udp_listener():
    """Compatibility wrapper: start the unified sink (the real work is in its
    recv/demux threads). Kept so __main__ can spawn it like before."""
    global UNIFIED_SINK
    if UNIFIED_SINK is None:
        UNIFIED_SINK = UnifiedSink()
    UNIFIED_SINK.start()
    # Block this (daemon) thread until shutdown; print stats on exit.
    try:
        while UNIFIED_SINK._running:
            time.sleep(1.0)
    except KeyboardInterrupt:
        pass
    finally:
        validator.print_statistics()

def send_binary_command(sock, cmd_id, param1=0, param2=0, timeout=0.5):
    """Send a binary command and wait for ACK or data response"""
    try:
        ack_id = random.randint(1, 65535)
        command_data = struct.pack('<IIIII', CMD_MAGIC, cmd_id, ack_id, param1, param2)
        sock.sendall(command_data)
        
        sock.settimeout(timeout)
        
        # Read initial response (at least 3 bytes for ACK)
        response = sock.recv(5)
        
        if len(response) >= 3:
            recv_ack_id = (response[0] << 8) | response[1]
            status = response[2]
            
            if recv_ack_id != ack_id:
                print(f"[TCP] ACK ID mismatch: sent {ack_id}, got {recv_ack_id}")
                return (False, None)
            
            if status != ACK_SUCCESS:
                print(f"[TCP] Command failed (status: 0x{status:02X})")
                return (False, None)
            
            # Check if there's data (5-byte header)
            if len(response) == 5:
                data_len = (response[3] << 8) | response[4]
                if data_len > 0:
                    # Read the whole payload: one recv() is not guaranteed to
                    # return data_len bytes (a 68/288-byte status can split),
                    # and a short read here desyncs every later ack.
                    data = b''
                    while len(data) < data_len:
                        part = sock.recv(data_len - len(data))
                        if not part:
                            break
                        data += part
                    return (True, data)
            
            return (True, None)
        
        return (False, None)

    except socket.timeout:
        # Let timeout propagate to reconnection handler
        raise
    except Exception as e:
        print(f"[TCP] Error: {e}")
        raise
    finally:
        sock.settimeout(None)

# ============================================================================
# LFP/DSP engine (Tier-1) host control + receive
# ============================================================================
# ============================================================================
# Analytic chirp NCO (memory-free swept sine in the PL; reuses the sine LUT)
# ============================================================================
def chirp_fmax_to_fspan(f_max_hz):
    """Map a desired sweep top frequency (Hz) to the 12-bit f_span field.
    f_max = (fspan << 16) / 2^32 * 30000  ->  fspan = f_max/30000 * 2^16."""
    f_max_acc = f_max_hz / PACKET_RATE_HZ * (1 << CHIRP_PHW)
    fspan = round(f_max_acc) >> CHIRP_FSPAN_SHIFT
    return max(0, min(0xFFF, fspan))

def chirp_sweep_to_rate(f_max_hz, period_s):
    """Pick the 12-bit sweep_rate so one ramp (0->f_max) takes ~period_s/2
    (a full triangle period is `period_s`). freq_acc step/packet = rate<<9."""
    fmax_acc = (chirp_fmax_to_fspan(f_max_hz) << CHIRP_FSPAN_SHIFT)
    half_packets = max(1, PACKET_RATE_HZ * period_s / 2.0)
    rate = round((fmax_acc / half_packets)) >> CHIRP_RATE_SHIFT
    return max(1, min(0xFFF, rate))

def configure_chirp(sock, f_max_hz=1400.0, period_s=2.0, stride=4, enable=True):
    """Enable the analytic chirp debug signal: a swept sine 0->f_max->0 with a
    full triangle period of `period_s`, per-channel phase `stride`. Requires
    debug mode (set it too). Disable with enable=False (or CMD_SET_DEBUG_MODE 0).
    Default sweep ~1 Hz -> ~1.4 kHz covers the new 3 kHz LFP passband + transition."""
    fspan = chirp_fmax_to_fspan(f_max_hz)
    rate  = chirp_sweep_to_rate(f_max_hz, period_s)
    p1 = (1 if enable else 0) | ((stride & 0x3F) << 8)
    p2 = (fspan & 0xFFF) | ((rate & 0xFFF) << 16)
    if enable:
        send_binary_command(sock, CMD_SET_DEBUG_MODE, 1)
    send_binary_command(sock, CMD_SET_CHIRP, p1, p2)
    f_lo = 0.0
    f_hi = (fspan << CHIRP_FSPAN_SHIFT) / (1 << CHIRP_PHW) * PACKET_RATE_HZ
    print(f"[CHIRP] {'ENABLED' if enable else 'disabled'}: sweep {f_lo:.0f}->{f_hi:.0f} Hz, "
          f"period~{period_s:.1f}s, stride={stride} (fspan={fspan} rate={rate})")
    return fspan, rate

def _kaiser_window(num_taps, beta):
    """Kaiser window via the I0 Bessel series (no numpy dependency)."""
    import math
    def i0(x):
        s, t, k = 1.0, 1.0, 0
        while True:
            k += 1
            t *= (x * x) / (4 * k * k)
            s += t
            if t < 1e-12 * s:
                return s
    a = (num_taps - 1) / 2.0
    return [i0(beta * math.sqrt(1 - ((n - a) / a) ** 2)) / i0(beta)
            for n in range(num_taps)]

def lfp_upload_coeffs(sock, coeffs, stage=LFP_STAGE_DECIMATOR):
    """Stream taps into one filter of the cascade through the indirect window.

    The first write clears that stage's pointer, and every write carries the
    stage select, so uploading one filter never disturbs the other. This is a
    100+ command burst the board acks one-by-one, so use a generous per-command
    timeout and stop early with a clear message if an ack stalls -- that
    distinguishes a merely-slow board from a wedged one."""
    flags = (LFP_STAGE_DECIMATOR if stage == LFP_STAGE_DECIMATOR else 0) << 1
    for i, c in enumerate(coeffs):
        ok, _ = send_binary_command(sock, CMD_LFP_WRITE_COEF,
                                    flags | (1 if i == 0 else 0),
                                    c & 0x3FFFF, timeout=2.0)
        if not ok:
            name = "decimator" if stage == LFP_STAGE_DECIMATOR else "halfband"
            print(f"[LFP] {name} coefficient upload stalled at tap {i}/{len(coeffs)} -- "
                  f"the board stopped acking. Reconnect and 'ping': if it answers it's a "
                  f"timing issue, if it's dead the coef path wedged the firmware.")
            return False
    return True

def configure_lfp(sock, phase="linear", num_taps=None, coef_dir=None):
    """Upload a stage-2 filter and leave the cascade ready to stream.

    The board boots with both filters already loaded (see lfp_coef_pkg.sv), so
    this is only needed to CHANGE the stage-2 response -- most usefully to swap
    linear phase for minimum phase.

      phase="linear"  120-tap linear phase: exactly constant group delay, so
                      waveform shape is preserved. ~4.1 ms latency. The default,
                      and what the board powers up with.
      phase="minimum" 120-tap minimum phase: same magnitude response, ~0.9 ms
                      latency, but group delay varies ~0.66 ms across the
                      passband, which disperses waveform shape. Use it when
                      closed-loop latency matters more than shape fidelity.

    Coefficients come from the files programmable_logic/sim/design_lfp_filters.py
    generates, so the host and the RTL cannot drift apart; re-run that script to
    change the filters (it also reports ripple, alias rejection and latency).

    The lane mask is NOT set here: it mirrors the broadband channel-enable mask
    in the PL, so choose the streams to filter with `set_channels`.

    Decimation is structural (/2 then /5), so the output is always 3 kHz.
    Call lfp_enable(sock, True) afterwards to start streaming (stream_type=2)."""
    import os
    fn = {"linear": "lfp_poly120_lin_coefs.hex",
          "minimum": "lfp_poly120_min_coefs.hex"}.get(phase)
    if fn is None:
        raise ValueError(f"phase must be 'linear' or 'minimum', got {phase!r}")
    if coef_dir is None:
        coef_dir = os.path.join(os.path.dirname(os.path.abspath(__file__)),
                                "..", "programmable_logic", "sim")
    path = os.path.join(coef_dir, fn)
    coeffs = load_q117_hex(path)
    if num_taps:
        coeffs = coeffs[:num_taps]

    send_binary_command(sock, CMD_LFP_ENABLE, 0)
    send_binary_command(sock, CMD_LFP_SET_PARAMS, 0, len(coeffs) & 0xFF)
    if not lfp_upload_coeffs(sock, coeffs, LFP_STAGE_DECIMATOR):
        return None
    print(f"[LFP] stage 2 = {phase} phase, {len(coeffs)} taps "
          f"(stage 1 halfband unchanged) -> 3000 sps out")
    return coeffs
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
