glanceneuro/glance-neuro/firmware/src-core0/pl_i2c_probe.c

// SPDX-License-Identifier: MIT
// SPDX-FileCopyrightText: 2025-2026 Caleb Kemere, Rice University

#include "pl_i2c_probe.h"
#include "pl_imu_detect.h"   // IMUDET_*_BASE
#include "xiic_l.h"
#include "sleep.h"

// One address probe = START + address + STOP, with NO data phase at all, so it
// is non-destructive against every device rather than only against ones whose
// first byte is a register pointer. The blocking XIic_DynSend is NOT used: on a bus that is
// actually an LVDS lane it can spin forever, and this firmware has already
// paid once for an unbounded wait (the absent-slave hang) -- everything here
// runs against a deadline.
//
// Returns 1 with *ack set on a decided probe, 0 on deadline (bus wedged).
static int probe_addr(UINTPTR base, uint8_t addr7, int *ack)
{
    XIic_DynInit(base);
    XIic_ClearIisr(base, XIIC_INTR_TX_ERROR_MASK | XIIC_INTR_ARB_LOST_MASK);
    // START+STOP+address in ONE word: an address-only probe with no data phase.
    // The earlier form queued a 0x00 data byte, which is harmless to a
    // register-pointer device (BNO055, 24xx) but is a COMMAND to any device
    // that takes bare command bytes -- and a bus scan must not be able to
    // trigger a measurement or a soft reset on something it is merely looking
    // for. Same ACK/NACK semantics either way.
    XIic_WriteReg(base, XIIC_DTR_REG_OFFSET,
                  XIIC_TX_DYN_START_MASK | XIIC_TX_DYN_STOP_MASK
                  | ((uint32_t)addr7 << 1));

    int seen_busy = 0;
    for (int us = 0; us < 5000; us += 10) {
        uint32_t iisr = XIic_ReadIisr(base);
        if (iisr & (XIIC_INTR_TX_ERROR_MASK | XIIC_INTR_ARB_LOST_MASK)) {
            *ack = 0;
            return 1;                        // NACK -- decided, bus fine
        }
        uint32_t sr = XIic_ReadReg(base, XIIC_SR_REG_OFFSET);
        if (sr & XIIC_SR_BUS_BUSY_MASK) {
            seen_busy = 1;
        } else if ((sr & XIIC_SR_TX_FIFO_EMPTY_MASK) &&
                   (seen_busy || us >= 300)) {
            // FIFO drained, bus idle again (or never went busy in 300 us --
            // at 100 kHz the START must appear within ~100 us, so an idle
            // bus with an empty FIFO and no error means the write completed
            // between polls). No TX_ERROR latched -> the address was ACKed.
            *ack = 1;
            return 1;
        }
        usleep(10);
    }
    XIic_DynInit(base);                      // abort whatever is stuck
    return 0;
}

void pl_i2c_scan(int port, i2c_scan_response_t *out)
{
    UINTPTR base = port ? IMUDET_B_BASE : IMUDET_A_BASE;
    out->status = 0;
    out->version = I2C_SCAN_VERSION;
    for (int i = 0; i < 16; i++) out->bitmap[i] = 0;

    for (uint8_t a = I2C_SCAN_FIRST; a <= I2C_SCAN_LAST; a++) {
        int ack = 0;
        if (!probe_addr(base, a, &ack)) {
            // Wedged: report where and stop -- 100+ more deadlines on a dead
            // bus would stall the command loop for half a second to no end.
            out->status = 1u | ((uint32_t)a << 8);
            return;
        }
        if (ack)
            out->bitmap[a >> 3] |= (uint8_t)(1u << (a & 7));
    }
}

void pl_i2c_read(int port, uint8_t i2c_addr, int addr_width, uint16_t offset,
                 uint8_t nbytes, eeprom_read_response_t *out)
{
    UINTPTR base = port ? IMUDET_B_BASE : IMUDET_A_BASE;
    out->status = 0;
    out->nbytes = 0;
    out->version = EEPROM_READ_VERSION;
    for (int i = 0; i < EEPROM_READ_MAX; i++) out->data[i] = 0;
    if (nbytes > EEPROM_READ_MAX) nbytes = EEPROM_READ_MAX;
    if (nbytes == 0) return;

    // Combined write-then-read: offset write (1 or 2 big-endian bytes),
    // repeated START, n-byte read. The byte count goes in only once the core
    // has actually taken the bus -- the ordering the vendor's XIic_DynRecv
    // uses, and the one the IMU stream reproduces (docs/imu-ingestion.md).
    // BUS_BUSY does not assert on the register write, so this waits for it --
    // bounded, because this is a cold path and a bus that never goes busy must
    // not become a hang.
    XIic_DynInit(base);
    XIic_ClearIisr(base, XIIC_INTR_TX_ERROR_MASK | XIIC_INTR_ARB_LOST_MASK);
    XIic_WriteReg(base, XIIC_DTR_REG_OFFSET,
                  XIIC_TX_DYN_START_MASK | ((uint32_t)i2c_addr << 1));
    if (addr_width == 2)
        XIic_WriteReg(base, XIIC_DTR_REG_OFFSET, (offset >> 8) & 0xFF);
    XIic_WriteReg(base, XIIC_DTR_REG_OFFSET, offset & 0xFF);
    XIic_WriteReg(base, XIIC_DTR_REG_OFFSET,
                  XIIC_TX_DYN_START_MASK | ((uint32_t)i2c_addr << 1) | 1);

    int busy = 0;
    for (int us = 0; us < 5000; us += 10) {
        uint32_t iisr = XIic_ReadIisr(base);
        if (iisr & (XIIC_INTR_TX_ERROR_MASK | XIIC_INTR_ARB_LOST_MASK)) {
            XIic_DynInit(base);
            out->status = 1;                 // NACK on the address phase
            return;
        }
        if (XIic_ReadReg(base, XIIC_SR_REG_OFFSET) & XIIC_SR_BUS_BUSY_MASK) {
            busy = 1;
            break;
        }
        usleep(10);
    }
    if (!busy) {
        XIic_DynInit(base);
        out->status = 2;                     // bus never went busy
        return;
    }
    XIic_WriteReg(base, XIIC_DTR_REG_OFFSET, XIIC_TX_DYN_STOP_MASK | nbytes);

    // 32 bytes at 100 kHz is ~3.2 ms on the wire; 20 ms of deadline covers
    // clock stretching with room to spare.
    //
    // TAKE THE DATA FIRST, then judge errors. Ending a master receive means
    // NACKing the final byte, which latches TX_ERROR on a read that SUCCEEDED
    // -- the vendor's DynRecvData checks RX-not-empty before the error mask
    // and drops TX_ERROR from it once one byte remains. Checking errors first
    // loses the race against the last byte on a long read, and fails a 1-byte
    // read every time (the core arms NO_ACK before the address goes out).
    for (int us = 0; us < 20000; us += 10) {
        while (out->nbytes < nbytes &&
               !(XIic_ReadReg(base, XIIC_SR_REG_OFFSET) & XIIC_SR_RX_FIFO_EMPTY_MASK)) {
            out->data[out->nbytes++] =
                (uint8_t)XIic_ReadReg(base, XIIC_DRR_REG_OFFSET);
        }
        if (out->nbytes == nbytes) return;   // status 0: complete

        uint32_t iisr = XIic_ReadIisr(base);
        if ((iisr & XIIC_INTR_ARB_LOST_MASK) ||
            ((iisr & XIIC_INTR_TX_ERROR_MASK) && (nbytes - out->nbytes) > 1)) {
            XIic_DynInit(base);
            out->status = 1;                 // NACK (no device / bad offset width)
            return;
        }
        usleep(10);
    }
    XIic_DynInit(base);
    out->status = out->nbytes ? (3u | ((uint32_t)out->nbytes << 8)
                                     | ((uint32_t)nbytes << 16))
                              : 2u;
}
