glanceneuro/glance-neuro/firmware/src-core0/pl_dma.c

// SPDX-License-Identifier: MIT
// SPDX-FileCopyrightText: 2025-2026 Caleb Kemere, Reet Sinha, Allen Mikhailov, Rice University

// AXI CDMA capture-BRAM read path. See pl_dma.h for the rationale.
//
// Topology (design_1_bd.tcl): axi_cdma_0/M_AXI -> smartconnect_1 -> {
//   axi_bram_ctrl_0 (BRAM @0x80000000, read source),
//   processing_system7/S_AXI_HP0 (DDR, write dest) }.
// Control regs (S_AXI_LITE) at CDMA_BASEADDR via M_AXI_GP0/smartconnect_0.

#include "pl_dma.h"
#include "xaxicdma.h"
#include "xil_mmu.h"
#include "xil_cache.h"
#include "xil_types.h"
#include "main.h"          // BRAM_BASE_ADDR
#include "shared_print.h"

// Must match the S_AXI_LITE address assigned in design_1_bd.tcl.
#define CDMA_BASEADDR  0x44A00000U

// Linker-reserved 1 MB DDR staging buffer (see pl_dma.h). 1 MB-aligned so it
// owns exactly one 1 MB TLB section, which pl_dma_init() marks non-cacheable.
uint8_t pl_dma_staging[0x100000] __attribute__((aligned(0x100000)));

// Separate 1 MB-aligned non-cacheable staging buffer for the LFP stream, so the
// LFP path's CDMA + zero-copy pbuf never share/clobber the broadband staging
// buffer (the two run sequentially in the same loop, but each holds a pbuf
// reference into its own buffer until the EMAC transmits it).
uint8_t pl_dma_lfp_staging[0x100000] __attribute__((aligned(0x100000)));

static XAxiCdma cdma;
static int      cdma_ready = 0;

int pl_dma_init(void) {
    // The staging buffer lives in .bss (zeroed at startup as cached writes).
    // Clean those dirty lines to DDR, THEN mark its 1 MB section non-cacheable,
    // so no stale cache line can later evict over DMA'd data. After this the DMA
    // path needs no per-packet cache ops.
    Xil_DCacheFlushRange((UINTPTR)pl_dma_staging, sizeof(pl_dma_staging));
    Xil_SetTlbAttributes((UINTPTR)pl_dma_staging, NORM_NONCACHE_SHARED);
    // Same treatment for the LFP staging buffer.
    Xil_DCacheFlushRange((UINTPTR)pl_dma_lfp_staging, sizeof(pl_dma_lfp_staging));
    Xil_SetTlbAttributes((UINTPTR)pl_dma_lfp_staging, NORM_NONCACHE_SHARED);

    XAxiCdma_Config *cfg = XAxiCdma_LookupConfig(CDMA_BASEADDR);
    if (cfg == NULL) {
        boot_print("CDMA: LookupConfig(0x%08lX) failed\r\n",
                     (unsigned long)CDMA_BASEADDR);
        return -1;
    }
    if (XAxiCdma_CfgInitialize(&cdma, cfg, cfg->BaseAddress) != XST_SUCCESS) {
        boot_print("CDMA: CfgInitialize failed\r\n");
        return -2;
    }
    // Polled mode (avoids the dual-core GIC distributor init gotcha).
    XAxiCdma_IntrDisable(&cdma, XAXICDMA_XR_IRQ_ALL_MASK);
    cdma_ready = 1;
    boot_print("CDMA: ready (ctrl 0x%08lX, staging 0x%08lX)\r\n",
                 (unsigned long)CDMA_BASEADDR, (unsigned long)DMA_BUF_ADDR);

    // Smoke test: one CDMA transfer BRAM[0]->staging exercises the control path
    // (GP0 -> CDMA regs) and the data path (CDMA -> BRAM read, CDMA -> HP0/DDR
    // write). We only check it completes without error -- it confirms at boot
    // whether the CDMA datapath is wired/addressable before the stream relies on
    // it (the BRAM contents at boot are don't-care).
    {
        int rc = pl_dma_read_bram((uint32_t *)DMA_BUF_ADDR, 0, 8);
        if (rc == 0) boot_print("CDMA: self-test OK\r\n");
        else         boot_print("CDMA: self-test FAILED (rc=%d)\r\n", rc);
    }
    return 0;
}

// Generic CDMA read: copy n_words from an ARBITRARY PL/BRAM source byte address
// (e.g. the capture BRAM at 0x80000000 or the LFP output BRAM at 0x84000000) to
// dst (must be inside the non-cacheable DMA_BUF_ADDR section). Both source BRAMs
// are in the axi_cdma_0/Data address space (see design_1_bd.tcl).
int pl_dma_read_addr(uint32_t *dst, uintptr_t src_addr, uint32_t n_words) {
    if (!cdma_ready) return -1;

    int     nbytes = (int)(n_words * 4U);
    UINTPTR src    = (UINTPTR)src_addr;

    // BRAM is a PL slave (uncached) and dst is non-cacheable -> no cache ops.
    if (XAxiCdma_SimpleTransfer(&cdma, src, (UINTPTR)dst, nbytes, NULL, NULL)
            != XST_SUCCESS) {
        return -2;
    }

    // Poll for completion (sub-kB transfer is microseconds; guard bounds it).
    uint32_t guard = 0;
    while (XAxiCdma_IsBusy(&cdma)) {
        if (++guard > 100000000U) return -3;   // timeout
    }

    if (XAxiCdma_GetError(&cdma) != 0x0) {
        XAxiCdma_Reset(&cdma);
        while (!XAxiCdma_ResetIsDone(&cdma)) { }
        return -4;
    }
    return 0;
}

int pl_dma_read_bram(uint32_t *dst, uint32_t bram_word_addr, uint32_t n_words) {
    return pl_dma_read_addr(dst, (uintptr_t)(BRAM_BASE_ADDR + bram_word_addr * 4U),
                            n_words);
}
