glanceneuro/glance-neuro/(commit log)

2026-07-14 GLANCE: broadband neural acquisition (PL + firmware + host client)
    FPGA data-acquisition system for Intan RHD2000-style neural recording
    chips on a MicroZed (Zynq-7020) carrier board. The PL acquires up to
    256 channels @ 30 ksps over a DDR SPI protocol and streams them over
    UDP; TCP control and a host reference client live in remote/net.py.
    - programmable_logic/ : dual-cable Intan SPI acquisition, CIPO phase
    compensation, aux command sequencing + real-time fast settle, and
    AXI-CDMA exfiltration into the capture BRAM.
    - firmware/ : bare-metal dual-core PS -- fast UDP/TCP data loop on
    core 0, serial debug console on core 1.
    - remote/net.py : TCP control, UDP capture/validation, cable/ph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
2026-07-14 intan_spi IP: replace Vivado's AMD template header with the project license
    The custom Intan SPI interface definitions (VLNV kemerelab.org:intan:*) are
    first-party, but Vivado's interface packager had stamped its generic AMD
    "confidential/proprietary" template header on the generated .sv files. Reclaim
    them under the project's MIT license (SPDX), matching the rest of the tree.
2026-07-16 resources: downscale + re-encode PCB photos (~6x smaller)
    The board/PCB photos were up to 6300x8400 and multiple MB each -- far larger
    than needed for the README/docs (they render at 45-70% width). Downscale to
    <=2000 px (1500 px for the detailed board shots) and re-encode as optimized
    progressive JPEG; convert EpoxyOmnetics from a 1.9 MB RGBA PNG to JPEG and
    update its reference in docs/getting-started.md. resources/ drops from 15.3 MB
    to 2.4 MB (~6x) with no visible quality loss at display size.
2026-07-17 tests: add the two durable RTL sims + check-dma skill
    Verification for the broadband datapath, kept lean to the tests that guard
    shipped behavior on the active development path. Both sims assert intended
    behavior directly (spec-derived reference / AXI protocol), not a diff against
    prior code, and each header states what it guards and when it should
    legitimately fail:
    - dualport_dropout_tb : the no-data-loss regression guard -- full datapath at
    0xFF, no stuck channels, unified header well-formed, samples byte-exact vs
    the sine reference, SEQ/timestamp/index +1 per packet.
    - axi_lite_write_tb : the AXI-Lite write-handshake guard -- a write must
    complete for every legal AW/W ordering o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
2026-07-23 Aux command sequencing on by default (firmware/PL v2.0.0.0)
    The auxiliary command engine now runs continuously in every 30 kHz acquisition
    frame -- there is no separate enable step. Each frame carries three aux command
    slots alongside the amplifier channels:
    slot 0 accelerometer sweep (reply returns in-frame, no round trip)
    slot 1 fast-settle / status register
    slot 2 one-shot register inject (default: on-chip temperature)
    The host can now read or write any RHD register, and identify the headstage,
    inline with the data stream at single-sample latency.
    MAJOR version bump: the aux wire contract changed (the enable path is retired
    and the reg22 control semantics moved), so PL, firmwa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
2026-07-24 net.py: single-thread zero-copy receiver + aux register self-test
    The reference host reads each datagram into one reused buffer (no per-packet
    allocation or copy) and validates magic / per-stream SEQ inline on a single
    thread, sustaining the 30 kHz single-sample stream.
    Adds `aux_selftest`: reads the RHD 'INTAN' ROM and chip ID back through the aux
    inject slot and checks them per CIPO lane -- a deterministic pass/fail on the
    aux register path plus a "headstage connected and talking" check.
    The receiver's docstring also notes a macOS gotcha we hit: the OS silently
    filters incoming UDP to an ungranted Python binary (Local Network / firewall),
    which looks like packet loss but is a one-time pe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
    [net.py]
2026-07-24 Fix port-B phase reporting in get_status (+ rebuild BOOT.bin)
    publish_status_snapshot() read the port-B cable phases from the wrong bits of
    the CTRL_REG_2 mirror (status reg 8): >>16 / >>20, which land in the
    channel-enable field [23:16]. The PL mirrors CTRL_REG_2 verbatim and puts
    phase_b0 at [11:8] and phase_b1 at [15:12] (data_generator_core.sv), and the
    firmware write path (pl_set_phase_select_b) and register map agree -- so
    get_status was reporting the channel-enable nibbles as port-B phase.
    Read [11:8] / [15:12] instead. Firmware-only change: the PL/bitstream is
    unchanged (it was always correct); BOOT.bin regenerated from the existing
    bitstream + this firmware so the image tracks the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
    [main.c]
2026-07-29 On-PL LFP band: a two-stage FIR cascade, 30 kHz -> 3 kHz (firmware v2.1.0.0)
    Brings the LFP line onto main. A second PL stream (stream_type=2) decimates
    the 30 kHz broadband to a 3 kHz LFP band -- a polyphase /5 followed by two
    half-band /2 stages -- published on the SAME unified UDP port (0x6800) behind
    the shared 8-word header (unified_pkt_pkg.sv). Additive over 2.0.0.0: the
    broadband + aux wire contract is unchanged, so a 2.0.x host still interoperates.
    The LFP frame stamps w2/w3 with the master sample count of the NEWEST broadband
    sample in its decimation window -- the latest input that contributes to it. The
    FIR filters are causal, so that newest input is always already-acquired: the
    t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
2026-07-29 Retire the now-frozen LFP filter/packet testbenches
    The LFP DSP is frozen, so its benches shift from contract guards to
    documentation with a runtime cost (docs/TESTING.md: "a test over frozen code
    is documentation with a runtime cost; write documentation instead"). Removes
    the two filter benches (halfband /2, polyphase /5), the packet-assembly bench,
    their run_*.sh, and the two test-vector generators; updates TESTING.md (suite
    6 -> 3) and the lfp.md file table. Git history keeps them if the filter is
    ever reopened.
    Kept: design_lfp_filters.py (the design tool that regenerates the shipped
    *_coefs.hex + lfp_coef_pkg.sv -- not a test), the tracked coefficients, and
    dualport_dropout_tb.sv (guar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
2026-07-29 DAC70502 stimulus playback: PL engine, firmware driver, host API (firmware v2.2.0.0)
    Network-controlled stimulus playback through the carrier's DAC70502
    (docs/dac-stim-requirements.md is the agreed spec; docs/stim.md the as-built
    contract). Simulation-verified; bench bring-up checklist in docs/stim.md.
    Purely additive over 2.1.0.0 -- stim is control-only plus a new PL peripheral
    and adds no UDP stream, so the broadband/aux/LFP wire contract is unchanged and
    a 2.1.x host still interoperates.
    PL (new stim_top peripheral, third GP0 master at 0x43C00000, 128K aperture):
    16384-frame RAM (16 BRAM36), 240 kf/s master pacing with a runtime integer
    divider latched at start, START/LOOP/END playback i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
2026-07-30 Harden the hardware retrigger path: latch the edge + start-latch FRAME_COUNT (v2.2.0.1)
    Two fixes to stim_engine, both in the hw retrigger-restart path, each with a
    regression test. Wire contract unchanged; RTL bugfix over 2.2.0.0.
    - The retrigger edge was sampled only in S_RUN, so an edge landing in the 2-cycle
    S_RD/S_RD2 read pipeline (~0.6% of async edges at k=1) was dropped -- a real,
    min-pulse-validated edge lost because the engine watched a 1-clock pulse instead
    of latching it. Now latched into retrig_pending (mirroring the existing
    stop_pending) and serviced at the next S_RUN, so no validated edge is ever lost.
    Test 9b fires an edge into the read window (confirmed via a sta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
    [main.h, stim_engine.sv]
2026-07-30 Post-release cleanup: retire the frozen stim benches, drop the spec doc, README LFP/stim
    The DAC stimulus engine is frozen -- we won't change it further -- so its
    testbenches are now documentation with a runtime cost rather than guards over
    changing code (docs/TESTING.md). Remove stim_engine_tb + stim_axi_tb and their
    runners; git history keeps them (and the retrigger-hardening fix they cover) if
    the engine is ever reopened. The suite is back to the 3 TESTING.md already lists.
    Also:
    - drop docs/dac-stim-requirements.md (the planning spec; the as-built contract
    lives in docs/stim.md), and repoint net.py's two comment references to it.
    - README: add the on-PL LFP band and the DAC stim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
    [net.py]
2026-08-01 Runtime-swappable PL fabrics, headstage IMU and I2C probes (firmware v3.0.0.0)
    The board is no longer one fixed fabric. It carries a set of PL configurations
    on the SD card, swaps between them at runtime over a settled link, and picks the
    one that matches what is physically plugged in. Riding on that: each cable's
    freed second-CIPO pair is an I2C bus, and this release reads the BNO055 on it
    continuously as a fourth UDP stream, with generic bus-scan and EEPROM probes on
    the same wires.
    WHY MAJOR
    Not because the packet bytes broke -- broadband, LFP, aux and stim are
    byte-for-byte unchanged and status_response_t is still 288 B. It is MAJOR
    because what "the PL" is stopped being a build-time c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
    [acq_imu_both_pins.xdc, imu_host_mock.c, imu_host_mock.h, intan_spi_lvds_buffer_cipo0.v]
2026-08-01 Post-release cleanup: retire the deferred-boot design note, make the docs describe v3
    The standard pass after a release: fold what is still true into permanent homes,
    delete the planning material, and fix the places that still describe things which
    no longer exist. No behavior changes.
    docs/deferred-boot.md -> docs/boot.md
    The old file was 296 lines and self-labeled which sections were authoritative and
    which were superseded, which is a fine state for a design note mid-project and a
    bad one for reference material. docs/boot.md keeps the live content -- boot flow,
    the SD card inventory, the hardware-validated rules, the Zynq PCAP/XDcfg
    implementation path, and the two build-host prerequisit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
    [main.c, main.h, net.py, network.c, pl_loader.c, pl_loader.h]
